abaldezjr/tcc/figuras/p20x40p2.jpg

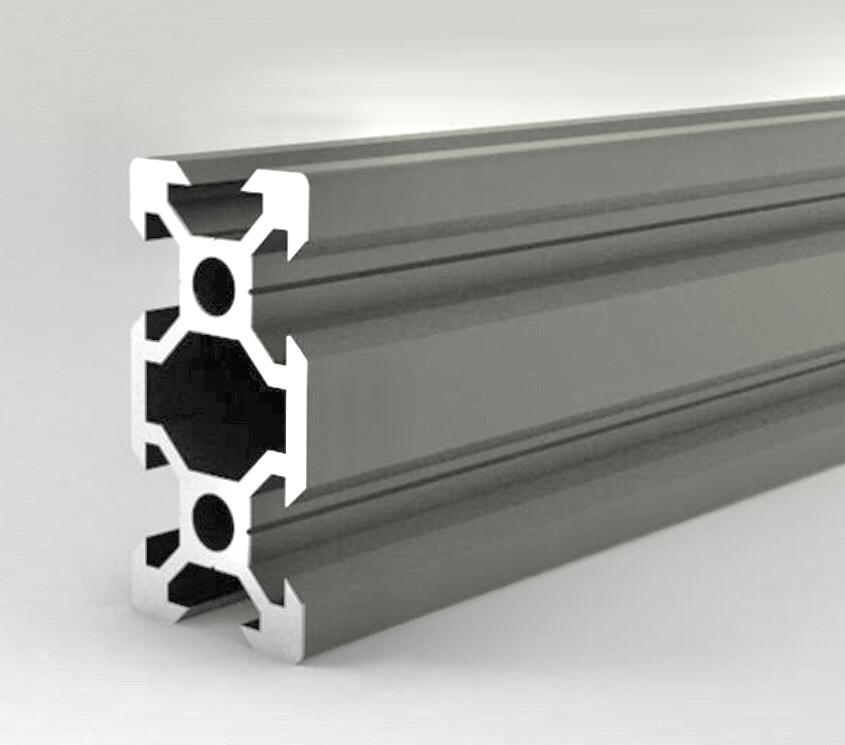
figuras/p20x40p2.jpg
