abaldezjr/tcc/figuras/driver.jpg

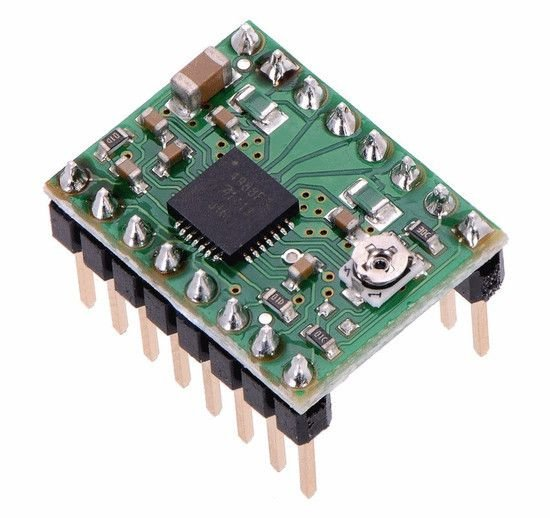
figuras/driver.jpg
