abaldezjr/tcc/README.md

# tcc-alex
 Esse repositório serve para disponibilizar uma versão em tex do meu trabalho de conclusão de curso.
