abaldezjr/tcc/elementos-pre-textuais/lista-de-simbolos.tex

\begin{simbolos} \itemsep -1pt
	\item[$d$] diâmetro da seção
	\item[$d_{arduino}$] Demanda do arduino
	\item[$d_{c}$] Diâmetro do colar
	\item[$d_{driver}$] Demanda do driver de potência
	\item[$d_{haste}$] Diâmetro da haste 
	\item[$d_{m}$] Diâmetro médio
	\item[$d_{motor}$] Demanda do motor de passo
	\item[$d_{opto}$] Demanda do optoacoplador
	\item[$d_{r}$] Diâmetro menor
	\item[$d_{total}$] Demanda total
	\item[$E$] Módulo de elasticidade
	\item[$f$] Coeficiente de fricção
	\item[$f_{c}$] Coeficiente de fricção no colar
	\item[$F$] Força
	\item[$g$] Aceleração gravitacional
	\item[$I$] Momento de inércia 
	\item[$L$] Comprimento da haste 
	\item[$L_{a}$] Avanço 
	\item[$n_{d}$] Número de dentes
	\item[$n_{e}$] Número de entradas
	\item[$n_{f}$] Número de fases
	\item[$n_{p}$] Número de passos
	\item[$P$] Passo
	\item[$P_{atm}$] Pressão atmosferica
	\item[$p_{d}$] Pressão dinâmica
	\item[$p_{e}$] Pressão estática
	\item[$p_{t}$] Pressão total
	\item[$\rho$] Massa específica
	\item[$R_{ar}$] Constante do ar
	\item[$\sigma$] Tensão normal axial
	\item[$T$] Torque
	\item[$\tau$] Tensão de cisalhamento
	\item[$T_{ar}$] Temperatura absoluta do ar
	\item[$V$] Velocidade do fluído
	\item[$Y_{max}$] Deflexão máxima 
	\item[$z$] Cota da altura
\end{simbolos}
