abaldezjr/tcc/elementos-pre-textuais/lista-de-abreviaturas-e-siglas.tex

\begin{acronym}
\acro{CNC}{Controle Numérico Computadorizado}
\acro{EEPROM}{\textit{Electrically Erasable Programmable Read-Only Memory}}
\acro{ICSP}{\textit{In Circuit Serial Programming}}
\acro{IDE}{\textit{Integrated Development Environment}}
\acro{PLA}{Poliácido Láctico}
\acro{PWM}{\textit{Pulse Width Modulation}}
\acro{RAM}{\textit{Random Access Memory}}
\acro{RISC}{\textit{Reduced Instruction Set Computer}}
\acro{USB}{\textit{Universal Serial Bus}}
\end{acronym}
