abaldezjr/tcc/elementos-pos-textuais/apendices/codigos.tex

\apendice{CÓDIGO PRINCIPAL PARA O CONTROLE DA MESA CARTESIANA}
\label{ap:MesaCartesiana}

\lstinputlisting[
    caption         = {Código principal para o controle da mesa cartesiana.}, 
    label           = code:MesaCartesiana,
    style           = mystyle
]{elementos-pos-textuais/apendices/MesaCartesiana.txt}

\apendice{CÓDIGO DA CLASSE EIXO PARA O CONTROLE DO EIXO}
\label{ap:Eixo}

\lstinputlisting[
    caption         = {Código da classe eixo para o controle do eixo.},
    label           = code:Eixo,
    style           = mystyle
]{elementos-pos-textuais/apendices/Eixo.txt}

\apendice{CÓDIGO DA CLASSE DRIVER PARA O CONTROLE DO DRIVER DE POTÊNCIA.}
\label{ap:Driver}

\lstinputlisting[
    caption         = {Código da classe driver para o controle do driver de potência},
    label           = code:Driver,
    style           = mystyle
]{elementos-pos-textuais/apendices/Driver.txt}

\apendice{CÓDIGO DA CLASSE PINO PARA O CONTROLE DOS PINOS}
\label{ap:Pino}

\lstinputlisting[
    caption         = {Código da classe Pino para o controle dos pinos.},
    label           = code:Pino,
    style           = mystyle
]{elementos-pos-textuais/apendices/Pino.txt}

\apendice{CÓDIGO DA CLASSE SIGMOIDAL PARA O CONTROLE DA ACELERAÇÃO DOS MOTORES}
\label{ap:Sigmoidal}

\lstinputlisting[
    caption         = {Código da classe Sigmoidal para o controle da aceleração dos motores.},
    label           = code:Sigmoidal,
    style           = mystyle
]{elementos-pos-textuais/apendices/Sigmoidal.txt}

\apendice{CÓDIGO DO HEADER STDRIVER PARA O INCLUDE DE CLASSES}
\label{ap:StepperDriver}

\lstinputlisting[
    caption         = {Código principal da biblioteca StDriver para o include de classes.},
    label           = code:StDriver,
    style           = mystyle
]{elementos-pos-textuais/apendices/StDriver.txt}
