abaldezjr/tcc/main.pdf

UNIVERSIDADE FEDERAL DO RIO GRANDE

ALEXANDRE MARQUES BALDEZ JUNIOR,

RODRIGO DE SOUZA TORMA

SISTEMA DE COORDENADAS PARA POSICIONAMENTO DE INSTRUMENTOS DE

MEDIÇÃO EM UM TÚNEL DE VENTO

RIO GRANDE, RIO GRANDE DO SUL

2021

ALEXANDRE MARQUES BALDEZ JUNIOR,

RODRIGO DE SOUZA TORMA

SISTEMA DE COORDENADAS PARA POSICIONAMENTO DE INSTRUMENTOS DE

MEDIÇÃO EM UM TÚNEL DE VENTO

Monografia apresentada à Universidade Federal do Rio Grande como requisito parcial para obtenção de título de Engenheiro Mecânico.

Orientador: Prof. Dr. Gustavo da Cunha Dias

Co-Orientador: Prof. Me. Letieri Rodrigues de Ávila

RIO GRANDE, RIO GRANDE DO SUL

370
S2373d | Marques Baldez Junior, Alexandre
| Sistema de Coordenadas para Posicionamento de Instrumentos de
| Medição em um Túnel de Vento / Alexandre Marques Baldez Junior. –
| Rio Grande, 2021.
| 78f.: il.
| Trabalho de conclusão de curso (graduação) – Universidade Federal do
| Rio Grande. Escola de Engenharia. Rio grande, 2021.
| Orientador Gustavo Da Cunha Dias; Co-orientador: Letieri Rodrigues de Ávila
1. Mesa cartesiana 2. Túnel de vento 3. Tubo de Pitot
I. Da Cunha Dias, Gustavo II. Rodrigues de Ávila, Letieri III. Titulo

UNIVERSIDADE FEDERAL DO RIO GRANDE Reitor: Danilo Giroldo
Pró-Reitor de Graduação: Sibele da Rocha Martins Coordenador do Curso: Márcio Ulguim Oliveira

ALEXANDRE MARQUES BALDEZ JUNIOR, RODRIGO DE SOUZA TORMA

SISTEMA DE COORDENADAS PARA POSICIONAMENTO DE INSTRUMENTOS DE MEDIÇÃO EM UM TÚNEL DE VENTO

Monografia apresentada à Universidade Federal do Rio Grande como requisito parcial para obtenção de título de Engenheiro Mecânico.

Aprovada em: 20 de maio de 2021

BANCA EXAMINADORA

Prof. Dr. Gustavo da Cunha Dias (Orientador) Escola de Engenharia
Universidade Federal do Rio Grande

Prof. Me. Letieri Rodrigues de Ávila (Co-Orientador) Escola de Engenharia
Universidade Federal do Rio Grande - FURG

Prof. Me. Fernanda Mazuco Clain Escola de Engenharia
Universidade Federal do Rio Grande - FURG

AGRADECIMENTOS

Aos meus amados pais Alexandre Marques Baldez e Gladistani Malta Vaz Baldez por

compreenderem a minha ausência enquanto eu me dedicava a realização deste trabalho, por me

ensinarem o valor da educação e pelo apoio incondicional.

A Fernanda Chaves Lopes que também me ajudou, compreendeu e ensinou nessa cami-

nhada.

Alexandre

Parte do Rodrigo

Rodrigo

Em especial gostaríamos de agradecer aos nossos queridos e incansáveis orientadores

Gustavo da Cunha Dias e Letieri Rodrigues de Ávila por acreditarem em nossa capacidade, nos

dar o suporte, amizade e terem sido indispensáveis neste ciclo.

Agradecemos a professora Fernanda Mazuco Clain que aceitou ser banca deste trabalho

colaborando para sua melhoria e nossa formação.

À Universidade Federal do Rio Grande por todo crescimento pessoal e profissional que

vem nos proporcionando

Aos amigos e companheiros de profissão que convivemos ao longo desses anos de curso,

que nos incentivaram e tiveram impacto em nossas trajetórias.

RESUMO

O presente trabalho de graduação apresenta o projeto de um sistema de coordenadas cartesianas para posicionamento de instrumentos de medição situado no túnel de vento do laboratório da Universidade Federal do Rio Grande. A concepção do projeto partiu da necessidade de precisão e repetibilidade no deslocamento e posicionamento de instrumentos de medição que caracterizam o campo de velocidade e ou pressão na seção de teste do canal aerodinâmico. Para o desenvolvimento deste sistema, foram utilizadas plataformas de hardware livre, tais como o arduino, visando o baixo custo e fácil reprodução. O sistema consiste em um aplicativo que receberá a coordenada para onde a mesa deve se movimentar. O projeto pode ser dividido em três partes: mecânica, na qual envolve a disposição dos componentes mecânicos; elétrica, na qual se projetou os circuitos elétricos; e a programação, na qual foi desenvolvido o sistema de comando do aplicativo e a mesa. Logo, para a montagem do sistema eletrônico foram utilizados uma placa controladora Arduino Uno, drivers de potência, motores de passo, optoacopladores, encoders. Já para o sistema mecânico foram utilizados eixos, mancais, rolamentos, fusos e estrutura base/pórtico em alumínio.

Palavras-chave: Túnel de vento. Tubo de Pitot. Arduino. Mesa cartesiana

ABSTRACT

The present graduation work presents the project of a system of Cartesian coordinates for positioning measuring instruments located in the wind tunnel of the laboratory of the Federal University of Rio Grande. The design of the project started from the need for precision and repeatability in displacement and positioning of measuring instruments that characterize the speed and / or pressure field in the test section of the streamline. For the development of this system, free hardware platforms were used, such as arduino, aiming at low cost and easy reproduction. The system consists of an application that will receive the coordinate to where the table should move. The project can be divided into three parts: mechanical, in which it involves the disposition of mechanical components; electrical, on which the electrical circuits were designed; and the programming, in which the application’s command system was developed and the cartesian table. Therefore, for the composition of the electronic system an Arduino Uno controller board, power drivers, stepper motors, optocouplers and encoders were used. For the mechanical system, axes, shafts, bearings, spindles and aluminum structure (base, tower) were used.

Keywords: Wind tunnel. Pitot tube. Arduino. Cartesian table.

LISTA DE ILUSTRAÇÕES

LISTA DE TABELAS

Tabela 2 – Sequência de passos com uma fase (wavestep) para movimentação no sentido

Tabela 3 – Sequência de passos com duas fases (fullstep) para movimentação no sentido

Tabela 4 – Sequência de passos com meio passo (halfstep) para movimentação no sen-

Tabela 5 – Sequência de passos com uma fase (wavestep) para movimentação no sentido

Tabela 6 – Sequência de passos com duas fases (fullstep) para movimentação no sentido

Tabela 7 – Sequência de passos com meio passo (halfstep) para movimentação no sen-

Tabela 10 – Declaração e funcionalidade dos atributos e métodos da classe Sigmoidal. . | 42
Tabela 12 – Declaração e funcionalidade dos atributos e métodos da classe Driver. . . . | 44

LISTA DE ABREVIATURAS E SIGLAS

CNC Controle Numérico Computadorizado

EEPROM Electrically Erasable Programmable Read-Only Memory

ICSP In Circuir Serial Programming

IDE Integrated Development Environment

PWM Pulse Width Modulation

RAM Random Access Memory

RISC Reduced Instruction Set Computer

USB Universal Serial Bus

LISTA DE SÍMBOLOS

g | Força gravitacional
ρar | Massa específica do ar
ρ | Massa específica do fluido
Patm | Pressão atmosferica
p1 | Pressão estática no ponto 1
pd | Pressão dinâmica
pe | Pressão estática
pt | Pressão total
p2 | Pressão total
V1 | Velocidade do fluído no ponto 1

SUMÁRIO

APÊNDICE A – CÓDIGO PRINCIPAL PARA O CONTROLE DA MESA

APÊNDICE B – CÓDIGO DA CLASSE EIXO PARA O CONTROLE DO

APÊNDICE C – CÓDIGO DA CLASSE DRIVER PARA O CONTROLE

APÊNDICE D – CÓDIGO DA CLASSE PINO PARA O CONTROLE DOS

APÊNDICE E – CÓDIGO DA CLASSE SIGMOIDAL PARA O CON-

APÊNDICE F – CÓDIGO DO HEADER STDRIVER PARA O INCLUDE

### 1 INTRODUÇÃO

A mecânica dos fluidos é uma área muito complexa da engenharia, mesmo com todo o

avanço tecnológico e computacional nem sempre é possível projetar com precisão sem se valer

de uma análise prévia da ação de esforços sobre algum material. O estudo da ação do ar sobre

estruturas pode ser um fator determinante entre o sucesso e o fracasso de um projeto.

A análise aerodinâmica, se bem conduzida, pode apresentar dados confiáveis ao projetista

para o apoio na tomada de decisão. Uma das maneiras de realizar estes estudos é através das

leis de similaridade que aplicam os adimensionais de fatores de escala para replicar resultados

em escalas reais. Assim, de uma forma menos onerosa é possível se fazer esse estudo em escala

reduzida e com condições controladas em laboratório. Os túneis de vento são as bancadas de

testes para estudos de escoamento de ar, onde é possível simular cenários e avaliar a interação do

fluido e estrutura.

Complementar a um controle de escoamento no túnel de vento estão os instrumentos para

as grandezas físicas (i. e. pressão e velocidade). O tubo de Pitot e a Sonda de anemômetro de fio

quente são exemplos de instrumentos de medição, usados dentro desses canais aerodinâmicos.

A operação desses equipamentos dentro do túnel de vento pode ser de forma manual

ou automatizada. A primeira tende a gerar imprecisões, como o posicionamento incorreto do

sensor em relação ao seus eixos vertical e horizontal, além de um gasto considerável de tempo e

energia, pois o operador, para fazer o reposicionamento do equipamento, deve desligar o túnel,

abri-lo e posicionar o equipamento para fazer a próxima medição, gerando assim incertezas de

operação. Já a atuação automatizada resolve todos os problemas acima citados, porém o processo

de implantação é mais dispendioso.

A realização desse trabalho justifica-se por desenvolver um equipamento que agregue

um sistema de coordenadas bidimensional para posicionamento de instrumentos de medição no

túnel de vento do Laboratório de Sistemas Térmicos da Universidade Federal do Rio Grande.

1.1 OBJETIVO GERAL

Desenvolver um dispositivo para o posicionamento de equipamentos de medições dentro

de um túnel de vento para facilitar o processo de avaliação de velocidades e pressões de forma

automatizada.

1.2 OBJETIVOS ESPECÍFICOS

- Projetar a mesa cartesiana.
- Criar o sistema de comunicação entre a mesa e o software.
- Desenvolver o software que comandará a mesa cartesiana.

1.3 ESTRUTURA DO TRABALHO

Na primeira seção são apresentados: o tema do projeto, os objetivos, a justificativa e a

estrutura do trabalho.

A segunda seção apresenta a revisão bibliográfica a fim de ser referência neste estudo e

para fundamentar a base teórica utilizada no trabalho.

A terceira seção apresenta a metodologia e detalhamento dos componentes do projeto em

si, que envolve o projeto do sistema mecânico, sistema elétrico, desenvolvimento do software e a

integração dos sistemas.

A quarta seção apresenta os resultados referentes a cada sistema.

A quinta seção apresenta as considerações finais, críticas e sugestões para trabalhos

futuros.

Por último são dispostas as referências bibliográficas e apêndices.

### 2 REFERENCIAL TEÓRICO

Esta seção dispõe de uma breve revisão bibliográfica de assuntos referentes ao tema do

projeto, que são os seguintes: túneis de vento, tubos de Pitot e mesas de posicionamento. Por

fim, apresenta trabalhos relacionados que envolvem estes assuntos.

2.1 TÚNEL DE VENTO

Os túneis de vento são estruturas que propiciam a simulação para o desenvolvimento de

estudos que relacionam o efeito do movimento de ar em torno de objetos, como turbinas, aviões,

carros e edificações. Sua estrutura é composta por um duto de diâmetro adequado onde o ar é

empurrado ou succionado por um ventilador. No interior do duto, o ar é analisado através de

instrumentos de medição.

O primeiro túnel de vento foi construído na Inglaterra em 1871 por Frank H. Wenham

(1824-1908), engenheiro naval britânico e membro da Sociedade Aeronáutica da Grã-Bretanha,

esse túnel era de circuito fechado e acionado por uma máquina a vapor. Os estudos de Wenham

permitiram um aperfeiçoamento no alongamento de uma asa relacionado à força de sustentação

(CARMINATTI; KONRATH, 2019).

Em 1897 foi construído por Konstantin Tsiolkovsky o primeiro túnel de vento Russo que

era de circuito aberto com um ventilador centrífugo e determinou os coeficientes de arrasto de

placas planas, cilindros e esferas (JOGLEKAR; MOURYA, 2014).

Devido às guerras, a produção de túneis de vento teve uma demanda aumentada, pois era

necessário a execução de ensaios em aeronaves militares. Já após o período de guerras, os túneis

de vento ganharam relevância quando o objetivo foi aumentar a eficiência na aerodinâmica dos

carros (SANTOS et al., 2014).

Os túneis de vento podem ser classificados quanto ao circuito que pode ser aberto ou

fechado, quanto a velocidade de escoamento em relação à velocidade do som que é chamada

de número de Mach (Ma) definindo os escoamentos como sônico, subsônico, supersônico e

hipersônico e quanto ao sentido do escoamento que nos túneis de vento de circuito aberto podem

ser soprador e sugador, sendo definido pela condição de trabalho do ventilador (PRITCHARD;

MITCHELL, 2005).

O túnel de vento tratado neste trabalho está situado junto ao Laboratório de Sistemas

Térmicos da Universidade Federal do Rio Grande e é de característica subsônica, circuito aberto

e do tipo soprador.

2.2 TUBO DE PITOT

O tubo de Pitot foi um equipamento criado por Henri Pitot em 1732 para medição da

vazão do rio Sena. Pitot de maneira intuitiva apresentou que a altura de uma coluna de líquido

conectada ao seu tubo era proporcional à raiz quadrada da velocidade. Ele desenvolveu a técnica

mais comum para determinação da velocidade de um fluido, pois a utilização desse tubo é

simplificada, além do baixo custo.

O tubo de Pitot apresenta vantagens como sua flexibilidade na utilização de diferentes

faixas de velocidade desde o regime subsônico ou supersônico, sendo possível a obtenção de

velocidades com alta precisão. No entanto apresenta desvantagens de falta de precisão em baixas

velocidade, impossibilidade de medição em escoamentos reversos e dificuldade de obtenção de

medições em alta frequência.

Com essa técnica, Pitot obteve a velocidade em um escoamento incompressível em uma

área pontual, sendo que é necessário o tubo ser posicionado de modo a ficar alinhado com

o escoamento. Com isso se mede a pressão estática e a pressão total ou de estagnação. A

subtração da pressão total da estática resulta na pressão dinâmica do escoamento (PRITCHARD;

MITCHELL, 2005).

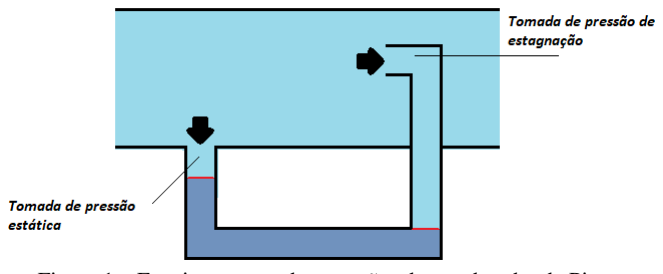
[picture p3: figure]

Figura 1 – Funcionamento das pressões dentro do tubo de Pitot. Fonte: Próprio autor.

Seu princípio de funcionamento está baseado na conhecida equação de Bernoulli onde a

pressão dinâmica (pd) é igual a pressão total (pt) menos a pressão estática (pe) (PRITCHARD;

MITCHELL, 2005).

pd = pt − pe | (2.1)

p1

ρ

+

1
2

·(V1)

2 +g ·z1 =

p2

ρ

+

1
2

·(V2)

2 +g ·z2 = cte | (2.2)

pe +

1
2
- ρ ·(V)

2 +ρ · g ·ze = pt +

1
2
- ρ ·(0)
2 +ρ · g ·zt = cte | (2.3)

V =

s
2 ·(pt − pe)

ρ

(2.4)

ρar =

Patm

Rar ·Tar

(2.5)

Sendo que p1 é a pressão estática no ponto 1, V1 é a velocidade do fluído no ponto 1, ρ é

a massa específica do fluido, g é a força gravitacional e p2 é a pressão total.

A equação 2.4 serve para obter a velocidade a partir da pressão e é obtida através da

equação de Bernoulli para regime permanente, incompressível e sem atrito conforme a equação

2.2. Percebe-se que a massa específica é função da condição de estado do ar durante os testes

sendo determinada a partir da Equação 2.5. Onde Rar é e Tar é...

2.3 MESA DE POSICIONAMENTO

Utilizada para várias finalidades como, posicionamento de peças que serão usinadas

em máquinas de Controle Numérico Computadorizado (CNC), automação de laboratórios,

armazenamento de cargas, impressões 3D entre outros tantos propósitos, as mesas cartesianas

tem como função principal o posicionamento de alguma ferramenta, para executar algum tipo de

serviço.

Também conhecidas como mesa de posicionamento XY, pois como o nome sugere, é uma

estrutura com dois eixos de liberdade que permite o posicionamento da peça ou da ferramenta

em algum lugar de um plano pré-definido. Podem ser classificadas em dois tipos com relação a sua transmissão: as mesas acionadas por fusos conforme apresenta a Figura 2 e as acionadas por

correias sincronizadas demonstradas na Figura 3.

As mesas de posicionamentos de fuso possuem um alto rendimento, próximo de 95%,

um baixo desgaste e uma velocidade máxima de 3 m/s, já as mesas acionadas por correias

sincronizadas podem desenvolver velocidades de até 5 m/s, conseguindo altas acelerações devido

a sua inércia (ROCHA et al., 2015).

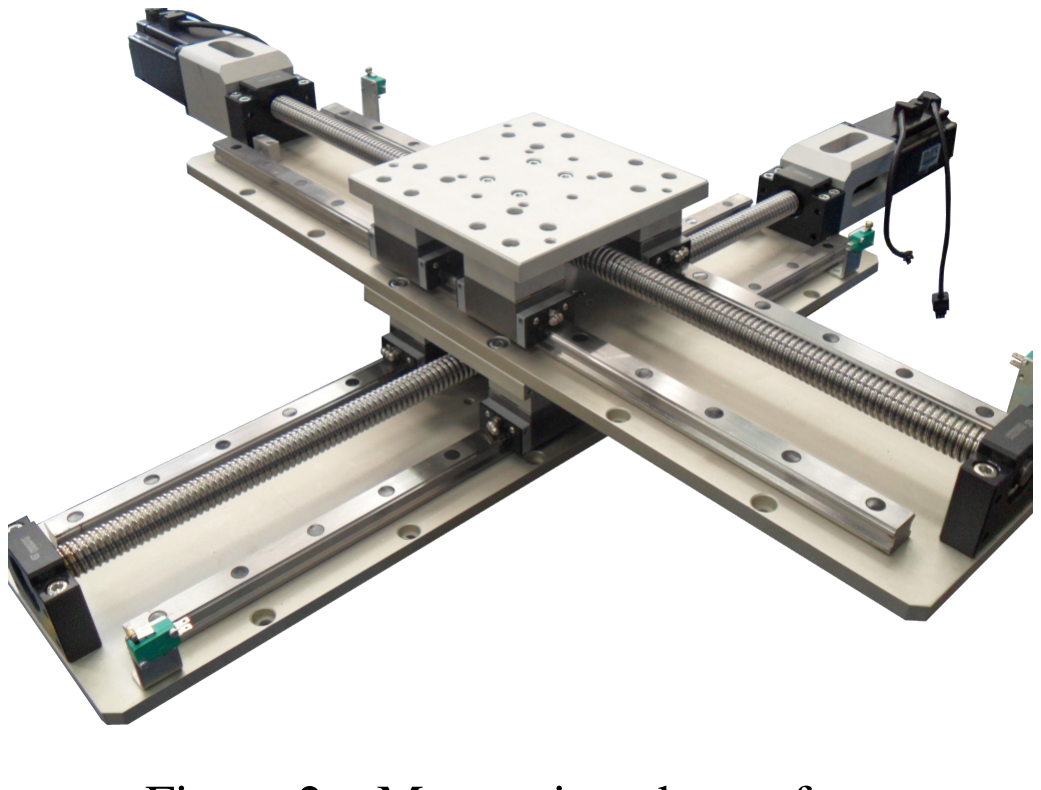
[picture p4: figure]

Figura 2 – Mesa acionada por fuso. Fonte: https://www.kalatec.com.br/mesa-de-coordenada-xy/

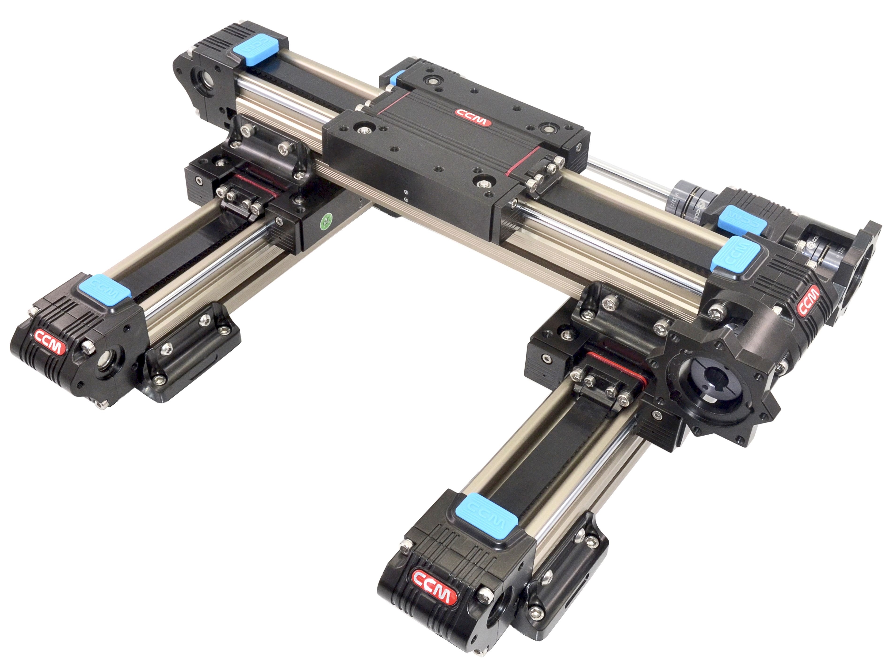
[picture p5: figure]

Figura 3 – Mesa acionada por correias. Fonte: https://www.ccmrails.com/2019/01/26/packing-automation/

Outro componente importante nesse mecanismo é o acionador, que pode ser um motor

de passo ou um servomotor. Os motores de passo são máquinas que exercem um papel muito

importante atualmente, são utilizados em aplicações onde é requerido um alto grau de precisão

no movimento e que este movimento seja feito em passos fixos, referentes a uma fração de ângulo. Empregados normalmente quando se deseja controlar uma combinação entre a posição

do rotor (ângulo), com a devida velocidade e o sincronismo (JÚNIOR; SILVA, 2018).

O funcionamento desse motor se dá através dos princípios do eletromagnetismo, com

estatores bobinados e um rotor formado por ímãs permanentes ligados ao eixo. Quando o estator

é energizado cria um campo magnético e o rotor move-se para alinhar os ímãs (pólos norte e sul)

com as linhas de fluxo magnético, formados pelo estator, movendo o eixo em um ângulo pequeno

chamado de passo e continua a girar conforme o incremento angular controlado por circuitos

eletrônicos. Esses circuitos digitais tem como função repassar a informação, um pulso, recebido

pelo sistema de controle para o motor, que gira com grande precisão conforme seu controle.

Como característica marcante, os motores com ímãs permanentes apresentam um torque estático

quando não submetidos à tensão devido a força magnética entre os ímãs e o estator, servindo

como freio para o sistema.

2.4 TRABALHOS RELACIONADOS

Nesta seção serão apresentados trabalhos relacionados ao tema deste projeto apresentando

os objetivos e resultados de cada um.

O trabalho realizado por BUTIGNOL (2017), tinha o objetivo de desenvolver uma ade-

quação de uma mesa XYZ didática acionada por motores de passo para o estudo de programação

em em microcontroladores e seu posicionamento em duas dimensões.

Como resultado do trabalho, BUTIGNOL (2017) desenvolveu um aparato eletromecânico

de posicionamento de dois eixos e um atuador no terceiro eixo capaz de auxiliar no ensino de mi-

crocontroladores. Por fim, o projeto está disponível em <https://mesaxydidatica.blogspot.com.br>

para sua montagem em outras instituições de ensino.

O trabalho realizado por CAMARGO et al. (1988), tinha o objetivo de desenvolver um

sistema posicionador de baixo custo com CNC, utilizando componentes nacionalizados e com

uma complexidade mínima no sistema de comando.

Como resultado do trabalho, CAMARGO et al. (1988) fez uma análise comparando

diversos parâmetros como: massa, frequência natural amortecida, amplitude média da curva de

resposta, perdas de passo, erros de posicionamento, vibração entre outros a fim de demonstrar

que a concepção projetada e executada para a mesa de coordenadas XY presente em seu estudo,

se justifica com os resultados obtidos.

O trabalho realizado por RAMOS (2018), tinha o objetivo de projetar e construir uma mesa cartesiana para ser colocada nos túneis aerodinâmicos existentes no Departamento de

Engenharia Mecânica e Industrial da Faculdade de Ciências e Tecnologia Universidade Nova

de Lisboa, para assim, dar a capacidade de deslocamento de sensores como: tubo de Pitot,

anemômetro de fio quente, anemômetro laser-Doppler para qualquer ponto na seção escolhida.

Como resultado do trabalho, RAMOS (2018) construiu uma mesa cartesiana funcional

com capacidade de efetuar medições de velocidade em uma malha de cem posições, podendo

inserir coordenadas através da porta serial do Arduino. Ainda comprovou por testes experimentais

a precisão dos motores de passo ao comprovar que não existe diferença mensurável entre o

valores medidos com os ideais.

O trabalho realizado por HOSS (2018), tinha o objetivo a instrumentação e desenvolvi-

mento do sistema de controle de velocidade do vento de um túnel de vento com propulsão por

motor a combustão interna, existente no laboratório de Conformação do IFSC Campus Chapecó.

Como resultado do trabalho, HOSS (2018) alcançou o objetivo permitindo medir variáveis

de forma confiável com incertezas pequenas dentro dos requisitos estabelecidos, mesmo com

emprego de sensores de baixo custo e média precisão.

### 3 METODOLOGIA

A metodologia desse projeto será dividida em quatro fases: sistema mecânico, sistema

eletrônico, desenvolvimento do sistema de software e integração dos sistemas.

3.1 SISTEMA MECÂNICO

Nessa sessão será desenvolvido o projeto de sistema mecânico que se divide em estrutura

e componentes. Para compreensão facilitada do projeto, os cálculos de resistência e equilíbrio

foram desconsiderados, já que o equipamento é de pequena escala.

### 3.1.1 Estrutura

A estrutura ou mesa cartesiana, como é chamada neste trabalho, compõem o sistema

mecânico junto com seus componentes, é a parte responsável por manter a união das peças que

ela a compõem e também servir de base para o posicionamento dentro da área de testes do túnel

de vento. Como o túnel de vento do Laboratório de Sistemas Térmicos da Universidade Federal

do Rio Grande é utilizado para atividades de pesquisa em energia renovável e fenômenos de

transporte, optou-se por projetar uma estrutura móvel, que pode ser colocada e retirada de dentro

do túnel, quando há a necessidade da caracterização do canal aberto. Para que essa operação se

torne prática a mesa deve ser leve e resistente.

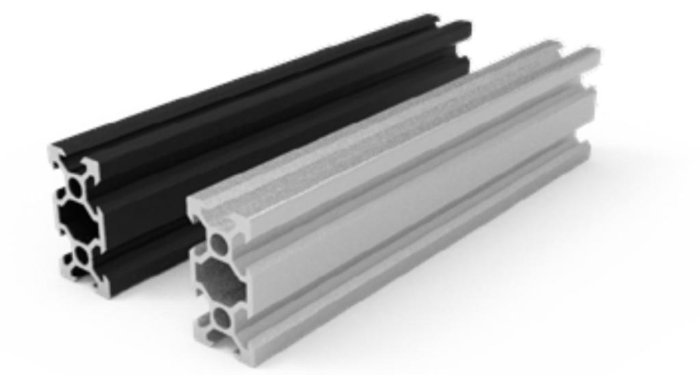
[picture p6: figure]

Figura 4 – Perfil v_slot 20x40 mm em alumínio. Fonte: www.forsetisolucoes.com.br

Por ser um metal leve, durável e resistente, o alumínio se torna uma boa opção para

a confecção desta estrutura. Com uma alta relação resistência/peso, confere um excepcional

desempenho, além de dar um ótimo acabamento à peça. A estrutura de metal será dividida em

duas partes, a base e o pórtico. A base será o componente que terá a função de dar estabilidade a

mesa e evitar que esta venha a tombar, terá um formato retangular de 500x400 mm e será feito

com um perfil v_slot de 20x40 mm em alumínio, conforme apresentado na Figura 4. Para fazer a

união dos perfis, que serão cortados em tamanho adequado com cantos esquadrejados em ângulo

de 45 graus, para dar um melhor acabamento à peça, será utilizada uma placa de conexão interna

de 90 graus, conforme Figura 6, que unirá os cantos dos perfis por meio de parafusos Allen sem

cabeça M5.

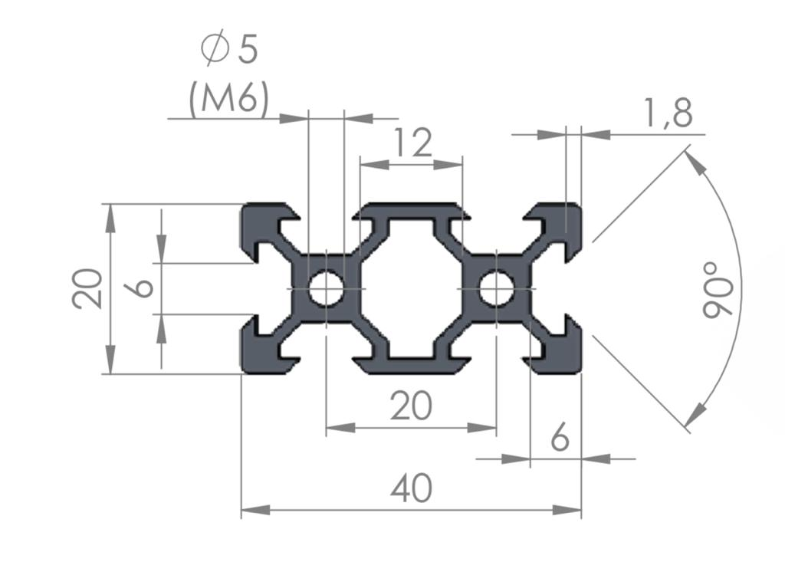
[picture p7: figure]

Figura 5 – Dimensões do perfil 20x40 mm. Fonte: www.forsetisolucoes.com.br

O pórtico será feito com o perfil v_slot de 20x20 mm em alumínio conforme apresenta a

Figura 10, e terá as dimensões de 500x480 mm. Sua função é sustentar e estabilizar o sistema

de transmissão. Para fixação do pórtico à base será utilizada uma placa T simples de aço. Na

montagem da parte superior do pórtico a união se dará por meio de parafusos M6 diretamente

nos perfis.

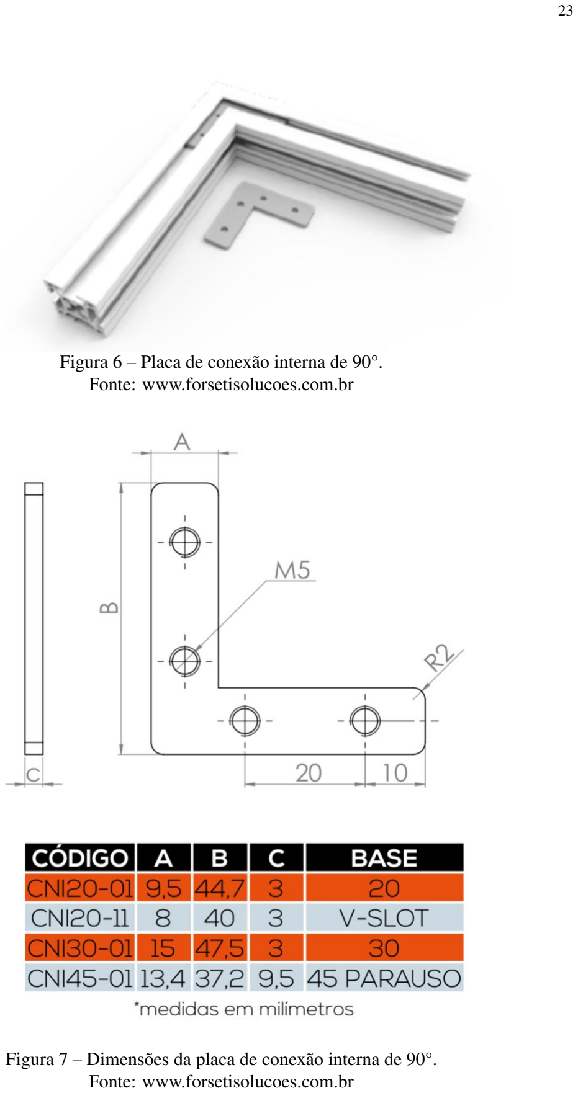
[picture p8: page 24]

Figura 6 – Placa de conexão interna de 90°. Fonte: www.forsetisolucoes.com.br

Figura 7 – Dimensões da placa de conexão interna de 90°. Fonte: www.forsetisolucoes.com.br

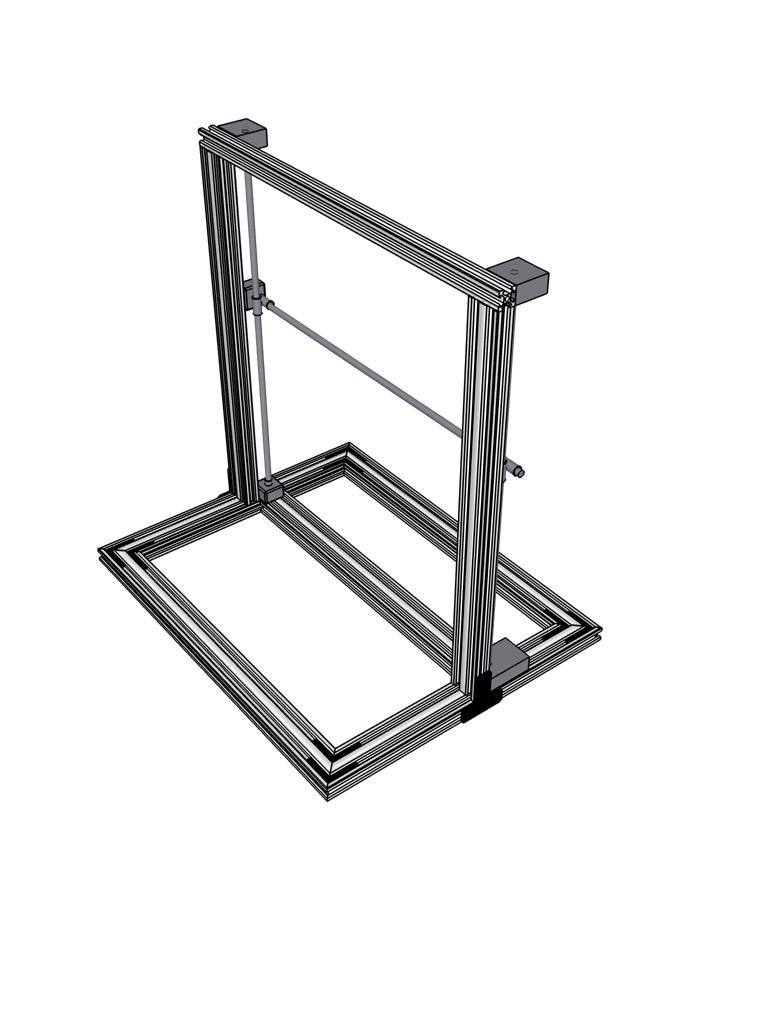
[picture p9: figure]

Figura 8 – Estrutura da mesa cartesiana. Fonte: Próprio autor

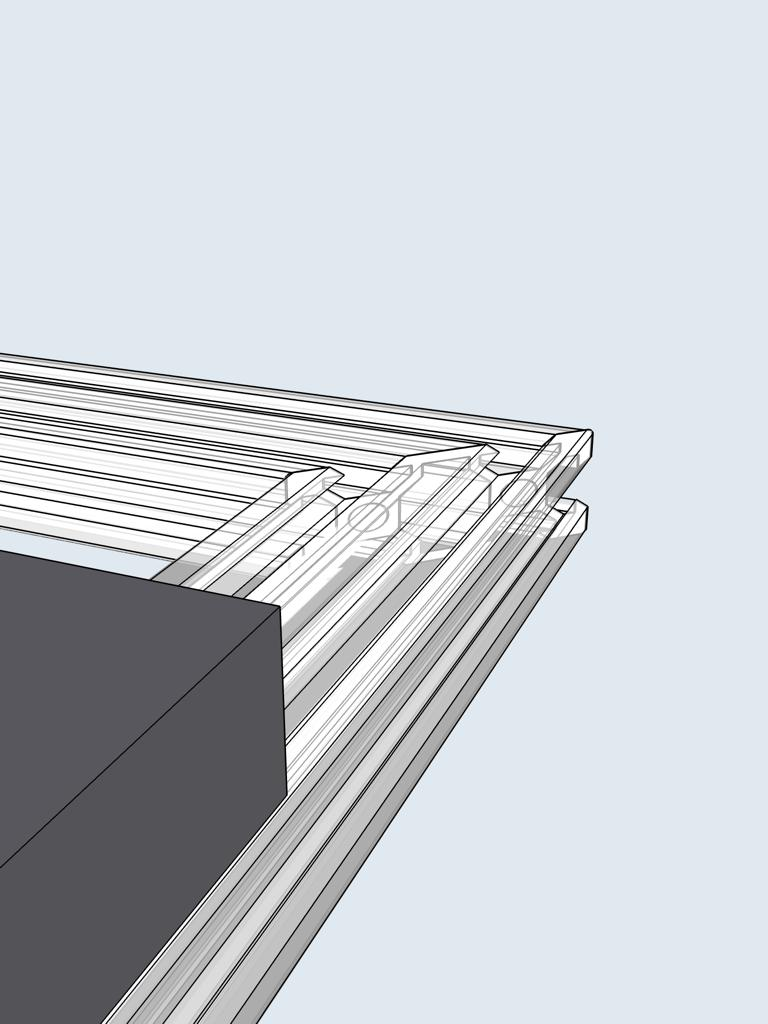
[picture p10: figure]

Figura 9 – Detalhe do encaixe a 45° da base da estrutura. Fonte: Próprio autor

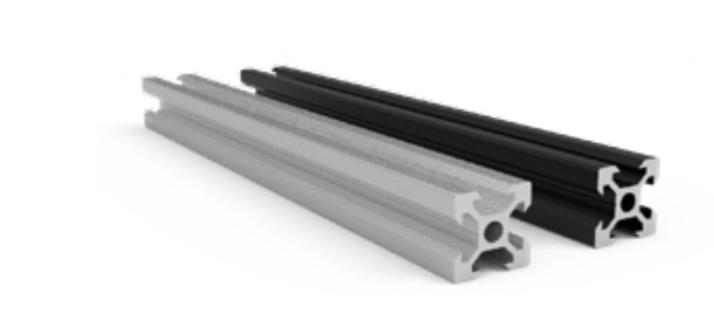
[picture p11: figure]

Figura 10 – Perfil v_slot 20x20 mm em alumínio. Fonte: www.forsetisolucoes.com.br

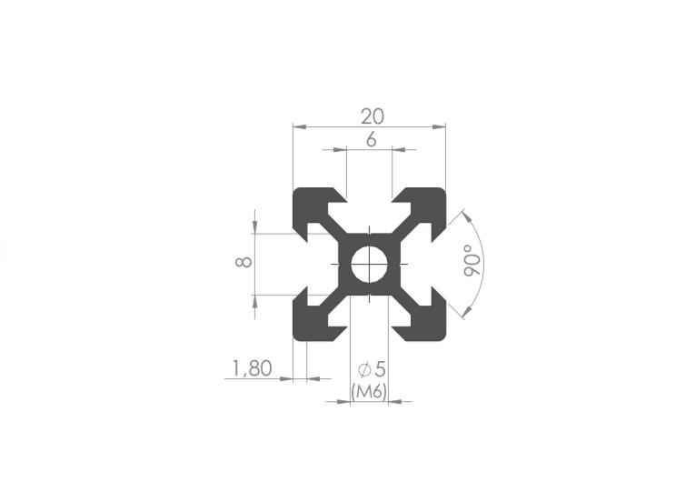
[picture p12: figure]

Figura 11 – Dimensões do perfil 20x20 mm. Fonte: www.forsetisolucoes.com.br

### 3.1.2 Sistema de transmissão

Segundo BUDYNAS; NISBETH (2016), o parafuso de potência é um dispositivo usado

para transformar o movimento angular em movimento linear e, usualmente, para transmitir

potência. Para fazer o movimento dos carros do eixo X e do eixo Y, componentes que farão o

efetivo deslocamento do equipamento de medição dentro da área de teste do túnel de vento, o

fuso foi escolhido como elemento de transmissão, que vai transformar o movimento giratório do

motor de passo em deslocamento linear na estrutura da mesa cartesiana. Acoplados aos motores

de passo, por meio de acopladores de eixo e na outra extremidade por mancal para fuso de 8 mm,

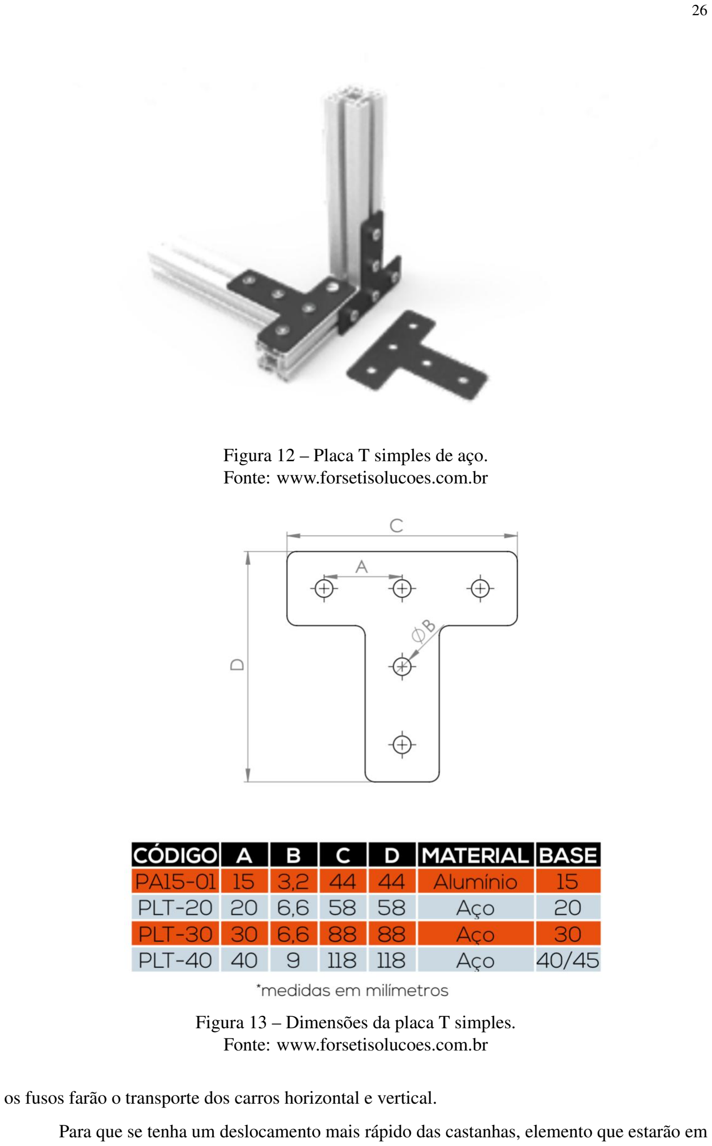
[picture p13: page 27]

Figura 12 – Placa T simples de aço. Fonte: www.forsetisolucoes.com.br

Figura 13 – Dimensões da placa T simples. Fonte: www.forsetisolucoes.com.br

os fusos farão o transporte dos carros horizontal e vertical.

Para que se tenha um deslocamento mais rápido das castanhas, elemento que estarão em contato direto com o fuso e o carro, foi selecionado o fuso trapezoidal de 8 mm de diâmetro e

8 mm de passo. Será utilizado uma guia para o deslocamento horizontal, para o deslocamento

vertical será utilizado um fuso acoplado ao motor é uma guia no lado oposto, apenas para dar

suporte ao elemento que fixará o fuso horizontal.

### 3.1.3 Acionador

Os motores elétricos são máquinas capazes de transformar energia elétrica em energia

mecânica, essa energia se dá em forma de movimento angular. São equipamentos versáteis,

muito eficientes e amplamente utilizados. Para fazer a movimentação dos carros, nos eixos X e

Y, optou-se por motores de passo, por que é um motor que possibilita o controle da velocidade e

o posicionamento preciso, pois rotaciona em ângulos bem definidos, chamados de passos. O

ponto negativo desses motores é que o controle é mais complexo, necessitando de um comando

eletrônico digital para fazê-lo funcionar, por outro lado apresenta uma grande precisão no

seu movimento. Os motores serão acoplados aos perfis da estrutura de modo a possibilitar o

movimento dos fusos e consequentemente o equipamento de medição, que estará preso a ele por

meio de uma guia com roldana.

3.2 SISTEMA ELETRÔNICO

O sistema eletrônico de uma mesa cartesiana foi dividido em módulos para um melhor

detalhamento: placa de prototipagem eletrônica Arduino, drivers de potência, atuadores elétricos,

fonte de alimentação, optoacopladores, encoders e um computador. É importante lembrar que

para menor custo do projeto optou-se pela criação de dispositivos.

### 3.2.1 Placa de prototipagem eletrônica Arduino

A placa de prototipagem eletrônica Arduino é responsável pela recepção e tratamento

dos dados provenientes da interface computacional. O controle dos motores está fundamentado

na programação do microcontrolador de acordo com as necessidades definidas inicialmente para

operação da mesa cartesiana.

Com o objetivo de elaborar uma interface de prototipagem de baixo custo para uso em

projetos escolares, o arduino foi criado por um grupo de pesquisadores na Itália em 2005. Na

sua concepção, para ter maior flexibilidade a diversos tipos de projetos, isto é, para que qualquer

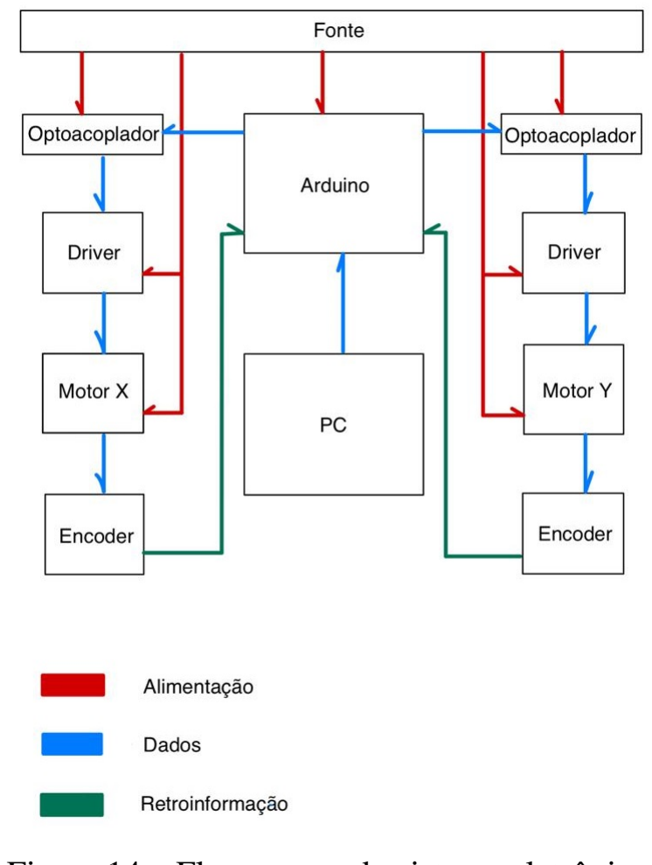
[picture p14: figure]

Figura 14 – Fluxograma do sistema eletrônico. Fonte: Próprio autor.

projetista pudesse personalizá-lo, foi adotado o conceito de hardware livre.

Em sua composição, a placa Arduino UNO contém um microcontrolador ATMEL AT-

MEGA328, que é um dispositivo de 8 bits da família AVR com arquitetura Reduced Instruction

Set Computer (RISC) avançada e com encapsulamento DIP28, além de quatorze portas digitais

de entrada e saída, sendo que seis delas com capacidade de Pulse Width Modulation (PWM),

seis entradas analógicas e 32 KB de memória flash, 2 KB de Random Access Memory (RAM) e

1 KB de Electrically Erasable Programmable Read-Only Memory (EEPROM).

A alimentação é via porta Universal Serial Bus (USB) ou por conector tipo Jack de

alimentação externa que trabalha entre os limites de 6 V e 20 V sendo recomendável o uso de

7 V a 12 V para não danificar. Para o fornecimento de tensão contínua para alimentação dos

circuitos e Shields, a placa Arduino UNO tem um regulador de tensão de 3,3 V.

Além de alimentar, a porta USB é a via de comunicação com o computador para o

envio do código de máquina gerado pelo compilador. O código compilado é enviado pelo

microcontrolador ATMEL ATMEGA16U2 que está conectado a dois LEDs chamados de TX e

RX cuja função é a indicação do envio e recepção dos dados da placa para o computador.

A placa Arduino é programada via Integrated Development Environment (IDE), utilizando uma linguagem baseada em C/C++.

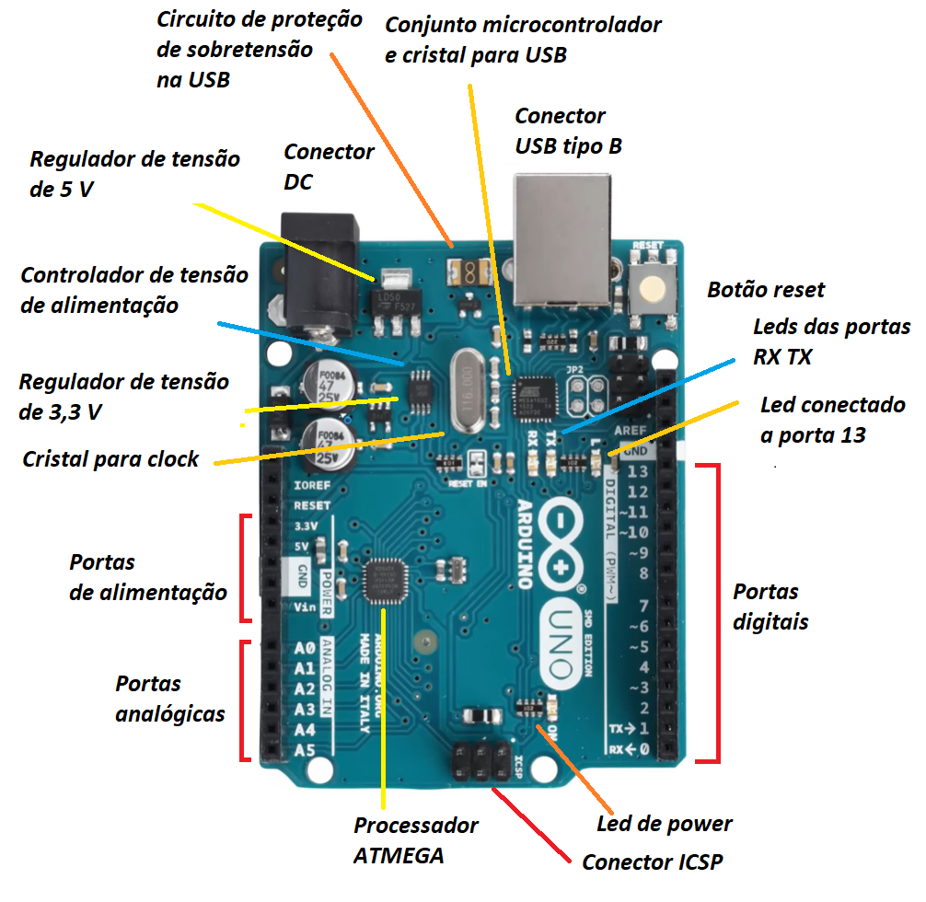
[picture p15: figure]

Figura 15 – Descrição dos componentes da placa Arduino. Fonte: Próprio autor.

- Botão reset: o botão reset serve para reiniciar a placa arduino.
- Conector USB tipo B: o conector USB tipo B serve para conectar a placa Arduino ao

computador.

- Conector DC: o conector DC serve para alimentação externa do Arduino.
- Portas digitais: são às portas que trabalham com os sinais digitais que são sinais com

valores discretos, no arduino temos às constantes LOW que significa 0 V e também HIGH

que significa 5 V, no código são 0 e 1 respectivamente. Dentro das portas digitais temos

às portas PWM que são portas que modulam o sinal pela largura do pulso, no arduino

podemos variar de 0 a 255. Resumidamente, a placa Arduino possui quatorze portas

digitais, sendo que seis delas são portas PWM como dito anteriormente, os pinos delas são

3, 5, 6, 9, 10 e 11.

- Portas analógicas: são às portas que trabalham com os sinais analógicos que são sinais

com valores contínuos, no arduino podemos variar de 0 a 1023.

- Portas de alimentação: são às portas de saída de tensão do arduino, temos três portas:

porta 3,3 V cuja saída trabalha em 3,3 V, porta 5 V cuja saída trabalha em 5 V e a porta

Vin cuja saída trabalha com a tensão de entrada do arduino.

- Led porta 13: led conectado a porta 13 do arduino.
- Leds das portas RX TX: leds conectados às portas RX TX, sendo que o led TX serve

para indicar a transmissão de dados e o RX para indicar a recepção de dados.

- Processador ATMEGA328: o processador é responsável pelo processamento da lógica

de programação.

- Led de power: led que acende quando o arduino está ligado.
- Conector In Circuir Serial Programming (ICSP): o conector ICSP, que se refere a

capacidade de programar Arduinos diretamente dos seus microcontroladores.

- Conjunto microcontrolador e cristal para USB: esse conjunto possui um microcontro-

lador ATMEGA16U2 e um cristal externo de 16 MHz, e é responsável pelo gerenciamento

da porta USB.

- Circuito de proteção de sobretensão na USB: responsável por proteger a entrada USB

de sobretensão.

- Controlador de tensão de alimentação: esse controlador é responsável por verificar se a

tensão DC está presente, se não estiver, deixa que a tensão da USB alimente o circuito.

- Regulador de tensão de 5 V: serve para regular a tensão em 5 V.
- Regulador de tensão de 3,3 V: serve para regular a tensão em 3,3 V.
- Cristal para clock: serve para gerar o clock.

### 3.2.2 Drivers de potência

Os drivers de potência são dispositivos que conservam sinais fundamentais de entrada

em suas saídas, potencializando e fornecendo maior corrente elétrica para equipamentos atu-

adores. Os drivers de potência podem ser formados por elementos eletromecânicos (relés) e

semicondutores (diodos, transistores, e circuitos integrados).

No presente projeto, os drivers têm a função de, a partir dos sinais originados pelo

Arduino, atender a demanda dos motores de passo utilizados.

A equipe do projeto optou por desenvolver para a mesa cartesiana que necessita de dois

Tabela 1 – Parâmetros do driver de potência.
Parâmetro | Magnitude
Tensão lógica mínima | 3 V
Tensão lógica máxima | 5,5 V
Corrente contínua por fase | 1 A
Corrente máxima por fase | 2 A
Tensão de operação mínima | 8 V
Tensão de operação máxima | 35 V
Fonte: Próprio Autor, 2021.

atuadores (motores de passo), drivers individuais para cada motor devido ao custo que seria

menor.

A construção dos drivers que controlam os motores de passo da mesa cartesiana foi

baseada em um circuito eletrônico para motores que trabalham com tensão de 12 V DC e até

10 A de corrente elétrica.

Figura 16 – Driver fabricado pela equipe do projeto. Fonte: Próprio autor.

O driver criado foi utilizado para controlar motores de passo e pode operar com tensões

entre 8 V e 35 V e entregar até 35 V por bobina. A Figura 17 mostra o driver com os respectivos

componentes.

Figura 17 – Portas do driver fabricado pela equipe do projeto. Fonte: Próprio autor.

AQUI EMBAIXO UMA EXPLICAÇÃO DA IMAGEM DAS PORTAS, EXPLICANDO

PARA QUE SERVE CADA PORTA COMO SE FOSSE UM DATASHEET DO DRIVER

CRIADO

### 3.2.3 Atuadores

Atuadores são equipamentos ou dispositivos elétricos que convertem energia hidráulica,

pneumática ou elétrica em energia mecânica. A energia gerada nos atuadores é transformada em

movimento em vários tipos de processos.

Os atuadores utilizados neste projeto foram os elétricos que se dividem em motores

elétricos de corrente alternada e contínua, servomotores e motores de passo. Esses atuadores

convertem pulsos elétricos recebidos em seus terminais em energia mecânica transformando-a

em movimento rotativo do motor, no caso do projeto os motores de passo que controlam o

movimento dos fusos da mesa cartesiana. Os atuadores elétricos atendem a comandos manuais

ou programáveis, localmente ou remotamente. Eles se destacam por uma transmissão de potência

simplificada e eficiente do ponto de vista de energia.

Os motores de passo são atuadores eletromagnéticos com capacidade de converter pulsos

elétricos digitais recebidos em movimento de rotação incremental do eixo do motor. Sua

aplicação é necessária em movimentos rotativos com alta precisão que necessitam de controle

de posição e velocidade. A sua escolha foi definida pela precisão, baixo custo de aquisição e

manutenção.

A composição de um motor de passo contém um rotor e um estator que é a parte fixa do

gerador elétrico, nessa está situado um conjunto de bobinas responsáveis pelo giro do rotor. Para

que haja o movimento, as bobinas estão ligadas aos terminais do motor, organizadas em pares,

interligadas entre si e posicionadas em sentidos opostos para que quando forem energizadas, der

o movimento de rotação do motor devido às interações magnéticas.

O atributo que distingue o motor de passo dos demais motores elétricos é a capacidade

de realizar passos, que são rotações discretas incrementais e precisas. Os passos são definidos

por um número fixo de pólos magnéticos de dente de engrenagens do motor determinando assim,

a precisão de ângulo de rotação do motor de passo. Para que haja um controle de quantos passos

serão dados, o motor necessita de largura de pulso a fim de enviar a corrente adequada para cada

passo. A Figura 18 é um exemplo para melhor entendimento do conceito de passo.

A Figura 18 mostra um motor de passo com 50 dentes de precisão, portanto combinando

o número de dentes com as 4 fases de um motor bipolar temos 200 passos.

A equação 3.1 calcula o número de passos de uma volta executada pelo motor onde, o

número de passos (np) é igual ao número de dentes (nd) mutiplicado pelo número de fases (nf)

np = nd · nf | (3.1)

A precisão do motor é definida por 360° divididos pelo número de passos. Portanto, 360

divididos por 200 é igual a 1,8° de precisão. Já o segundo motor de passo possui 100 dentes de

precisão, portanto a precisão é de 0,9°, o que indica que é um motor com maior precisão que o

de 50 dentes.

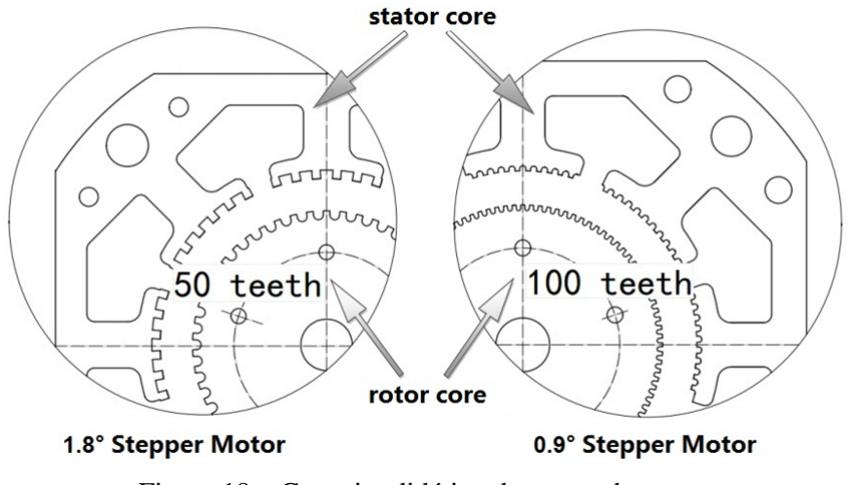
[picture p16: figure]

Figura 18 – Conceito didático do motor de passo. Fonte: https://www.fernandok.com.

Tabela 2 – Sequência de passos com uma fase (wavestep) para movimentação no sentido horário. Passo A+ B+ A- B- Decimal
1 | 0 | 0 | 0 | 1 | 1
2 | 0 | 0 | 1 | 0 | 2
3 | 0 | 1 | 0 | 0 | 4
4 | 1 | 0 | 0 | 0 | 8
Fonte: Próprio Autor, 2021.

Para aumentar a precisão dos motores é possível subdividir o passo de um motor em

menores passos fornecendo ao mesmo tempo corrente elétrica em duas fases. Essa forma de

trabalho é chamada de micropassos.

Logo, quando é fornecido a mesma magnitude de corrente a duas fases, um campo

magnético de mesma magnitude é gerado, resultando em um movimento angular com a metade

do passo original, essa configuração é chamada de meio passo. Assim, ao aplicar magnitudes de

corrente diferentes a duas fases, o rotor se desloca proporcionalmente ao campo eletromagnético

mais forte.

Os motores de passo utilizados no projeto da mesa cartesiana possuem 5 kgf.cm de

torque, passo de 1.8° e corrente máxima de 2 Ampères por fase. O incremento de rotação e

o torque são definidos conforme o modo de excitação que pode ser por passo completo, meio

passo e micropasso explicadas anteriormente. O passo é dividido em quatro, oito ou dezesseis na

maioria das vezes, mas também, atualmente se encontra sistemas capazes de dividir um passo

em milhares de vezes.

As Tabelas 2, 3 e 4 mostram a sequência de polaridades aplicadas no motor no movimento

de sentido horário.

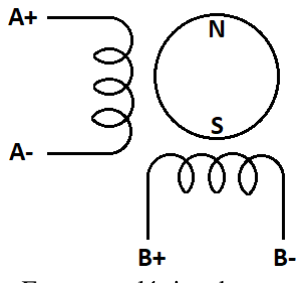
[picture p17: figure]

Figura 19 – Esquema elétrico do motor de passo. Fonte: Próprio autor.

Tabela 3 – Sequência de passos com duas fases (fullstep) para movimentação no sentido horário. Passo A+ B+ A- B- Decimal
1 | 1 | 0 | 0 | 1 | 9
2 | 0 | 0 | 1 | 1 | 3
3 | 0 | 1 | 1 | 0 | 6
4 | 1 | 1 | 0 | 0 | 12
Fonte: Próprio Autor, 2021.

Tabela 4 – Sequência de passos com meio passo (halfstep) para movimentação no sentido horário.
Passo A+ B+ A- B- Decimal
1 | 1 | 0 | 0 | 1 | 9
2 | 0 | 0 | 0 | 1 | 1
3 | 0 | 0 | 1 | 1 | 3
4 | 0 | 0 | 1 | 0 | 2
5 | 0 | 1 | 1 | 0 | 6
6 | 0 | 1 | 0 | 0 | 4
7 | 1 | 1 | 0 | 0 | 12
8 | 1 | 0 | 0 | 0 | 8
Fonte: Próprio Autor, 2021.

As Tabelas 5, 6 e 7 mostram a sequência de polaridades aplicadas no motor no movimento

de sentido anti-horário.

A Tabela 8 apresenta alguns parâmetros dos motores de passo.

Tabela 5 – Sequência de passos com uma fase (wavestep) para movimentação no sentido anti-horário.
Passo A+ B+ A- B- Decimal
1 | 1 | 0 | 0 | 0 | 8
2 | 0 | 1 | 0 | 0 | 4
3 | 0 | 0 | 1 | 0 | 2
4 | 0 | 0 | 0 | 1 | 1
Fonte: Próprio Autor, 2021.

Tabela 6 – Sequência de passos com duas fases (fullstep) para movimentação no sentido anti-horário.
Passo A+ B+ A- B- Decimal
1 | 1 | 1 | 0 | 0 | 12
2 | 0 | 1 | 1 | 0 | 6
3 | 0 | 0 | 1 | 1 | 3
4 | 1 | 0 | 0 | 1 | 9
Fonte: Próprio Autor, 2021.

Tabela 7 – Sequência de passos com meio passo (halfstep) para movimentação no sentido anti-horário.
Passo A+ B+ A- B- Decimal
1 | 1 | 0 | 0 | 0 | 8
2 | 1 | 1 | 0 | 0 | 12
3 | 0 | 1 | 0 | 0 | 4
4 | 0 | 1 | 1 | 0 | 6
5 | 0 | 0 | 1 | 0 | 2
6 | 0 | 0 | 1 | 1 | 3
7 | 0 | 0 | 0 | 1 | 1
8 | 1 | 0 | 0 | 1 | 9
Fonte: Próprio Autor, 2021.

Tabela 8 – Parâmetros dos motores de passo.
Parâmetros | Magnitude
Número de passos por revolução 200 (1,8 graus por passo)
Corrente de operação | 800 mA
Tensão de alimentação | 12 V
Configuração das bobinas | Bipolar (4 fios)
Fonte: Próprio Autor, 2021.

### 3.2.4 Fonte de alimentação

A fonte de alimentação projetada para transformar a tensão elétrica alternada em corrente

contínua.

Para a escolha correta da fonte de alimentação é necessário definir a demanda de energia

elétrica que os dispositivos que são alimentados pela fonte necessitam.

A Tabela 9 apresenta a demanda de energia elétrica de cada dispositivo.

A Tabela 9 indica que a placa controladora Arduino opera no intervalo de tensão de 7 V a

12 V, os drivers de potência no intervalo de 8 V a 35 V, os motores de passo no intervalo de 5 V

a 36 V e o optoacoplador no intervalo de 5 V a 35 V. A tensão de saída de 12 V foi determinada

como melhor opção para o projeto.

Outro parâmetro que a Tabela 9 apresenta é a corrente elétrica mínima para a operação

Tabela 9 – Demanda de energia elétrica de cada componente do sistema.
Componente | Quantidade | Tensão | Consumo Consumo Total
Arduino | 1 | 7 a 12 V | 800 mA | 800 mA
Driver | 2 | 8 a 35 V | 2 A | 4 A
Motor de passo | 2 | 5 a 36 V | 2 A | 4 A
Optoacoplador | 2 | 5 a 35 V | 5 mA | 10 mA
Resultado | - | 12 V | - | 8,18 A
Fonte: Próprio Autor, 2021.

do circuito. A placa controladora necessita de 800 mA, os drivers de potência necessitam de 2 A

cada, como são 2 drivers, 4 A são necessários, os motores de passo consomem 2 amperes cada,

como o projeto contém 2 motores, 4 Amperes são necessários e os optoacopladores necessitam

de 10 mA cada, como o projeto contém 2 optoacopladores, 20 mA são necessários. Decidiu-se

acrescentar uma margem de segurança adicional de 30% na corrente, então, considerou-se uma

corrente mínima necessária de 10,64 A.

A equação 3.2 calcula a demanda total de corrente elétrica mínima para a operação

do circuito onde: demanda total (dtotal), demanda do arduino (darduino), demanda do driver de

potência (ddriver), demanda do motor de passo (dmotor) e demanda do optoacoplador (dopto).

dtotal = 1,3 ·(darduino +2 · ddriver +2 · dmotor +2 · dopto) | (3.2)

Conforme a determinação da tensão de saída e o cálculo de corrente necessária, é possível

determinar que a fonte deve ter 12 V e 10,64 A.

Figura 20 – Fonte do sistema. Fonte: Próprio autor.

### 3.2.5 Acopladores ópticos

Os acopladores ópticos ou optoacopladores são dispositivos que realizam a transferência

de sinais de um circuito para outro por meio de um feixe de luz sem a ligação elétrica.

A aplicação dentro do projeto é o isolamento elétrico que pode ser estabelecido entre os

circuitos de controle de potência, protegendo os circuitos sensíveis a uma alta tensão como a

placa controladora Arduino.

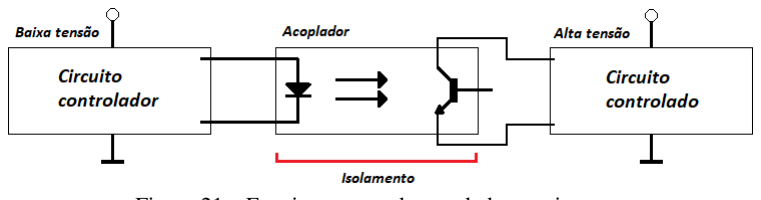
[picture p18: figure]

Figura 21 – Funcionamento do acoplador no sistema. Fonte: Próprio autor.

A sua composição contém uma fonte emissora de luz (LED) e um sensor fototransistor

sensível às variações espectrais da fonte emissora. Seu funcionamento é baseado no efeito

fotoelétrico, onde o diodo LED produz um feixe de luz infravermelha polarizando a base do

fototransistor impondo uma condução entre base e emissor.

O optoacoplador escolhido para o projeto foi o PC 817 por já estar disponível no Labora-

tório de Sistemas Térmicos.

### 3.2.6 Encoders

Geradores de pulsos ou encoders são sensores/transdutores eletromecânicos responsáveis

pelo sistema de controle de posição transformando a medida de posição de algum objeto, seja

linear ou angular, em sinal elétrico digital que é transmitida à placa controladora, também

conseguem converter movimentos circulares ou lineares em pulso elétricos.

Um encoder tem a capacidade de quantização de distâncias, controle de velocidades, me-

dição de ângulos, medição de posição, medição de deslocamento relativo e etc. Sua composição

contém um disco com marcações, um emissor e um receptor. Conforme o disco gira, vão sendo

contadas às marcações e o emissor envia um sinal à placa controladora que por sua vez executa

cálculos de distâncias, velocidades, ângulos, número de rotações e etc.

O princípio de funcionamento é dividido em três tipos, sendo eles: tacômetro, incremental

e absoluto.

O encoder do tipo tacômetro possui um sinal de saída digital responsável em emitir um

pulso para cada incremento captado no deslocamento. Este é utilizado na medição de velocidade

e também no deslocamento angular unidirecional. O encoder incremental conta com sistema

eletrônico externo responsável pela interpretação de posição, este dispositivo utiliza dois ou mais

elementos geradores de sinal possuindo a capacidade de rotacionar por quantas revoluções forem

necessárias.

E o encoder absoluto utiliza várias faixas de saídas com leitura em paralelo e são limitados

a uma revolução. Os dados podem ser recuperados, se uma falha no sistema ocorrer, devido a

representação binária da posição angular do eixo.

### 3.2.7 Chaves fim de curso

As chaves fim de curso são dispositivos eletromecânicos usados para limitação de campo

de movimento de eixos, como os presentes na mesa cartesiana. Esses componentes têm a

capacidade de mudança de estado de conexão em circuitos, alternando o estado de aberto para

fechado e vice-versa (ALCIATORE; HISTAND, 2014). Seu estado inicialmente pode ser tanto

normalmente aberto como normalmente fechado alterando seu estado por pino, gatilho, roldana,

haste alavanca, etc.

Uma chave fim de curso é composta basicamente por três elementos, sendo eles:

a) Caixa: Pode ser metálica ou plástica, dependendo do tipo e abriga os contatos e o

atuador.

b) Contato: É usado dentro do circuito a fim de fazer com que a atuação da chave fim

de curso interrompa ou acione algum outro dispositivo.

c) Atuador: Recebe a força externa exercida para o acionamento da troca de estado.

3.3 SISTEMA DE SOFTWARE

A seguir será descrito o desenvolvimento do sistema de software.

### 3.3.1 Plataforma de prototipação Arduino IDE

A plataforma de prototipação Arduino IDE é um software que permite o desenvolvimento

e envio de códigos compilados direto para o microcontrolador. Essa plataforma tem a flexibilidade

de ser utilizada em vários sistemas operacionais e foi desenvolvida na linguagem Java oferecendo

suporte de desenvolvimento na linguagem C e C++. O download da plataforma foi realizado

através do link: https://www.arduino.cc/en/software

### 3.3.2 Logica de programação

O desenvolvimento da lógica de programação da placa controladora foi organizado de

maneira modular usando orientação a objetos para uma manutenção facilitada e um entendimento

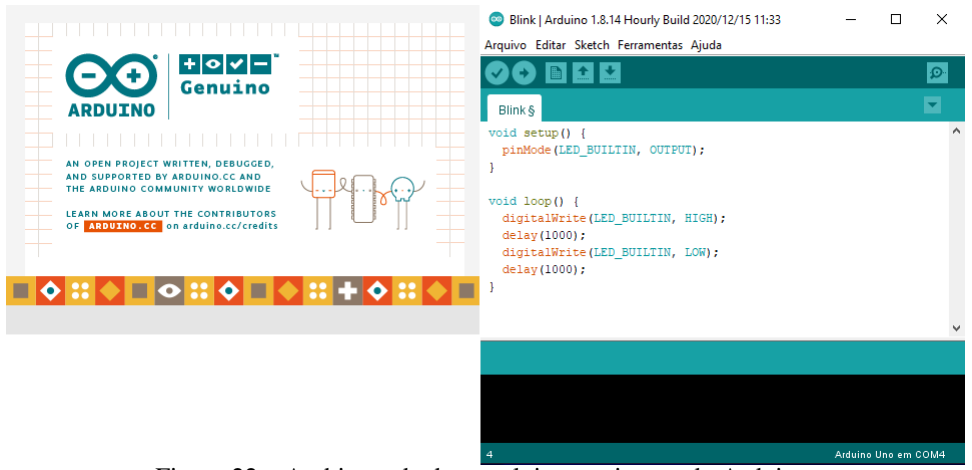
[picture p19: figure]

Figura 22 – Ambiente de desenvolvimento integrado Arduino. Fonte: Próprio autor.

mais claro do código.

As operações que o software deve executar foram apresentadas no fluxograma abaixo.

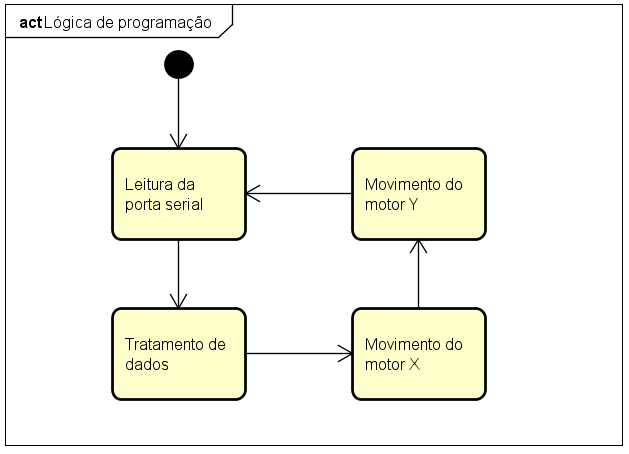
[picture p20: figure]

Figura 23 – Fluxo de execução do software. Fonte: Próprio autor.

A Figura 23 apresenta um fluxograma simplificado da lógica de programação presente

na placa controladora Arduino que inicialmente tem como primeiro comando ficar esperando o

envio de dados pela porta Serial, se caso há esse envio, então o programa faz a leitura da porta

serial, armazenando os dados em variáveis para em seguida realizar o tratamento de dados. Após

o tratamento de dados o software dará o comando de movimentação do motor que controla o fuso do eixo horizontal (eixo X), em seguida, assim que o motor do eixo X parar sua rotação, o

comando de movimentação do motor do eixo vertical (eixo Y) será acionado. Finalmente, após

o fim da execução do motor que controla o eixo Y, o software volta a analisar se é enviado dados

pela porta serial.

### 3.3.3 Diagrama de classes

Diagrama de classe é uma representação da estrutura e relações entre classes que um

software possui facilitando e servindo de modelo para criação de objetos. Esse diagrama permite

modelar classes com seus atributos e métodos além da relação entre objetos.

Para o desenvolvimento do software da placa controladora cuja linguagem é C++ que

é fundamentada em orientação a objetos, foi definido que seria a melhor opção realizar um

diagrama de classes antes do desenvolvimento do código. Sendo assim a Figura 24 apresentada

abaixo é o resultado do que foi modelado.

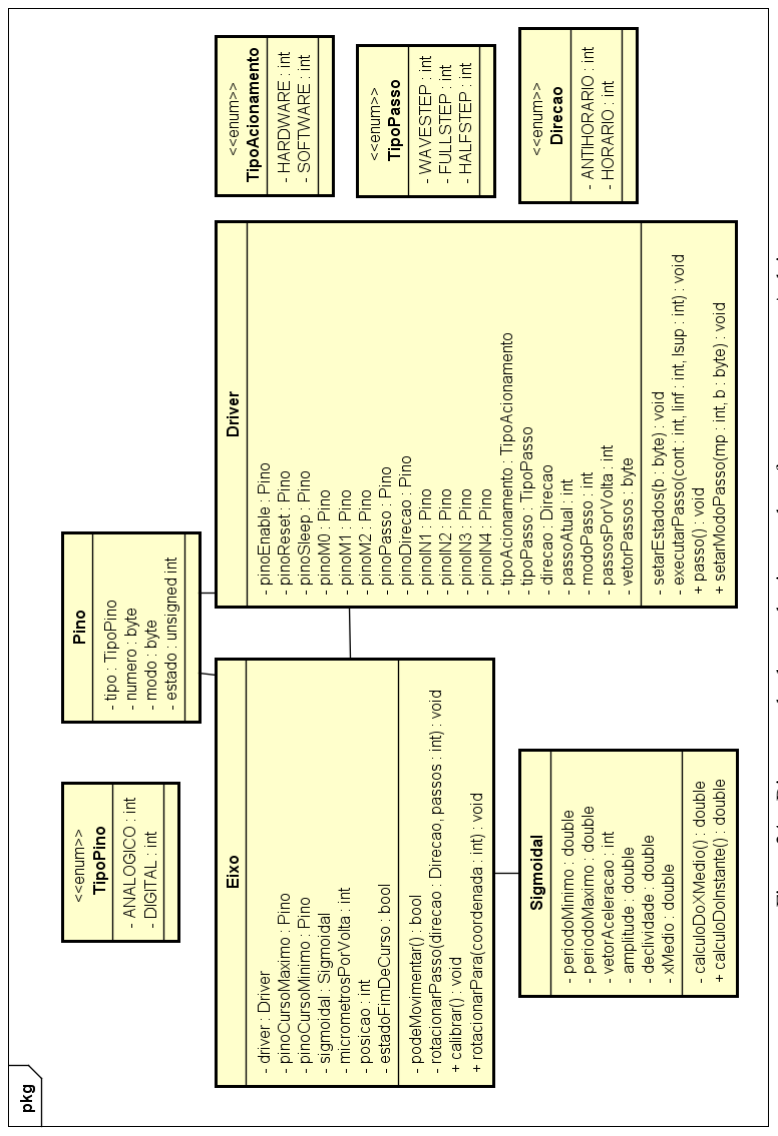
[picture p21: figure]

Figura 24 – Diagrama de classes do sistema de software presente no Arduino.

Fonte: Próprio autor.

A seguir será explicado este diagrama classe a classe.

“Sigmoidal” é a classe responsável pela aceleração sigmóide nos motores de passo, essa

classe utiliza a função sigmóide que é uma função matemática com o gráfico parecido com a letra

S. Para o desenvolvimento da mesa cartesiana houve a preocupação dos projetistas em configurar

os motores de passo com uma aceleração variável para maior vida útil dos equipamentos, já que

com aceleração constante pode causar forças desnecessárias durante o processo de rotação.

A Tabela 10 apresenta a declaração e funcionalidade dos atributos e métodos da classe

“Sigmoidal”.

Tabela 10 – Declaração e funcionalidade dos atributos e métodos da classe Sigmoidal.
Declaração | Funcionalidade
- periodoMinimo: double | Período máximo do passo do motor.
- periodoMaximo: double | Período mínimo do passo do motor.
- vetorAceleracao: int | Determina se a curva será de aceleração (1) ou desace-
| leração (-1)
- amplitude: double | Amplitude da aceleração, diferença do período má-
| ximo menos o período mínimo
- declividade: double | Inclinação da curva de aceleração, o quão rápido o
| motor irá acelerar
- xMedio: double | É a metade do número de iterações necessários para
| percorrer a curva sigmoidal
- calculoDoXMedio(): double Calcula o número de Iterações necessários para percor-
| rer metade da curva sigmoidal.
+ calculoDoInstante(): double Calcula um instante na curva tendo como entrada uma
| iteração
| Fonte: Próprio Autor, 2021.

A classe “Sigmoidal” tem como atributos privados: “periodoMaximo” e o “periodo-

Minimo” que são os períodos que o motor sofrerá os pulsos nas bobinas, “vetorAceleracao”

que determina se a curva sigmoidal terá um comportamento de aceleração ou desaceleração,

“amplitude” que é a diferença entre o “periodoMaximo” e o “periodoMinimo” e é utilizada

na equação do cálculo do X médio e do cálculo do instante, “declividade” que determina a

inclinação da curva de aceleração (o quão rápido o motor irá acelerar), “xMedio” que é a metade

do número de passos (iterações) que o motor precisará para acelerar e é utilizado no cálculo do

instante.

Como operações, a classe “Sigmoidal” tem os métodos de acesso getters e setters que

acessam os atributos privados citados acima, esses métodos são necessários para cumprir o

princípio de encapsulamento da orientação a objetos protegendo a lógica da classe. A classe

“Sigmoidal” dispõe de duas operações, as quais são definidas por: “calculoDoXMedio”, que

calcula o valor do atributo xMedio, “calculoDoInstante”, que calcula o período a ser aplicado

em um determinado instante, esse cálculo é utilizado na lógica do método “rotacionarPasso” da

classe “Eixo”.

“Pino” é a classe que representa os pinos da placa Arduino, pois devido ao número alto

de vezes que foi necessário a utilização dos pinos, foi definido que seria melhor a criação de uma

classe para facilitar as operações com pinos.

A Tabela 11 apresenta a declaração e funcionalidade dos atributos e métodos da classe

“Pino”.

Tabela 11 – Declaração e funcionalidade dos atributos e métodos da classe Pino.
Declaração | Funcionalidade
- tipo: TipoPino | Tipo do pino (ANALOGICO, DIGITAL).
- numero: byte | Número do pino.
- modo: byte | Modo do pino (OUTPUT, INPUT).
- estado: unsigned int Estado do pino (LOW, HIGH) | (0, 255) | (0, 1023).
| Fonte: Próprio Autor, 2021.

A classe “Pino” possui como atributos privados: “tipo”, que é o tipo de entrada do pino

que pode ser analogico ou digital, “numero”, que é o número de uma determinada porta na placa,

“modo” que define se a porta é de entrada ou saída de dados, e “estado”, que pode estar ligado

ou desligado nas portas digitais, ter valores de 0 a 255 nas portas PWM e de 0 a 1023 nas portas

analogicas. Como operações, a classe “Pino” tem os métodos de acesso getters e setters que

acessam os atributos privados citados acima.

“Driver” é a classe responsável pelo controle digital do driver de potência, com ela é

possível definir o modo do passo dos motores, executar o pulso que dará movimento ao motor de

passo, ligar e desligar o driver, deixá-lo no modo “sleep” e também “reseta-lo”.

A Tabela 12 apresenta a declaração e funcionalidade dos atributos e métodos da classe

“Driver”

A classe “Driver” possui os atributos privados: “pinoEnable”, que permite ligar ou

desligar o driver, “pinoReset”, que reinicia o driver, “pinoSleep”, que ativa o modo sleep do driver,

“pinoM0”, “pinoM1” e “pinoM2”, que definem o modo do Passo, “pinoPasso” e “pinoDirecao”

que são os pinos de execução de passo e configuração de direção para tipo de acionamento via

hardware, “pinoIN1”, “pinoIN2”, “pinoIN3” e “pinoIN4” que são os pinos referentes ao controle

das bobinas do motor de passo para tipo de acionamento via software, “tipoAcionamento” para

Tabela 12 – Declaração e funcionalidade dos atributos e métodos da classe Driver.
Declaração | Funcionalidade
- pinoEnable: Pino | Ativar e desativar o driver.
- pinoReset: Pino | Resetar o driver.
- pinoSleep: Pino | Ativar e desativar o modo sleep do
| driver.
- pinoM0: Pino | Pino M0 do modo de passo do dri-
| ver.
- pinoM1: Pino | Pino M1 do modo de passo do dri-
| ver.
- pinoM2: Pino | Pino M2 do modo de passo do dri-
| ver.
- pinoPasso: Pino | Pino de execução do passo do driver.
- pinoDirecao: Pino | Pino de configuração da direção do
| driver.
- pinoIN1: Pino | Pino IN1 do motor de passo.
- pinoIN2: Pino | Pino IN2 do motor de passo.
- pinoIN3: Pino | Pino IN3 do motor de passo.
- pinoIN4: Pino | Pino IN4 do motor de passo.
- tipoAcionamento: TipoAcionamento | Tipo de acionamento do dri-
| ver: (SOFTWARE, HARDWARE).
- tipoPasso: TipoPasso | Tipo do passo do driver: (WAVES-
| TEP, FULLSTEP, HALFSTEP).
- direcao: Direcao | Configuração da direção do driver:
| (ANTIHORARIO, HORARIO).
- passoAtual: int | PassoAtual é o indice de acesso as
| informações do vetor de passos.
- modoPasso: int | Pino do modo de passo do driver.
- passosPorVolta: int | Quantidade de passos a cada volta
| do motor de passo.
- vetorPasso: byte | Vetor de bytes de sequência dos pas-
| sos.
- setarEstadoModo (pM0:bool, pM1:bool,
pM2:bool): void | Definir o modo de passo do driver
| passando como parâmetro os esta-
| dos dos pinos M0, M1, M2.
- setarEstados(b: byte):void | Definir estados dos pinos IN1, IN2,
| IN3, IN4 do motor de passo.
- passo():void | Executar um passo do motor.
+ executarPasso(cont:int, linf:int, lsup:int):void Executar um passo do motor com a
| lógica de sequência dos passos.
+ setarModoPasso(mp:int, b:byte):void | Definir o modo de passo do driver.
Fonte: Próprio Autor, 2021.

configuração do tipo de acionamento do driver que pode ser via software ou hardware conforme

a necessidade de cada tipo de driver utilizado, “tipoPasso” para configuração do tipo de passo do

driver que pode ser (wavestep, fullstep, halfstep), “direcao”, que define o sentido do movimento,

“passoAtual” que é o índice de acesso às informações do vetor de passos, “modoPasso”, que

define o modo do passo do driver, “passosPorVolta”, que define a quantidade de passos a cada

volta do motor como por exemplo, 200 passos de 1,8° resultando em 360°.

Como operações, a classe “Driver” tem os métodos: métodos de acesso getters e setters

que acessam os atributos privados da classe, os métodos: “setarEstados”, que define os estados

dos pinos IN1, IN2, IN3, IN4 do motor de passo, “passo” que executa um passo do motor,

“setarModoPasso”, que define o modo de passo do driver e “executarPasso”, executa um passo

do motor com a lógica de configurações de passos.

“Eixo” é a classe que foi desenvolvida a lógica de movimentação dos eixos da mesa

cartesiana. Com ela é possível rotacionar definindo a coordenada cartesiana de preferência,

verificar se a posição do eixo está ativando a chave de fim de curso.

A Tabela 13 apresenta a declaração e funcionalidade dos atributos e métodos da classe

“Eixo”.

Tabela 13 – Declaração e funcionalidade dos atributos e métodos da classe Eixo.
Declaração | Funcionalidade
- driver: Driver | Define as configurações do driver
| que controla os motores de passo.
- sigmoidal: Sigmoidal | Define a aceleração sigmoidal dos
| motores de passo.
- pinoCursoMinimo: Pino | Pino do curso mínimo da chave fim
| de curso.
- pinoCursoMaximo: Pino | Pino do curso máximo da chave fim
| de curso.
- posicao: int | Pino da posição atual do eixo.
- estadoFimDeCurso: bool | Pino do estado de fim de curso que
| pode inicializar LOW ou HIGH.
- podeMovimentar(direcao:bool):bool | Verificar se o motor está no fim de
| curso.
- rotacionarPassos(direcao:bool,passos:int):void Rotacionar o motor, tendo como pa-
| râmetros de entrada a direção e a
| quantidade de passos.
+ rotacionarPara(coordenada:double):void | Rotacionar o motor tendo como pa-
| râmetro a coordenada cartesiana do
| eixo.
Fonte: Próprio Autor, 2021.

A classe “Eixo” possui os atributos privados: “driver”, que é responsável pelas confi-

gurações e operações do driver de potência que controla o motor de passo acoplado ao eixo,

“sigmoidal” que define a aceleração variável do motor, “pinoCursoMinimo” e “pinoCursoMaximo”, que são os pinos referentes às chaves fim de curso de cada eixo, “estadoFimDeCurso”,

que indica o estado que a chave fim de curso inicializará estando desativada.

Como operações, a classe tem os métodos: métodos de acesso getters e setters que

acessam os atributos privados da classe, os métodos: “podeMovimentar”, que indica se o motor

de passo pode executar o próximo passo ou se já chegou ao fim do curso, “rotacionarPassos”,

que rotaciona o eixo tendo como parâmetros de entrada uma direção e uma quantidade de passos

a serem executadas e “rotacionarPara”, que rotaciona o eixo tendo como parâmetros de entrada

uma coordenada cartesiana.

Além das classes utilizadas, o software possui a sketch principal que é responsável

pela configuração das informações iniciais, criação dos objetos na memória, configuração dos

atributos de cada objeto, execução da leitura pela porta serial, tratamento de dados recebidos

e a movimentação dos motores. A Figura 25 apresenta um diagrama geral da organização do

software.

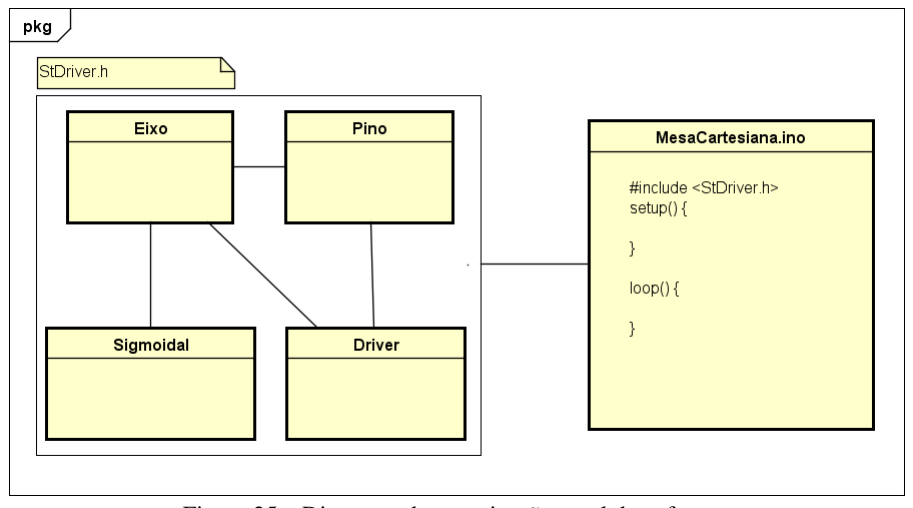
[picture p22: figure]

Figura 25 – Diagrama da organização geral do software. Fonte: Próprio autor.

O arquivo “MesaCartesiana.ino” é o principal, ele instancia os objetos das classes: “Pino”,

“Sigmoidal”, “Driver” e “Eixo” e também tem a responsabilidade de receber às coordenadas

através da comunicação serial e às enviar para o objeto da classe “Eixo” que fará a rotação dos

motores.

3.4 INTEGRAÇÃO DOS SISTEMAS

Nesta seção será descrito como os sistemas são integrados mostrando como os três

sistemas se comunicam. A Figura 26 é um fluxograma que descreve de maneira gráfica a

integração dos sistemas.

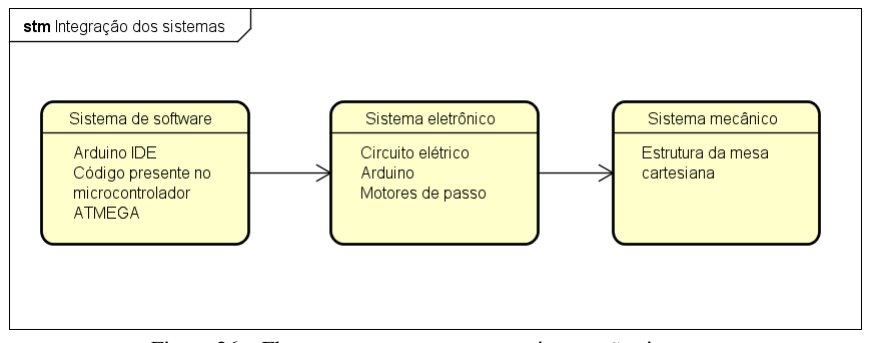
[picture p23: figure]

Figura 26 – Fluxograma para apresentar a integração sistemas. Fonte: Próprio autor.

O sistema de software se comunica com o sistema eletrônico através do envio de dados

pela comunicação Serial presente no Arduino IDE para o software presente no microcontrolador

ATMEGA da placa Arduino. Por sua vez, o microcontrolador envia um comando elétrico

ao sistema eletrônico que acionará os motores de passo que convertem a energia elétrica em

mecânica transmitindo o movimento dos fusos da estrutura do sistema mecânico.

### 4 RESULTADOS E DISCUSSÃO

Para apresentação dos resultados encontrados ao longo da implantação da mesa cartesiana

no laboratório de sistemas térmicos e uma posterior discussão, os temas foram divididos de

acordo com a metodologia (seção 3). Ou seja, primeiramente é apresentado os resultados do

sistema mecânico, posteriormente os resultados do sistema eletrônico, em seguida é mostrado os

resultados da programação do sistema de software. Por fim, é realizada uma análise dos testes

experimentais.

4.1 SISTEMA MECÂNICO

A Figura X mostra uma fotografia da mesa cartesiana possibilitando uma melhor compre-

ensão do funcionamento dos seus componentes.

4.2 SISTEMA ELETRÔNICO

A Figura X mostra um esquema elétrico que comanda os motores de passos presentes

na estrutura da mesa cartesiana possibilitando uma melhor compreensão do funcionamento dos

seus componentes.

4.3 SISTEMA DE SOFTWARE

O sistema de software do projeto foi fundamentado na metodologia, sendo assim para o

desenvolvimento do código foi utilizado a plataforma de prototipação Arduino IDE respeitando

o diagrama de classes mostrado na seção 3.3.3.

A seguir serão mostrados os arquivos header de cada classe presente no sistema a fim

de resumir o código fonte da sua versão completa. Esta versão se encontra nos apêndices do

trabalho.

### 4.3.1 Código header da classe Pino

Segue abaixo o arquivo header (Pino.h) da classe “Pino”.

1 | # i f n d e f PINO_H_INCLUDED
2 | # d e f i n e PINO_H_INCLUDED
3 | c l a s s Pi n o {

p u bli c :

enum Ti p o Pi n o {

ANALOGICO = 0 ,

DIGITAL = 1 ,

} ;

~ Pi n o ( v oi d ) {}

Pi n o ( Ti p o Pi n o t , b yt e n , b yt e m, un si gned i n t e ) ;

v oi d setModo ( b yt e m) ;

v oi d s e t E s t a d o ( un si gned i n t e ) ;

Ti p o Pi n o g et Ti p o ( ) ;

b yt e getNume ro ( ) ;

b yt e getModo ( ) ;

un si gned i n t g e t E s t a d o ( ) ;

p r i v a t e :

Ti p o Pi n o t i p o = Ti p o Pi n o : : DIGITAL ;

b yt e numero = 0 ;

b yt e modo = OUTPUT;

un si gned i n t e s t a d o = LOW;

v oi d s e t T i p o ( Ti p o Pi n o t ) ;

v oi d setN ume r o ( b yt e n ) ;

} ;

# e n d i f

Listing 4.1 – Pino.h

Assim para se utilizar as funções presentes na classe “Pino” é criado um objeto através

do comando abaixo com seus devidos parâmetros de entrada.

Pi n o * pi n oE n a bleX ;

2 | pi n oE n a bleX | = new Pi n o ( Pi n o : : DIGITAL , PINO_ENABLE_X , OUTPUT, LOW) ;

Listing 4.2 – Objeto da classe Pino.

### 4.3.2 Código header da classe Sigmoidal

Segue abaixo o arquivo header (Sigmoidal.h) da classe “Sigmoidal”.

# i f n d e f SIGMOIDAL_H_INCLUDED

# d e f i n e SIGMOIDAL_H_INCLUDED

# d e f i n e E 2. 7 1 8 2 8 1 8 2 8 4 5 9 0 4 5 2 3 5 3 6

c l a s s Si gm oi d al {

p u bli c :

~ Si gm oi d al ( v oi d ) {}

Si gm oi d al ( d ouble pmax , d ouble pmin , d ouble de ) ;

d ouble calculoDoXMedio ( ) ;

v oi d s e t V e t o r A c e l e r a c a o ( ) ;

v oi d s et P e ri o d oM a xim o ( d ouble pmax ) ;

v oi d s et P e ri o d oMi nim o ( d ouble pmin ) ;

v oi d s e t D e c l i v i d a d e ( d ouble de ) ;

d ouble getP e ri o d oMa xim o ( ) ;

d ouble g et P e ri o d oMi nim o ( ) ;

i n t g e t V e t o r A c e l e r a c a o ( ) ;

d ouble g et A m plit u d e ( ) ;

d ouble g e t D e c l i v i d a d e ( ) ;

d ouble getXMedio ( ) ;

d ouble c a l c u l o D o I n s t a n t e ( ) ;

p r i v a t e :

d ouble pe riodoMaximo = 6 0 0 , pe ri o d oMi nim o = 1 0 0 ,

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

d e c l i v i d a d e = 0 , xMedio = 0 ;

i n t v e t o r A c e l e r a c a o = 1 ;

} ;

# e n d i f

Listing 4.3 – Sigmoidal.h

Assim para se utilizar as funções presentes na classe “Sigmoidal” é criado um objeto

através do comando abaixo com seus devidos parâmetros de entrada.

Si gm oi d al si gm oi d al X ;

si gm oi d al X = new Si gm oi d al ( SIG_PERIODO_MAXIMO_X , SIG_PERIODO_MINIMO_X ,

SIG_DECLIVIDADE_X ) ;

Listing 4.4 – Objeto da classe Sigmoidal.

### 4.3.3 Código header da classe Driver

Segue abaixo o arquivo header (Driver.h) da classe “Driver”.

# i f n d e f DRIVER_H_INCLUDED

# d e f i n e DRIVER_H_INCLUDED

c l a s s D r i v e r {

4 | p u bli c :
5 | enum Ti p oAci o name nt o {
6 | SOFTWARE = 0 ,
7 | HARDWARE = 1
8 | } ;
9 | enum Ti p o P a s s o {
10 | WAVESTEP = 0 ,
11 | FULLSTEP = 1 ,
12 | HALFSTEP = 2
13 | } ;
14 | enum Di r e c a o {
15 | ANTIHORARIO = −1 ,
16 | HORARIO | = | 1
17 | } ;
18 | ~ D r i v e r ( v oi d ) {}
19 | D r i v e r ( Pi n o * pino IN1 , Pi n o * pino IN2 , Pi n o * pino IN3 , Pi n o * pino IN4 , b yt e *

v e t o r P a s s o s ) ;

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

pi n o Sl e e p , Pi n o * pinoM0 , Pi n o * pinoM1 , Pi n o * pinoM2 , Pi n o * pino IN1 , Pi n o

* pino IN2 , Pi n o * pino IN3 , Pi n o * pino IN4 , b yt e * v e t o r P a s s o s ) ;

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

pi n o P a s s o , * pi n o Di r e c a o , * pino IN1 , * pino IN2 , * pino IN3 , * pi n o IN 4 ;

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

Listing 4.5 – Driver.h

Para flexibilização na utilização de diferentes tipos de drivers, foi desenvolvido duas

construções diferentes para utilizar as funções da classe “Driver”.

A primeira é passando como parâmetros o pino do passo e da direção como no código

abaixo. Essa construção é para drivers que se responsabilizam pelo controle do estado das

bobinas através do seu hardware.

1 Pi n o * pi n oE na bleX , * pi n oRe setX , * pi n oSlee pX , *pinoM0X , *pinoM1X , *pinoM2X ,

* pi n oPa s s oX , * pi n o Di r e c a o ;

2 | pi n oE n a bleX | = new Pi n o ( Pi n o : : DIGITAL , PINO_ENABLE_X , OUTPUT, LOW) ;
3 | pi n oR e s etX | = new Pi n o ( Pi n o : : DIGITAL , PINO_RESET_X , OUTPUT, LOW) ;
4 | pi n o Sl e e pX | = new Pi n o ( Pi n o : : DIGITAL , PINO_SLEEP_X , OUTPUT, LOW) ;
5 | pinoM0X | = new Pi n o ( Pi n o : : DIGITAL , PINO_M0_X , OUTPUT, LOW) ;
6 | pinoM1X | = new Pi n o ( Pi n o : : DIGITAL , PINO_M1_X , OUTPUT, LOW) ;
7 | pinoM2X | = new Pi n o ( Pi n o : : DIGITAL , PINO_M2_X , OUTPUT, LOW) ;
8 | pi n oP a s s oX | = new Pi n o ( Pi n o : : DIGITAL , PINO_PASSO_X , OUTPUT, LOW) ;
9 | pi n oDi r e c a oX = new Pi n o ( Pi n o : : DIGITAL , PINO_DIRECAO_X , OUTPUT, LOW) ;
10 | D r i v e r * d ri v e r X ;
11 | d ri v e r X = new D r i v e r ( pi n oE na bleX , pi n oRe setX , pi n oSlee pX , pinoM0X , pinoM1X ,

pinoM2X , pi n oPa s s oX , pi n oDi r e c a oX ) ;

Listing 4.6 – Objeto da classe Driver.

Já a segunda é passando como parâmetros os pinos das bobinas como no código abaixo.

Essa construção é para drivers que terceirizam para o software o controle do estado das bobinas.

1 | b yt e v e t o r P a s s o s [ 8 ] = { 9 , 1 , 3 , 2 , 6 , 4 , 1 2 , 8 };
2 | Pi n o * pi n oE na bleX , * pi n oRe setX , * pi n oSlee pX , *pinoM0X , *pinoM1X , *pinoM2X ,

pinoIN1X , pinoIN2X , pinoIN3X , pinoIN4X ;

3 | D r i v e r * d ri v e r X ;
4 | pi n oE n a bleX = new Pi n o ( Pi n o : : DIGITAL , PINO_ENABLE_X , OUTPUT, LOW) ;
5 | pi n oR e s etX | = new Pi n o ( Pi n o : : DIGITAL , PINO_RESET_X , OUTPUT, LOW) ;
6 | pi n o Sl e e pX | = new Pi n o ( Pi n o : : DIGITAL , PINO_SLEEP_X , OUTPUT, LOW) ;

7 | pinoM0X | = new Pi n o ( Pi n o : : DIGITAL , PINO_M0_X , OUTPUT, LOW) ;
8 | pinoM1X | = new Pi n o ( Pi n o : : DIGITAL , PINO_M1_X , OUTPUT, LOW) ;
9 | pinoM2X | = new Pi n o ( Pi n o : : DIGITAL , PINO_M2_X , OUTPUT, LOW) ;
10 | pinoIN1X | = new Pi n o ( Pi n o : : DIGITAL , PINO_IN1_X , OUTPUT, LOW) ;
11 | pinoIN2X | = new Pi n o ( Pi n o : : DIGITAL , PINO_IN2_X , OUTPUT, LOW) ;
12 | pinoIN3X | = new Pi n o ( Pi n o : : DIGITAL , PINO_IN3_X , OUTPUT, LOW) ;
13 | pinoIN4X | = new Pi n o ( Pi n o : : DIGITAL , PINO_IN4_X , OUTPUT, LOW) ;
14 | D r i v e r * d ri v e r X ;
15 | d ri v e r X | = new D r i v e r ( D r i v e r : : WAVESTEP, pi n oE na bleX , pi n oRe setX ,

pi n oSlee pX , pinoM0X , pinoM1X , pinoM2X , pinoIN1X , pinoIN2X , pinoIN3X ,

pinoIN4X , v e t o r P a s s o s ) ;

Listing 4.7 – Objeto da classe Driver.

### 4.3.4 Código header da classe Eixo

Segue abaixo o arquivo header (Eixo.h) da classe “Eixo”.

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

Listing 4.8 – Eixo.h

Assim para se utilizar as funções presentes na classe “Eixo” é criado um objeto através

do comando abaixo com seus devidos parâmetros de entrada.

1 Pi n o * pi n oE na bleX , * pi n oRe setX , * pi n oSlee pX , *pinoM0X , *pinoM1X , *pinoM2X ,

* pi n oPa s s oX , * pi n o Di r e c a o ;

2 | pi n oE n a bleX | = new Pi n o ( Pi n o : : DIGITAL , PINO_ENABLE_X , OUTPUT, LOW) ;
3 | pi n oR e s etX | = new Pi n o ( Pi n o : : DIGITAL , PINO_RESET_X , OUTPUT, LOW) ;
4 | pi n o Sl e e pX | = new Pi n o ( Pi n o : : DIGITAL , PINO_SLEEP_X , OUTPUT, LOW) ;
5 | pinoM0X | = new Pi n o ( Pi n o : : DIGITAL , PINO_M0_X , OUTPUT, LOW) ;
6 | pinoM1X | = new Pi n o ( Pi n o : : DIGITAL , PINO_M1_X , OUTPUT, LOW) ;
7 | pinoM2X | = new Pi n o ( Pi n o : : DIGITAL , PINO_M2_X , OUTPUT, LOW) ;
8 | pi n oP a s s oX | = new Pi n o ( Pi n o : : DIGITAL , PINO_PASSO_X , OUTPUT, LOW) ;
9 | pi n oDi r e c a oX = new Pi n o ( Pi n o : : DIGITAL , PINO_DIRECAO_X , OUTPUT, LOW) ;
10 | D r i v e r * d ri v e r X ;
11 | d ri v e r X = new D r i v e r ( pi n oE na bleX , pi n oRe setX , pi n oSlee pX , pinoM0X , pinoM1X ,

pinoM2X , pi n oPa s s oX , pi n oDi r e c a oX ) ;

12 | Pi n o *cursoMaximoX , * cu rsoMinimoX ;
13 | Si gm oi d al * si gm oi d al X ;
14 | cursoMaximoX = new Pi n o ( Pi n o : : DIGITAL , PINO_CURSOMAXIMO_X, INPUT , HIGH ) ;
15 | cu rsoMinimoX = new Pi n o ( Pi n o : : DIGITAL , PINO_CURSOMINIMO_X , INPUT , HIGH ) ;
16 | si gm oi d al X | = new Si gm oi d al ( SIG_PERIODO_MAXIMO_X , SIG_PERIODO_MINIMO_X ,

SIG_DECLIVIDADE_X ) ;

17 | Ei x o * eixoX ;
18 | eixoX = new Ei x o ( d ri v e r X , MILIMETROS_POR_VOLTA_X , ESTADO_FIM_DE_CURSO_X ,

cursoMaximoX , cursoMinimoX , si gm oi d al X ) ;

Listing 4.9 – Objeto da classe Eixo.

### 4.3.5 Detalhamento do arquivo principal (MesaCartesiana.ino)

O arquivo principal tem a responsabilidade de gerenciar toda aplicação, neste arquivo

serão construídos todos objetos necessários. Segue abaixo um resumo com todas funcionalidades

que este possui.

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

Listing 4.10 – MesaCartesiana.ino

O método “incializarEixos” é responsável por construir os objetos necessários para

controle dos eixos da aplicação, neste é possível escolher se o tipo de acionamento do driver é

via software ou hardware.

O método “interpretarComandos” é responsável pela interpretação de qual comando foi

enviado pelo usuário, como por exemplo o comando “MOVER 2,4” que movimenta o eixo X

para a ordenada 2 e o eixo Y para a ordenada 4. Outros comandos necessários para uma aplicação

como a mudança de estados de algumas configurações devem ser interpretadas por este método.

O método “movimentarMesa” é responsável pela chamada da funcionalidade de rotação

presente na classe “Eixo” para isso recebe como parâmetro a coordenada enviada pelo usuário.

O método “escolherModoPasso” é responsável por setar qual o modo do passo que o

eixo irá operar.

O método “setup” é responsável pela inicialização de toda aplicação estando nele uma

chamada para o método de inicialização dos eixos.

O método “serialEvent” é responsável pela recepção dos dados enviados pelo usuário

estando nele uma chamada para o método de interpretação de comandos.

O método “loop” é responsável pela execução da aplicação de forma que ela nunca acabe,

já que é necessário que o método “serialEvent” esteja sempre em operação para quando o usuário

solicitar alguma ação no sistema esta seja executada.

### 5 CONSIDERAÇÕES FINAIS

O objetivo geral do projeto que consiste na movimentação de instrumentos de medição

em um sistema de coordenadas cartesianas foi atendido. Nesse sentido, os objetivos específicos

de projetar a mesa cartesiana, criar o sistema de comunicação “mesa-software” e desenvolver o

software de comando foram contemplados.

A mesa cartesiana foi projetada com recursos disponíveis do mercado indicando que é

possível construir sistemas com propósitos parecidos que atendem solicitações de laboratórios.

A documentação deste trabalho foi realizada a fim de facilitar o entendimento para o

desenvolvimento de outros projetos parecidos e assim estender o impacto deste trabalho em

outras instituições de ensino. Isso permitirá que um maior número de pesquisadores possam

realizar a captura de dados para experimentos de forma automatizada em túneis de vento.

Assim, o código fonte presente na placa de prototipação Arduino está disponível em um

repositório online no endereço <https://github.com/abaldezjr/MesaCartesiana>. Também está

disponível no endereço <https://github.com/abaldezjr/tcc>, uma versão em Latex com todo o

material necessário para a montagem do trabalho, este tem o objetivo de auxiliar a montagem de

trabalhos de conclusão de curso futuros.

Com este trabalho, foi possível utilizar diversos dos conhecimentos adquiridos ao longo

do curso de Engenharia Mecânica utilizando-os de forma integrada, visto que envolveu a

concepção de um sistema mecânico movimentado por motores elétricos, além de aproveitar-se

do desenvolvimento de software na integração do projeto como um todo.

5.1 CRÍTICAS E SUGESTÕES DE TRABALHOS FUTUROS

Algumas críticas podem ser levantadas sobre o protótipo do projeto como:

- A versão do projeto ainda não possui um sistema completamente automatizado, sendo

possível realizar somente a captura dos dados de uma coordenada por vez.

- Os dados ainda não foram capturados através de algum sensor digital.
- Os dados não são apresentados de forma gráfica.
- O sistema eletrônico não tem um case para seu abrigo estando desprotegido, além de ter

sido desenvolvido em uma versão de protótipo com a placa Arduino.

Algumas melhorias podem ser sugeridas para uma próxima versão do projeto como:

- Capturar os dados de forma digital através de um sensor.

- Automatizar a captura de dados para que seja possível o usuário planejar uma rotina e

saber o seu tempo estimado.

- Integrar o sistema de software da mesa cartesiana a um aplicativo que faça geração de

relatórios, para uma visualização dos dados de forma gráfica.

- Desenvolver o circuito eletrônico em uma placa de circuito impresso com os devidos

componentes.

- Projetar um case (caixa) para abrigar os componentes do circuito eletrônico.

REFERÊNCIAS

ALCIATORE, D. G.; HISTAND, M. B. Introdução à Mecatrônica e aos Sistemas de Medições. [S.l.]: AMGH Editora, 2014.

BUDYNAS, R. G.; NISBETH, J. K. Elementos de Máquinas de Shigley-10ª Edição. [S.l.]: McGraw Hill Brasil, 2016.

BUTIGNOL, M. R. Adequação de uma mesa xyz para fins didáticos. 2017. Monografia (Bacharel em Engenharia Mecatrônica), IFSC (Instituto Federal de Educação, Ciência e Tecnologia de Santa Catarina), Florianópolis, Brazil. Disponível em: <https://repositorio.ifsc.edu.br/bitstream/handle/123456789/571/ADEQUACAO_DE_UMA_MESA_XYZ_PARA_FINS_DIDATICOS.pdf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>. (https://repositorio.ifsc.edu.br/bitstream/handle/123456789/571/ADEQUACAO_DE_UMA_MESA_XYZ_PARA_FINS_DIDATICOS.pdf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)

CAMARGO, L. F. S. et al. Mesa de coordenadas xy para aplicação em microengenharia com cnc: projeto e analise. 1988. Disponível em: <https://repositorio.ufsc.br/xmlui/bitstream/handle/123456789/75448/80422.pdf?sequence=1&isAllowed=y>. (https://repositorio.ufsc.br/xmlui/bitstream/handle/123456789/75448/80422.pdf?sequence=1&isAllowed=y)

CARMINATTI, L. J.; KONRATH, R. Desenvolvimento de um túnel de vento subsônico com foco no ensino didático. Anais da Engenharia Mecânica/ISSN 2594-4649, v. 4, n. 1, p. 17–33, 2019. Disponível em: <https://uceff.edu.br/anais/index.php/engmec/article/view/229/221>.

HOSS, D. L. Implantação de controle de velocidade em túnel de vento movido à motor de combustão para testes de turbinas eólicas. p. 121, 2018. Disponível em: <https://repositorio.ifsc.edu.br/bitstream/handle/123456789/532/Implementaç~ao%20de%20controle%20de%20velocidade%20em%20túnel%20de%20vento.pdf?sequence=1>. (https://repositorio.ifsc.edu.br/bitstream/handle/123456789/532/Implementa~ao%20de%20controle%20de%20velocidade%20em%20tnel%20de%20vento.pdf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)

JOGLEKAR, B.; MOURYA, R. M. Design, construction and testing open circuit low speed wind tunnel. International Journal of Engineering Research and Reviews, v. 2, n. 4, p. 1–9, 2014.

JÚNIOR, L. C. d. F.; SILVA, R. S. da. Máquinas Elétricas. [S.l.]: Editora e Distribuidora Educacional S.A., 2018.

PRITCHARD, P. J.; MITCHELL, J. W. Fox and McDonald’s introduction to fluid mechanics. John Wiley & Sons, 2005. Disponível em: <http://ftp.demec.ufpr.br/disciplinas/TM240/Marchi/Bibliografia/Pritchard-Fox-McDonalds_2011_8ed_Fluid-Mechanics.pdf>. (http://ftp.demec.ufpr.br/disciplinas/TM240/Marchi/Bibliografia/Pritchard-Fox-McDonalds_2011_8ed_Fluid-Mechanics.pdf)

RAMOS, L. G. d. R. Desenvolvimento de um sistema de deslocamento bi-axial para aplicação em túnel aerodinâmico. 2018.

ROCHA, F.; SERRANTOLA, W.; LOPEZ, G. N.; TORGA, D.; CARVALHO, M.; SOUZA, G. et al. Retrofitting de uma mesa xy. v. 501778, 2015. Disponível em: <http://swge.inf.br/SBAI2015/anais/554.pdf>. (http://swge.inf.br/SBAI2015/anais/554.pdf)

SANTOS, A. R. dos; SILVA, B. W. X. da; NETO, F. S.; LOPES, L. D.; DIONÍSIO,
T. H. Elaboração de túnel de vento para aplicações de ensaios aerodinâmicos. p. 39, 2014. Disponível em: <https://www.google.com/url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 AOvVaw2RnEW_mEs0Z9K7xVBjPVyZ>. (https://www.google.com/url?rct=j&q=&esrc=s&cd=)

APÊNDICES

APÊNDICE A – CÓDIGO PRINCIPAL PARA O CONTROLE DA MESA CARTESIANA

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

38 | # d e f i n e PINO_CURSOMINIMO_Y 9
39 | # d e f i n e ESTADO_FIM_DE_CURSO_Y LOW
40 | # d e f i n e MILIMETROS_POR_VOLTA_Y 8
41 | # d e f i n e LIMITE_MAXIMO_Y 10
42 | # d e f i n e SIG_PERIODO_MAXIMO_Y 600
43 | # d e f i n e SIG_PERIODO_MINIMO_Y 100
44 | # d e f i n e SIG_DECLIVIDADE_Y 0 . 1
45 | S t r i n g l e i t u r a ;
46 | i n t x = 0 , y = 0 ;
47 | b yt e v e t o r P a s s o s [ 8 ] = { 9 , 1 , 3 , 2 , 6 , 4 , 1 2 , 8 };
48 | Pi n o * pi n o 1 3 , * pi n oE na bleX , * pi n oRe setX , * pi n oSlee pX ,
49 | *pinoM0X , *pinoM1X , *pinoM2X , * pi n oPa s s oX , * pi n oDi reca oX ,
50 | *pinoIN1X , *pinoIN2X , *pinoIN3X , *pinoIN4X , * cursoMaximoX , * cu rsoMinimoX ;
51 | Si gm oi d al * si gm oi d al X ;
52 | D r i v e r * d ri v e r X ;
53 | Ei x o * eixoX ;
54 | Pi n o * pi n oE na bleY , * pi n oRe setY , * pi n oSlee pY ,
55 | *pinoM0Y , *pinoM1Y , *pinoM2Y , * pi n oPa s s oY , * pi n oDi reca oY ,
56 | *pinoIN1Y , *pinoIN2Y , *pinoIN3Y , *pinoIN4Y ,
57 | *cursoMaximoY , * cu rsoMinimoY ;
58 | Si gm oi d al * si gm oi d al Y ;
59 | D r i v e r * d ri v e r Y ;
60 | Ei x o * eixoY ;
61 | v oi d i n i c i a l i z a r E i x o s ( D r i v e r : : Ti p oAci o name nt o t p ) ;
62 | v oi d i n t e r p r e t a r C o m a n d o s ( S t r i n g comando ) ;
63 | v oi d movimenta rMesa ( S t r i n g c o o r d e n a d a ) ;
64 | v oi d e s c ol h e rM o d o P a s s o ( Ei x o *e , S t r i n g modoPasso ) ;
65 | v oi d s e t u p ( ) {
66 | S e r i a l . b e gi n ( 9 6 0 0 ) ;
67 | pi n o 1 3 = new Pi n o ( Pi n o : : DIGITAL , 1 3 , OUTPUT, LOW) ;
68 | i n i c i a l i z a r E i x o s ( D r i v e r : : SOFTWARE) ;
69 | d e l a y ( 3 0 0 0 ) ;
70 | }
71 | v oi d l o o p ( ) {

72

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

77 | i f ( ! l e i t u r a . e q u a l s ( " " ) ) {
78 | i n t e r p r e t a r C o m a n d o s ( l e i t u r a ) ;
79 | l e i t u r a = " " ;
80 | }
81 | }
82 | }
83 | v oi d i n i c i a l i z a r E i x o s ( D r i v e r : : Ti p oAci o name nt o t p ) {
84 | pi n oE n a bleX | = new Pi n o ( Pi n o : : DIGITAL , PINO_ENABLE_X , OUTPUT, LOW) ;
85 | pi n oR e s etX | = new Pi n o ( Pi n o : : DIGITAL , PINO_RESET_X , OUTPUT, LOW) ;
86 | pi n o Sl e e pX | = new Pi n o ( Pi n o : : DIGITAL , PINO_SLEEP_X , OUTPUT, LOW) ;
87 | pinoM0X | = new Pi n o ( Pi n o : : DIGITAL , PINO_M0_X , OUTPUT, LOW) ;
88 | pinoM1X | = new Pi n o ( Pi n o : : DIGITAL , PINO_M1_X , OUTPUT, LOW) ;
89 | pinoM2X | = new Pi n o ( Pi n o : : DIGITAL , PINO_M2_X , OUTPUT, LOW) ;
90 | cursoMaximoX = new Pi n o ( Pi n o : : DIGITAL , PINO_CURSOMAXIMO_X, INPUT , HIGH ) ;
91 | cu rsoMinimoX = new Pi n o ( Pi n o : : DIGITAL , PINO_CURSOMINIMO_X , INPUT , HIGH ) ;
92 | si gm oi d al X | = new Si gm oi d al ( SIG_PERIODO_MAXIMO_X , SIG_PERIODO_MINIMO_X ,

SIG_DECLIVIDADE_X ) ;

93 | pi n oE n a bleY | = new Pi n o ( Pi n o : : DIGITAL , PINO_ENABLE_Y , OUTPUT, LOW) ;
94 | pi n oR e s etY | = new Pi n o ( Pi n o : : DIGITAL , PINO_RESET_Y , OUTPUT, LOW) ;
95 | pi n o Sl e e pY | = new Pi n o ( Pi n o : : DIGITAL , PINO_SLEEP_Y , OUTPUT, LOW) ;
96 | pinoM0Y | = new Pi n o ( Pi n o : : DIGITAL , PINO_M0_Y , OUTPUT, LOW) ;
97 | pinoM1Y | = new Pi n o ( Pi n o : : DIGITAL , PINO_M1_Y , OUTPUT, LOW) ;
98 | pinoM2Y | = new Pi n o ( Pi n o : : DIGITAL , PINO_M2_Y , OUTPUT, LOW) ;
99 | cursoMaximoY = new Pi n o ( Pi n o : : DIGITAL , PINO_CURSOMAXIMO_Y, INPUT , HIGH ) ;
100 | cu rsoMinimoY = new Pi n o ( Pi n o : : DIGITAL , PINO_CURSOMINIMO_Y , INPUT , HIGH ) ;
101 | si gm oi d al Y | = new Si gm oi d al ( SIG_PERIODO_MAXIMO_Y , SIG_PERIODO_MINIMO_Y ,

SIG_DECLIVIDADE_Y ) ;

102 | i f ( t p == D r i v e r : :HARDWARE) {
103 | pi n oP a s s oX | = new Pi n o ( Pi n o : : DIGITAL , PINO_PASSO_X , OUTPUT, LOW) ;
104 | pi n oDi r e c a oX = new Pi n o ( Pi n o : : DIGITAL , PINO_DIRECAO_X , OUTPUT, LOW) ;
105 | pi n oP a s s oY | = new Pi n o ( Pi n o : : DIGITAL , PINO_PASSO_Y , OUTPUT, LOW) ;
106 | pi n oDi r e c a oY = new Pi n o ( Pi n o : : DIGITAL , PINO_DIRECAO_Y , OUTPUT, LOW) ;
107 | d ri v e r X = new D r i v e r ( pi n oE na bleX , pi n oRe setX , pi n oSlee pX , pinoM0X ,

pinoM1X , pinoM2X , pi n oPa s s oX , pi n oDi r e c a oX ) ;

108 | d ri v e r Y = new D r i v e r ( pi n oE na bleY , pi n oRe setY , pi n oSlee pY , pinoM0Y ,

pinoM1Y , pinoM2Y , pi n oPa s s oY , pi n oDi r e c a oY ) ;

109 | } e l s e {
110 | pinoIN1X = new Pi n o ( Pi n o : : DIGITAL , PINO_IN1_X , OUTPUT, LOW) ;
111 | pinoIN2X = new Pi n o ( Pi n o : : DIGITAL , PINO_IN2_X , OUTPUT, LOW) ;

112 | pinoIN3X = new Pi n o ( Pi n o : : DIGITAL , PINO_IN3_X , OUTPUT, LOW) ;
113 | pinoIN4X = new Pi n o ( Pi n o : : DIGITAL , PINO_IN4_X , OUTPUT, LOW) ;
114 | pinoIN1Y = new Pi n o ( Pi n o : : DIGITAL , PINO_IN1_Y , OUTPUT, LOW) ;
115 | pinoIN2Y = new Pi n o ( Pi n o : : DIGITAL , PINO_IN2_Y , OUTPUT, LOW) ;
116 | pinoIN3Y = new Pi n o ( Pi n o : : DIGITAL , PINO_IN3_Y , OUTPUT, LOW) ;
117 | pinoIN4Y = new Pi n o ( Pi n o : : DIGITAL , PINO_IN4_Y , OUTPUT, LOW) ;
118 | d ri v e r X = new D r i v e r ( D r i v e r : : WAVESTEP, pi n oE na bleX , pi n oRe setX ,
| pi n oSlee pX , pinoM0X , pinoM1X , pinoM2X , pinoIN1X , pinoIN2X , pinoIN3X ,
| pinoIN4X , v e t o r P a s s o s ) ;
119 | d ri v e r Y = new D r i v e r ( D r i v e r : : WAVESTEP, pi n oE na bleY , pi n oRe setY ,
| pi n oSlee pY , pinoM0Y , pinoM1Y , pinoM2Y , pinoIN1Y , pinoIN2Y , pinoIN3Y ,
| pinoIN4Y , v e t o r P a s s o s ) ;
120 | }
121 | eixoX = new Ei x o ( d ri v e r X , MILIMETROS_POR_VOLTA_X , ESTADO_FIM_DE_CURSO_X ,
| cursoMaximoX , cursoMinimoX , si gm oi d al X ) ;
122 | eixoY = new Ei x o ( d ri v e r Y , MILIMETROS_POR_VOLTA_Y , ESTADO_FIM_DE_CURSO_Y ,
| cursoMaximoY , cursoMinimoY , si gm oi d al Y ) ;
123 | }
124 | v oi d i n t e r p r e t a r C o m a n d o s ( S t r i n g comando ) {
125 | comando . t oU p p e rC a s e ( ) ;
126 | i f ( comando . i n d e xO f ( "MOVER" ) > −1) movimenta rMesa ( comando . s u b s t r i n g (
| comando . i n d e xO f ( " " ) + 1 ) ) ;
127 | i f ( comando . i n d e xO f ( "L" ) > −1) pi n o 1 3 −> s e t E s t a d o (HIGH ) ;
128 | i f ( comando . i n d e xO f ( "D" ) > −1) pi n o 1 3 −> s e t E s t a d o (LOW) ;
129 | i f ( comando . i n d e xO f ( "MODOPASSOX" ) > −1) e s c ol h e rM o d o P a s s o ( eixoX , comando .
| s u b s t r i n g ( comando . i n d e xO f ( " " ) + 1 ) ) ;
130 | i f ( comando . i n d e xO f ( "MODOPASSOY" ) > −1) e s c ol h e rM o d o P a s s o ( eixoY , comando .
| s u b s t r i n g ( comando . i n d e xO f ( " " ) + 1 ) ) ;
131 | }
132 | v oi d movimenta rMesa ( S t r i n g c o o r d e n a d a ) {
133 | i f ( ! ( c o o r d e n a d a . i n d e xO f ( " , " ) == −1) ) {
134 | x = c o o r d e n a d a . s u b s t r i n g ( 0 , c o o r d e n a d a . i n d e xO f ( " , " ) ) . t oD o u bl e ( ) ;
135 | y = c o o r d e n a d a . s u b s t r i n g ( c o o r d e n a d a . i n d e xO f ( " , " ) + 1 ) . t oD o u bl e ( ) ;
136 | i f ( x >= 0 && x <= 10 && y >= 0 && y <= 1 0 ) {
137 | i f ( x != eixoX −> g e t P o s i c a o ( ) ) {
138 | eixoX −> r o t a c i o n a r P a r a ( x ) ;
139 | S e r i a l . p r i n t l n ( eixoX −> g e t P o s i c a o ( ) ) ;
140 | }
141 | i f ( y != eixoY −> g e t P o s i c a o ( ) ) {

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

Listing A.1 – Código principal para o controle da mesa cartesiana.

APÊNDICE B – CÓDIGO DA CLASSE EIXO PARA O CONTROLE DO EIXO

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

ANTIHORARIO,

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

Listing B.1 – Código da classe eixo para o controle do eixo.

APÊNDICE C – CÓDIGO DA CLASSE DRIVER PARA O CONTROLE DO DRIVER DE

POTÊNCIA.

1 | # i f n d e f DRIVER_H_INCLUDED
2 | # d e f i n e DRIVER_H_INCLUDED
3 | c l a s s D r i v e r {
4 | p u bli c :
5 | enum Ti p oAci o name nt o {
6 | SOFTWARE | = 0 ,
7 | HARDWARE | = 1
8 | } ;
9 | enum Ti p o P a s s o {
10 | WAVESTEP | = 0 ,
11 | FULLSTEP | = 1 ,
12 | HALFSTEP | = 2
13 | } ;
14 | enum Di r e c a o {
15 | ANTIHORARIO = −1 ,
16 | HORARIO | = | 1
17 | } ;
18 | ~ D r i v e r ( v oi d ) {}
19 | D r i v e r ( Pi n o * pino IN1 , Pi n o * pino IN2 , Pi n o * pino IN3 , Pi n o * pino IN4 , b yt e

* v e t o r P a s s o s ) {

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

109 | p r i v a t e :
110 | Pi n o * pi n oE n a bl e , * pi n oR e s et , * pi n o Sl e e p , *pinoM0 , *pinoM1 , *pinoM2 , *

pi n o P a s s o , * pi n o Di r e c a o , * pino IN1 , * pino IN2 , * pino IN3 , * pi n o IN 4 ;

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

) {

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

Listing C.1 – Código da classe driver para o controle do driver de potência

APÊNDICE D – CÓDIGO DA CLASSE PINO PARA O CONTROLE DOS PINOS

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

numero ) : a n al o gR e a d ( t h i s −>numero ) ;

35 | r e t u r n t h i s −> e s t a d o ;

36 | }
37 | p r i v a t e :
38 | Ti p o Pi n o t i p o { Ti p o Pi n o : : DIGITAL } ;
39 | b yt e numero { 0 } ;
40 | b yt e modo { OUTPUT } ;
41 | un si gned i n t e s t a d o { LOW } ;
42 | v oi d s e t T i p o ( Ti p o Pi n o t ) {
43 | t h i s −> t i p o = t ;
44 | }
45 | v oi d setN ume r o ( b yt e n ) {
46 | t h i s −>numero = n ;
47 | }
48 | } ;
49 | # e n d i f

Listing D.1 – Código da classe Pino para o controle dos pinos.

APÊNDICE E – CÓDIGO DA CLASSE SIGMOIDAL PARA O CONTROLE DA

ACELERAÇÃO DOS MOTORES

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

Listing E.1 – Código da classe Sigmoidal para o controle da aceleração dos motores.

APÊNDICE F – CÓDIGO DO HEADER STDRIVER PARA O INCLUDE DE CLASSES

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

Listing F.1 – Código do header StDriver para o include de classes.

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

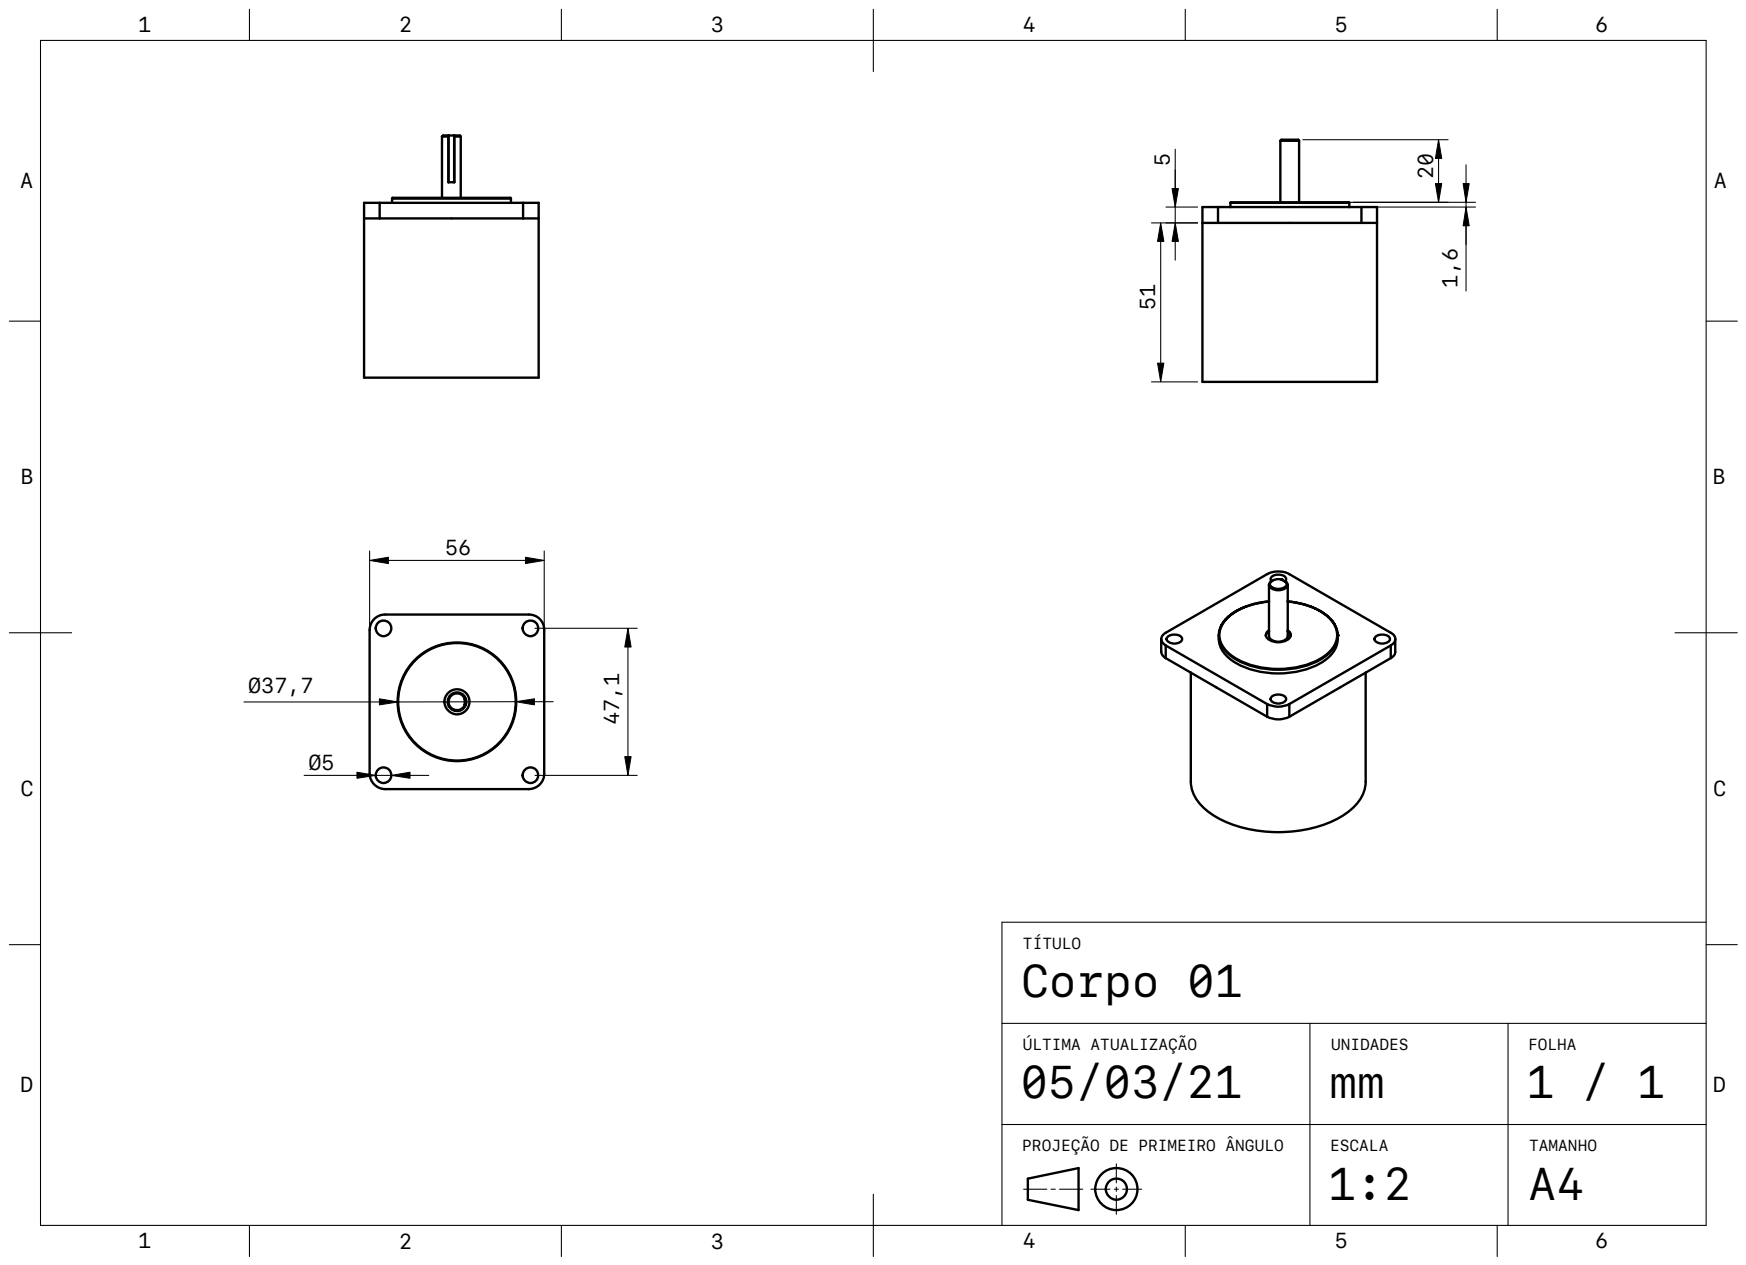
[picture p24: page 78]

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

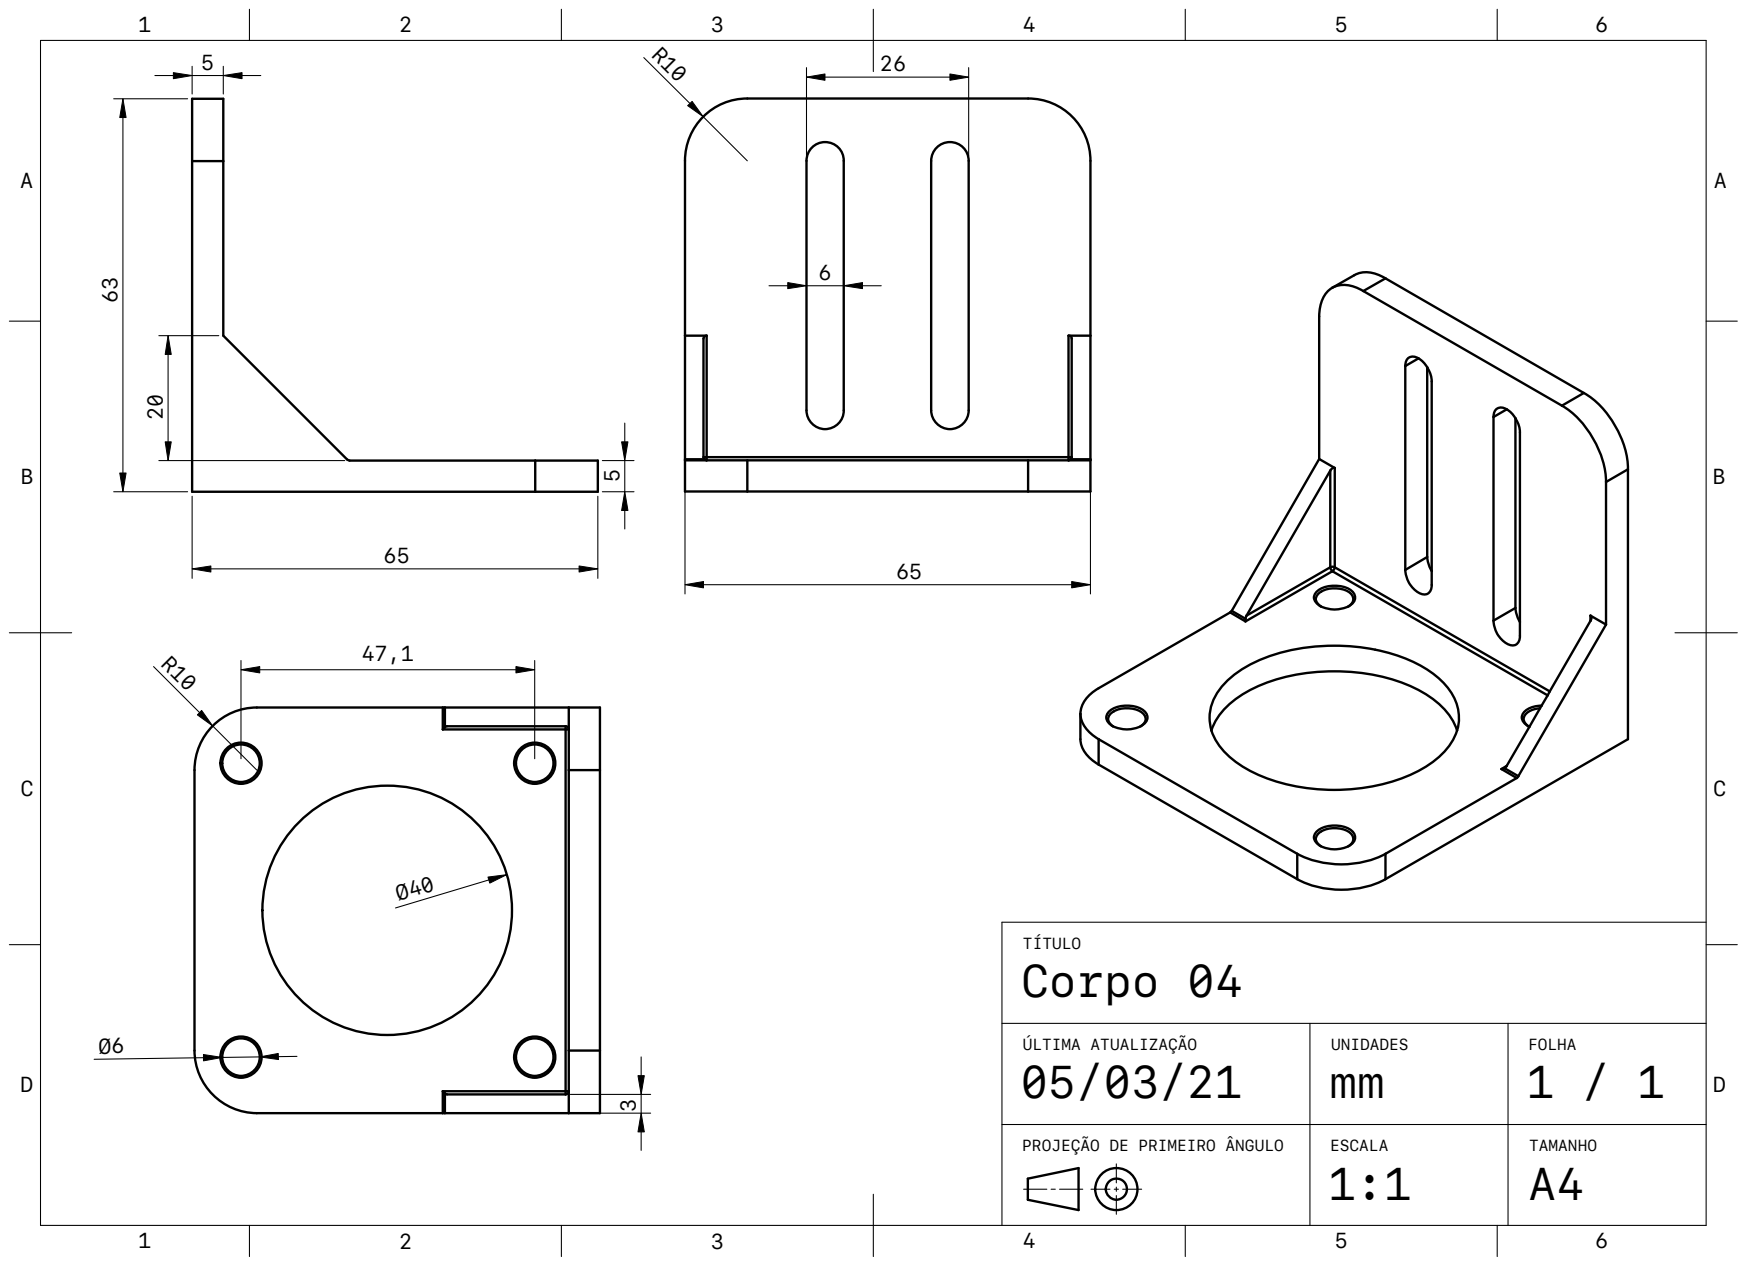
[picture p25: page 79]
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
