abaldezjr/tcc/info.tex

%\trabalhoacademico{tccgraduacao}
%\ehqualificacao{nao}
\removerbordasdohyperlink{sim} 

\ies{Universidade Federal do Rio Grande}
\iessigla{FURG}
\profissao{Engenheiro Mecânico}
\graduacaoem{Engenharia Mecânica Empresarial}
\habilitacao{bacharel}

\autor{Alexandre Marques Baldez Junior, \\ Rodrigo de Souza Torma\\}
\titulo{SISTEMA DE COORDENADAS PARA POSICIONAMENTO DE INSTRUMENTOS DE MEDIÇÃO EM UM TÚNEL DE VENTO}
\data{2021}
\local{Rio Grande, Rio Grande do Sul}
\dataaprovacao{27 de maio de 2021}

\orientador{Prof. Dr. Gustavo da Cunha Dias}
\orientadories{Universidade Federal do Rio Grande}
\orientadorcentro{Escola de Engenharia}
%\orientadorfeminino{nao}

\coorientador{Prof. Me. Letieri Rodrigues de Ávila}
\coorientadories{Universidade Federal do Rio Grande - FURG}
\coorientadorcentro{Escola de Engenharia}
%\coorientadorfeminino{nao}

\membrodabancadois{Profa.~Me.~Fernanda~Mazuco~Clain}
\membrodabancadoisies{Universidade Federal do Rio Grande - FURG}
\membrodabancadoiscentro{Escola de Engenharia}
