abaldezjr/tcc/elementos-pre-textuais/agradecimentos.tex

Aos meus amados pais Alexandre Marques Baldez e Gladistani Malta Vaz Baldez por compreenderem a minha ausência enquanto eu me dedicava a realização deste trabalho, por me ensinarem o valor da educação e pelo apoio incondicional.

A Fernanda Chaves Lopes que também me ajudou, compreendeu e ensinou nessa caminhada.

Agradeço também ao Rodrigo Torma pela amizade, determinação e foco no desenvolvimento deste Trabalho.

\begin{flushright}Alexandre\end{flushright}

Agradeço à minha família em especial a minha mãe Bernardina por ser um exemplo para minha vida e a minha esposa Jaqueline por não medir esforços para que eu chegasse até aqui. Agradeço também ao meu parceiro de projeto Alexandre, por ser incansável no desenvolvimento deste Trabalho.

\begin{flushright}Rodrigo\end{flushright}
    
Em especial gostaríamos de agradecer aos nossos queridos e incansáveis orientadores Gustavo da Cunha Dias e Letieri Rodrigues de Ávila por acreditarem em nossa capacidade, nos dar o suporte, amizade e terem sido indispensáveis neste ciclo.

Agradecemos a professora Fernanda Mazuco Clain que aceitou ser banca deste trabalho colaborando para sua melhoria e nossa formação.

À Universidade Federal do Rio Grande por todo crescimento pessoal e profissional que vem nos proporcionando.

Aos amigos e companheiros de profissão que convivemos ao longo desses anos de curso, que nos incentivaram e tiveram impacto em nossas trajetórias.
