abaldezjr/tcc/elementos-pre-textuais/epigrafe.tex

``Projetos conjuntos têm mais chance de sucesso quando se beneficiam de
ambos os lados.''

\autordaepigrafe{EURÍPEDES}
