abaldezjr/tcc/elementos-pre-textuais/dedicatoria.tex

À minha família, por sua capacidade de acreditar em mim e investir em mim. Mãe, seu cuidado e 
dedicação foi que deram, em alguns momentos, a esperança para seguir. Pai, sua presença significou 
segurança e certeza de que não estou sozinho nessa caminhada.
