abaldezjr/tcc/figuras/detalhe45.jpeg

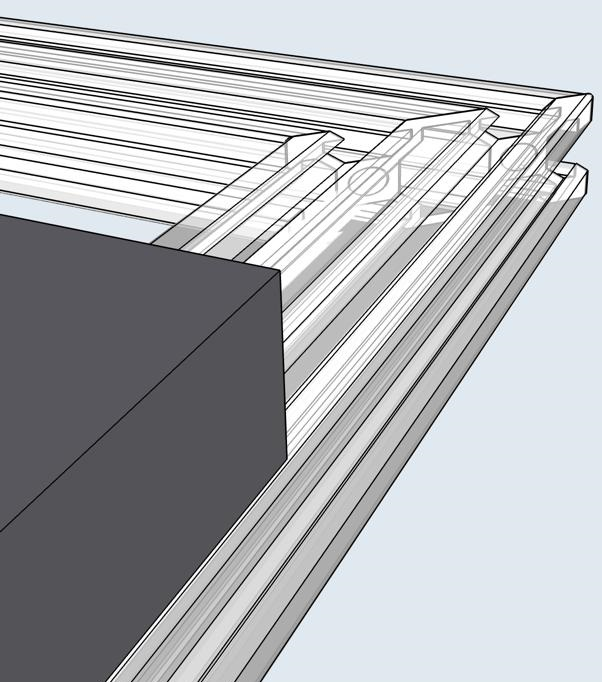
figuras/detalhe45.jpeg
