abaldezjr/tcc/figuras/diagramaclasses.png

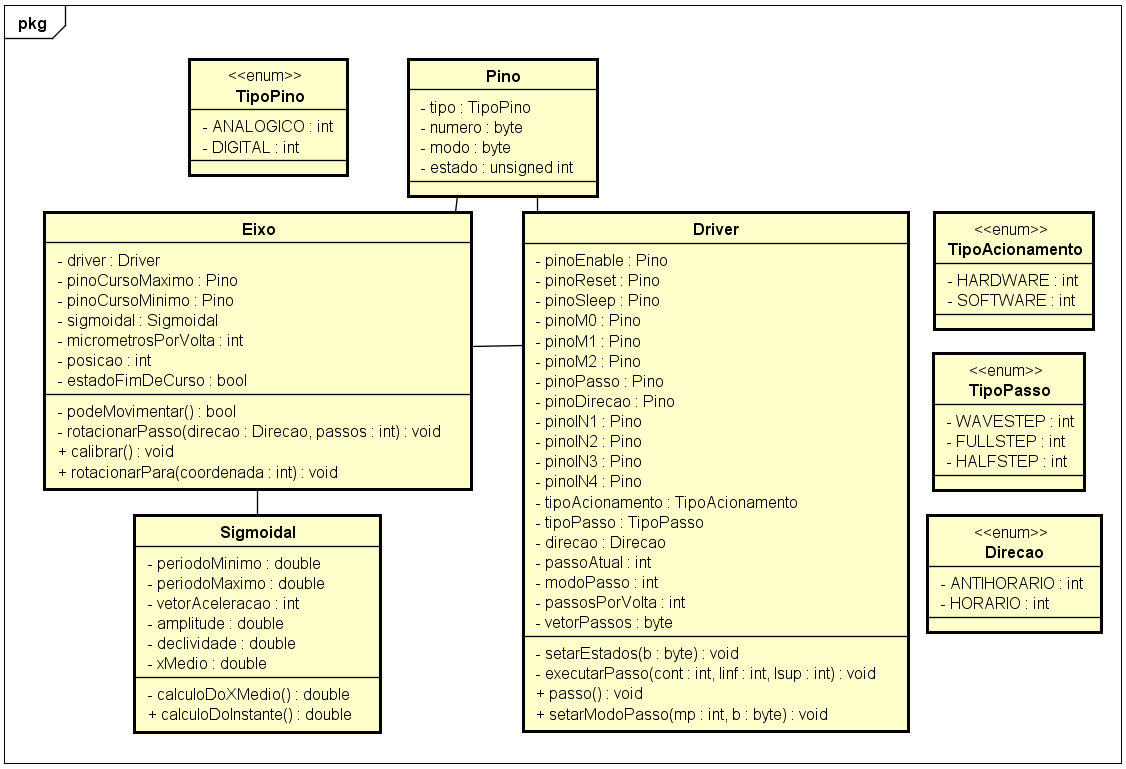
figuras/diagramaclasses.png
