abaldezjr/tcc/figuras/diagramcorpolivre.jpg

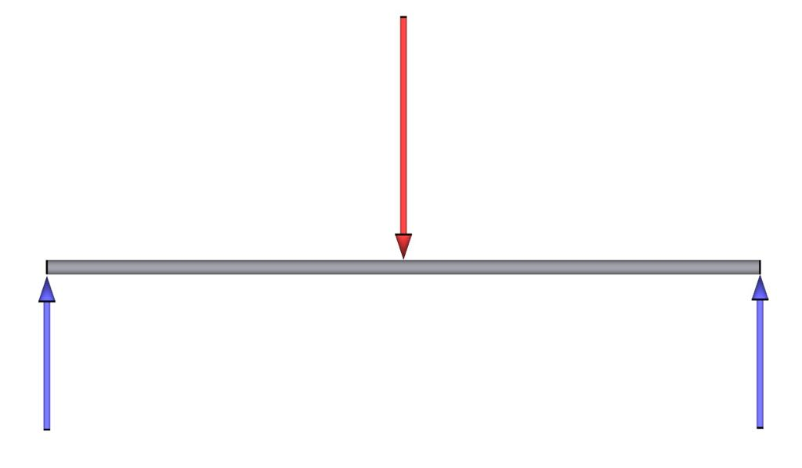
figuras/diagramcorpolivre.jpg
