abaldezjr/tcc/figuras/didaticopasso.png

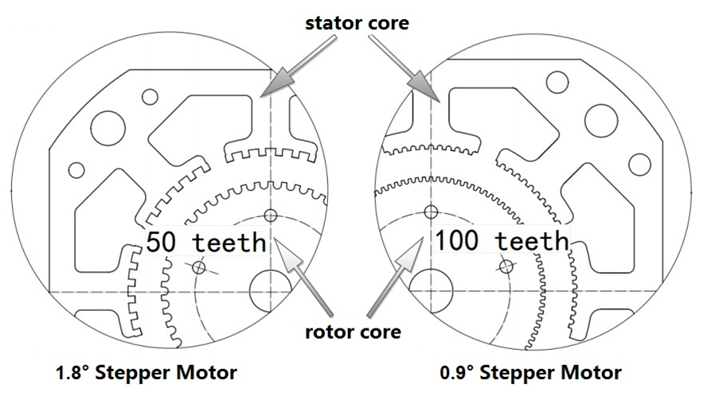
figuras/didaticopasso.png
