abaldezjr/tcc/figuras/driverportas.png

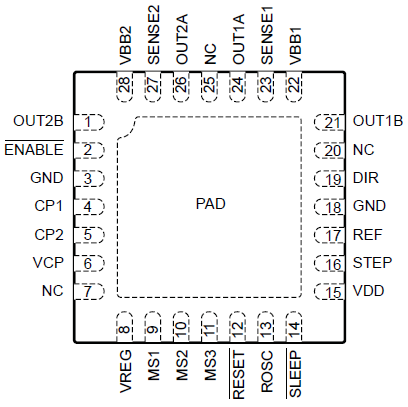
figuras/driverportas.png
