abaldezjr/tcc/figuras/esqforcafuso.jpg

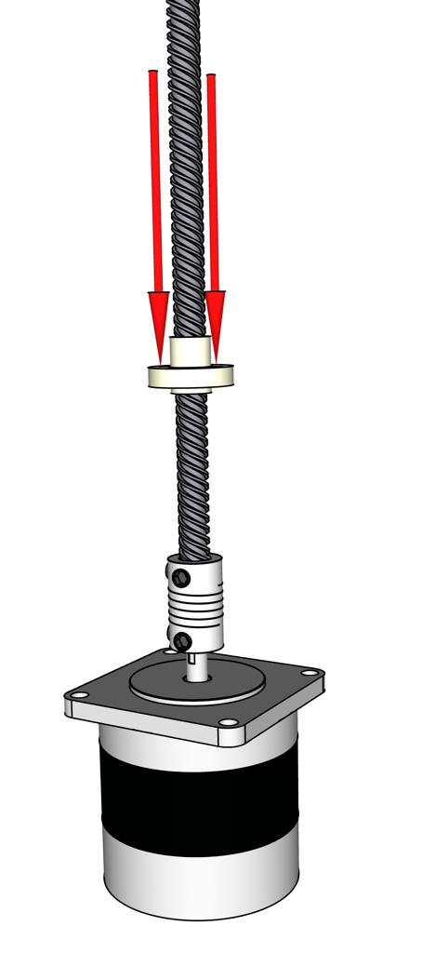
figuras/esqforcafuso.jpg
