abaldezjr/tcc/figuras/estruturamesa.jpeg

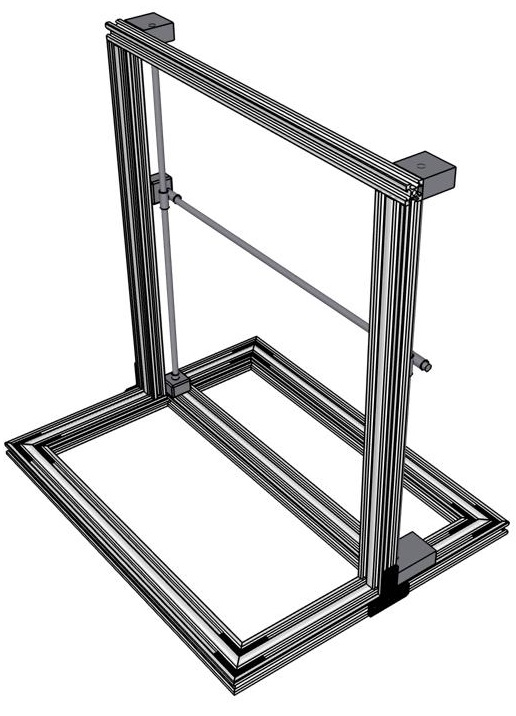
figuras/estruturamesa.jpeg
