abaldezjr/tcc/figuras/fluxogramaeletronico.jpeg

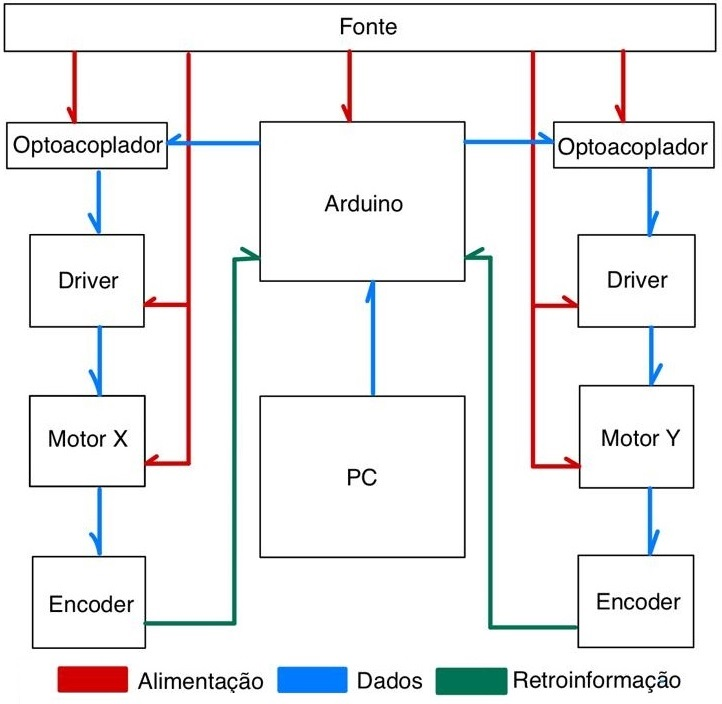
figuras/fluxogramaeletronico.jpeg
