abaldezjr/tcc/figuras/fonte.png

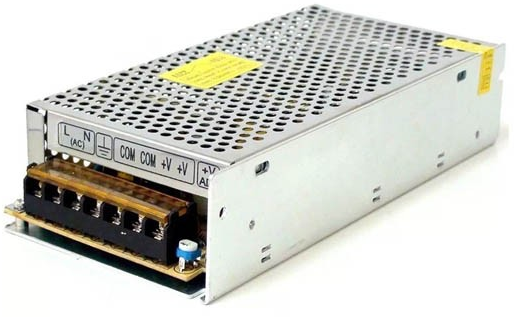
figuras/fonte.png
