abaldezjr/tcc/figuras/forcadente.jpg

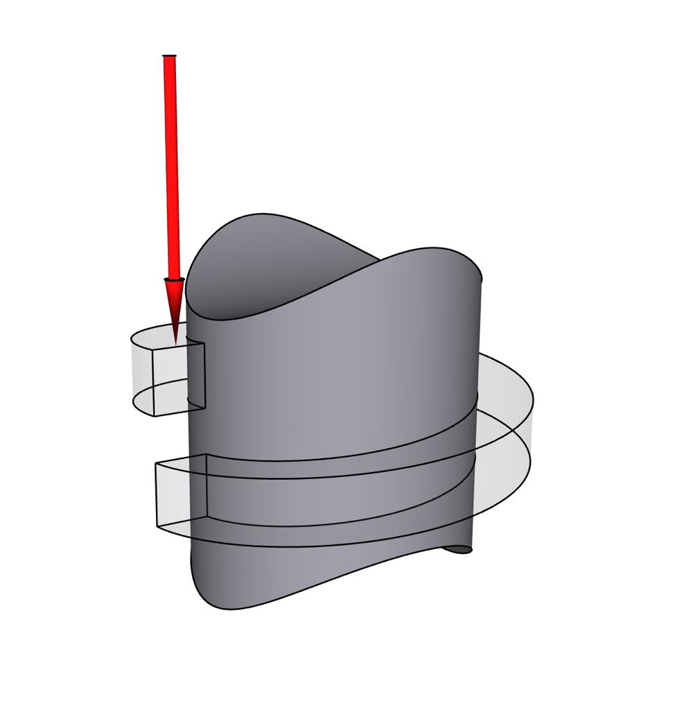
figuras/forcadente.jpg
