abaldezjr/tcc/figuras/mesacartesiana01.jpg

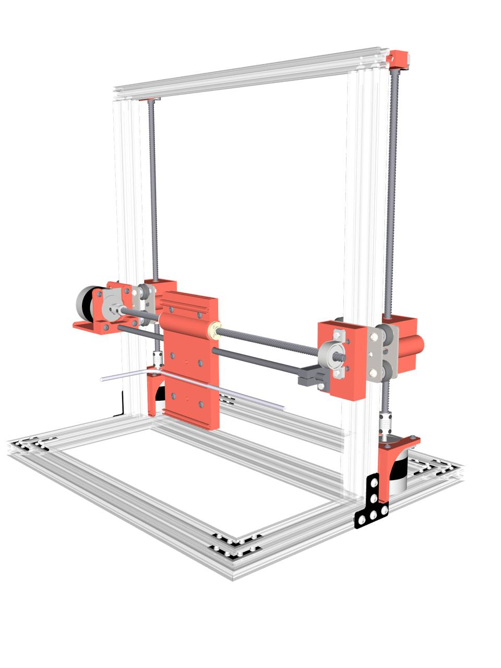
figuras/mesacartesiana01.jpg
