abaldezjr/tcc/figuras/mesacartesiana02.jpg

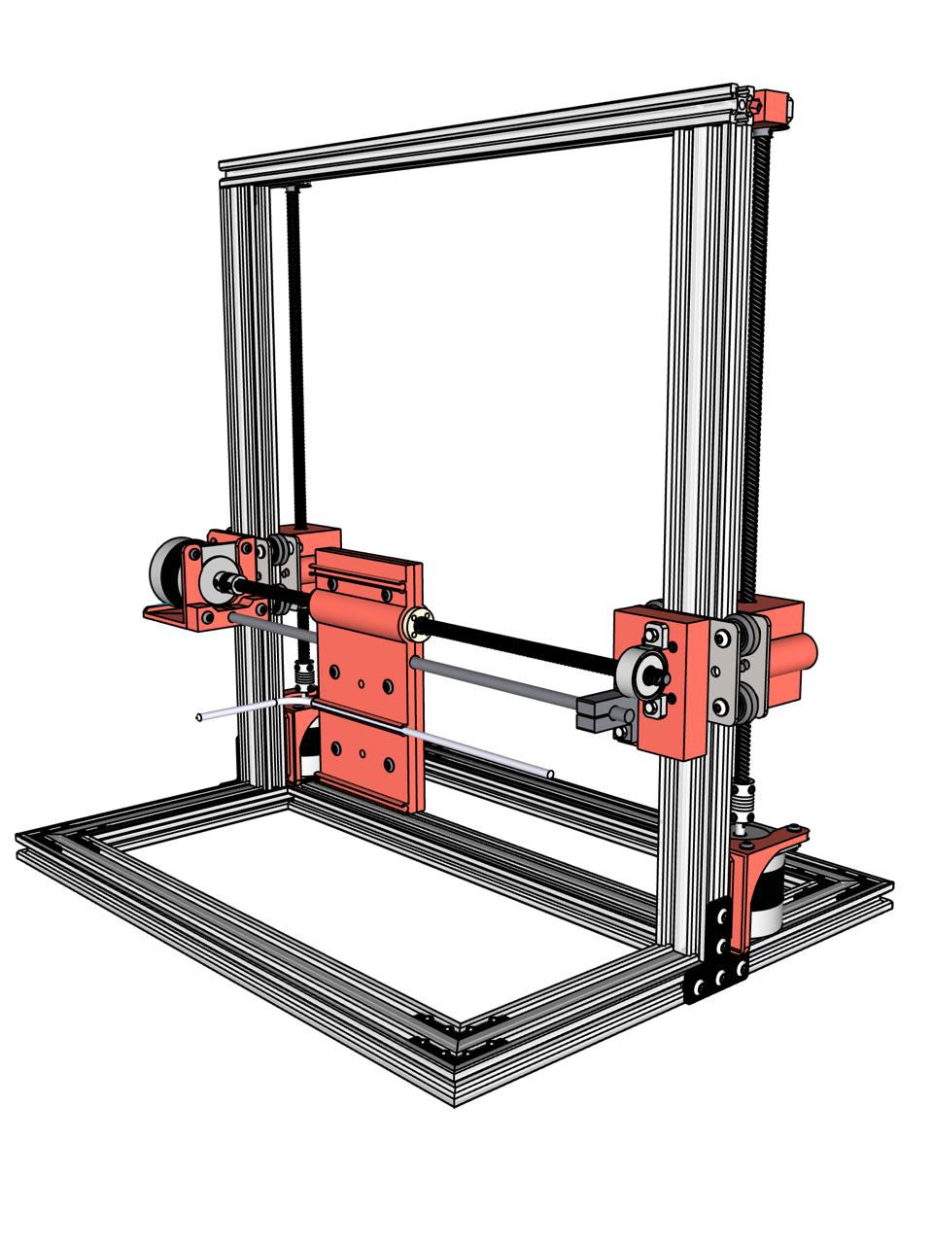
figuras/mesacartesiana02.jpg
