abaldezjr/tcc/figuras/mesacartesiana03.jpg

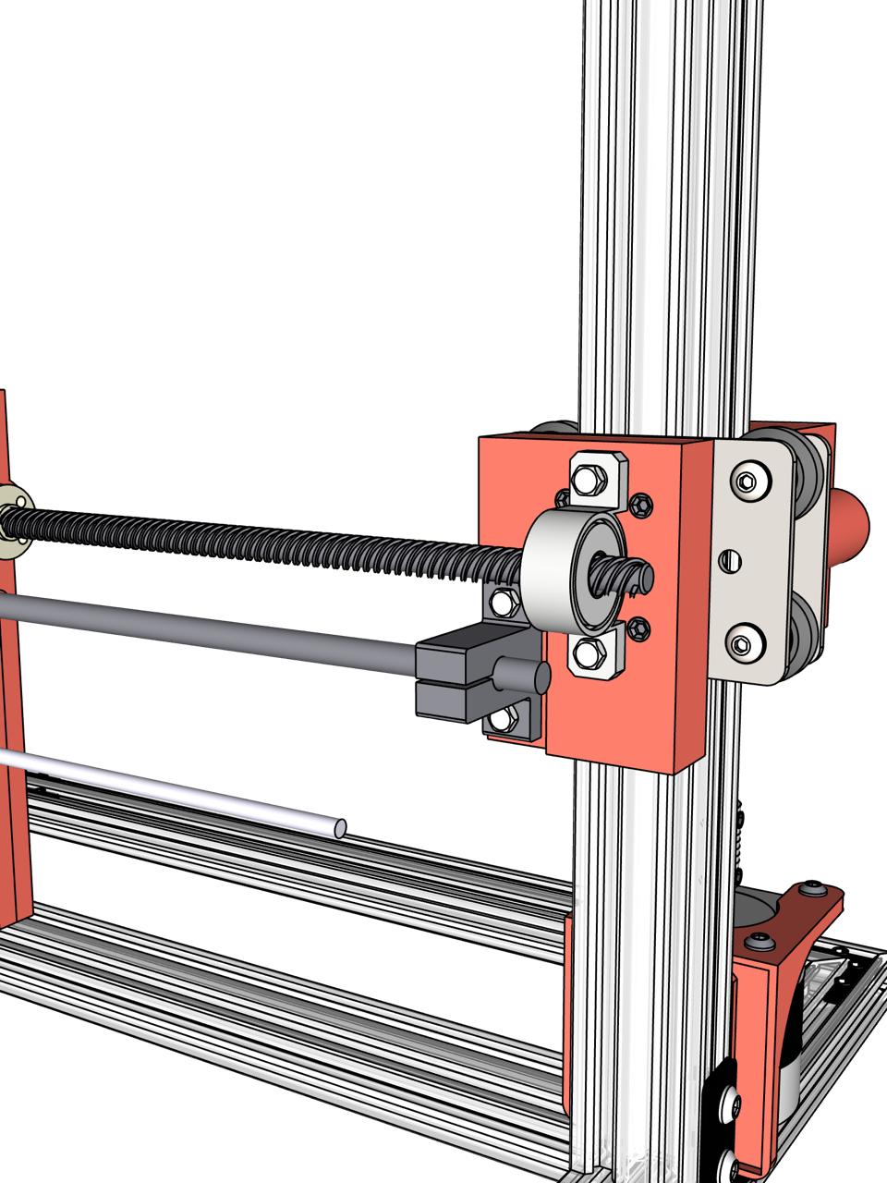
figuras/mesacartesiana03.jpg
