abaldezjr/tcc/figuras/mesacartesiana04.jpg

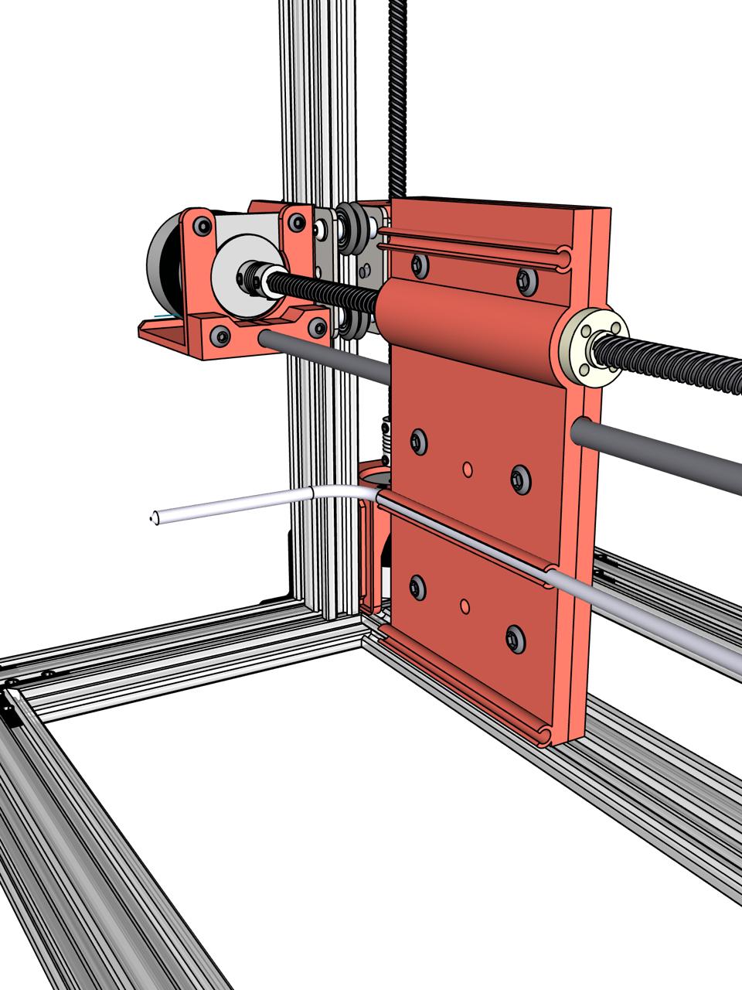
figuras/mesacartesiana04.jpg
