abaldezjr/tcc/figuras/mesacartesiana05.jpg

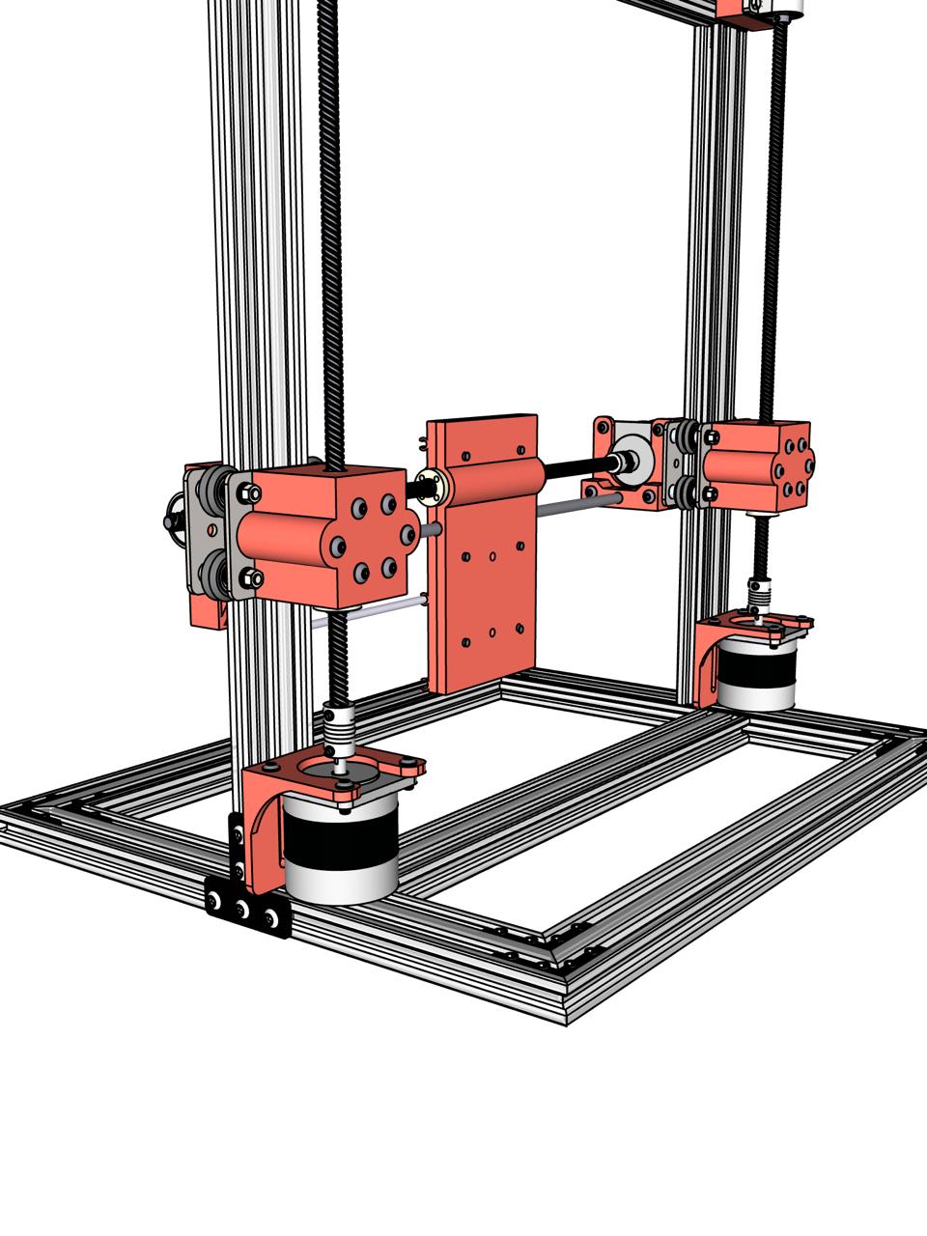
figuras/mesacartesiana05.jpg
