abaldezjr/tcc/figuras/mesacartesianaexplodida.jpg

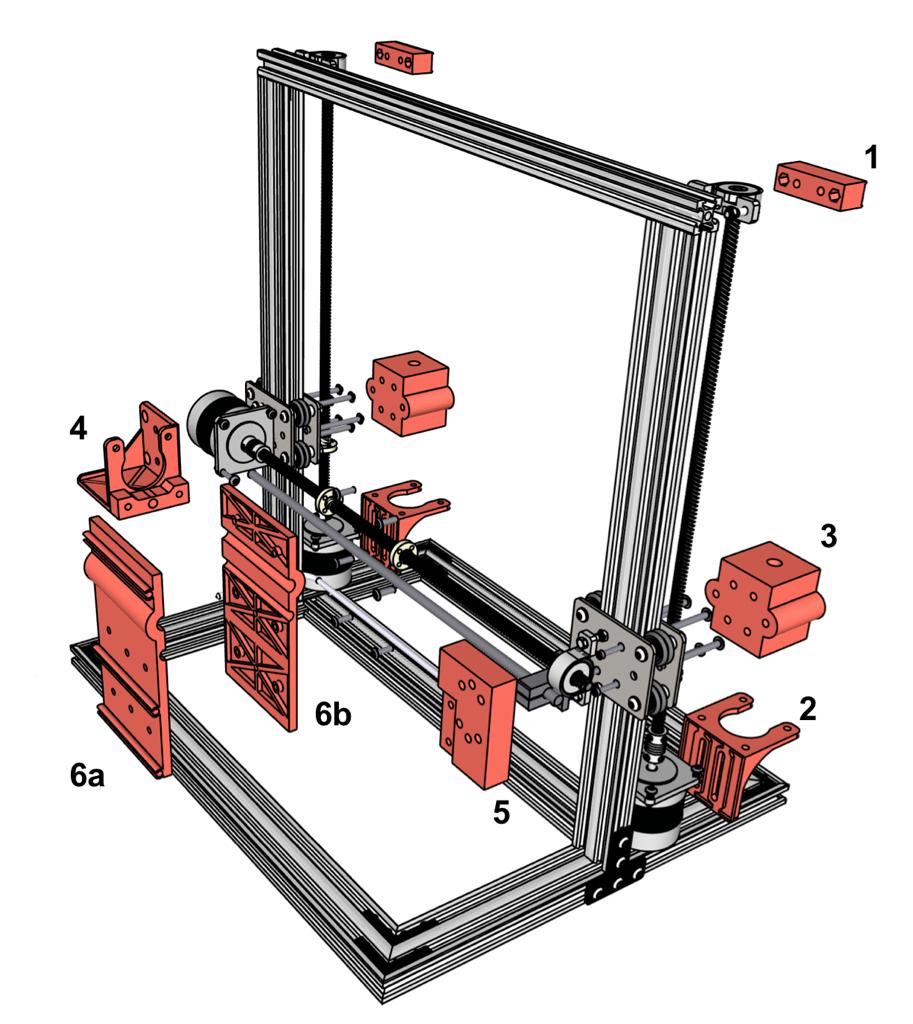
figuras/mesacartesianaexplodida.jpg
