abaldezjr/tcc/figuras/mesacartesianafrontal.jpg

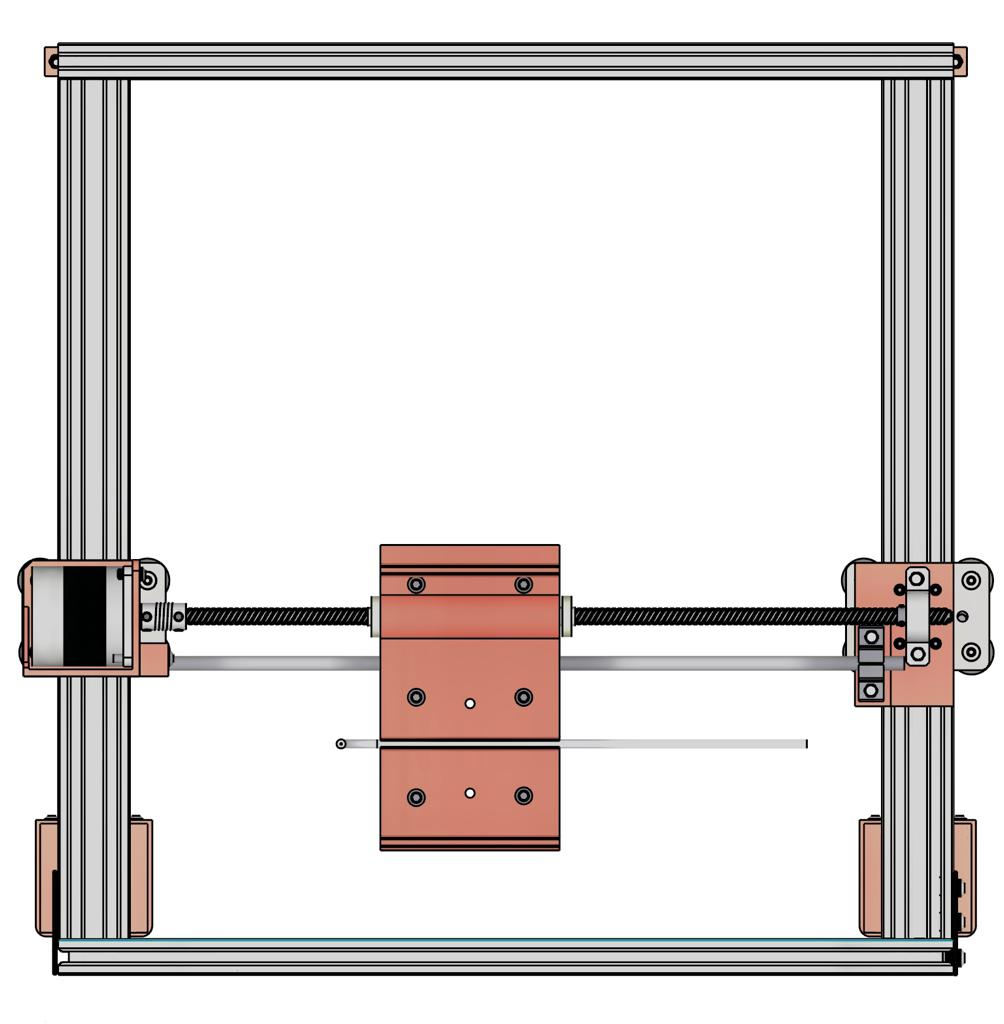
figuras/mesacartesianafrontal.jpg
