abaldezjr/tcc/figuras/mesacartesianalateral.jpg

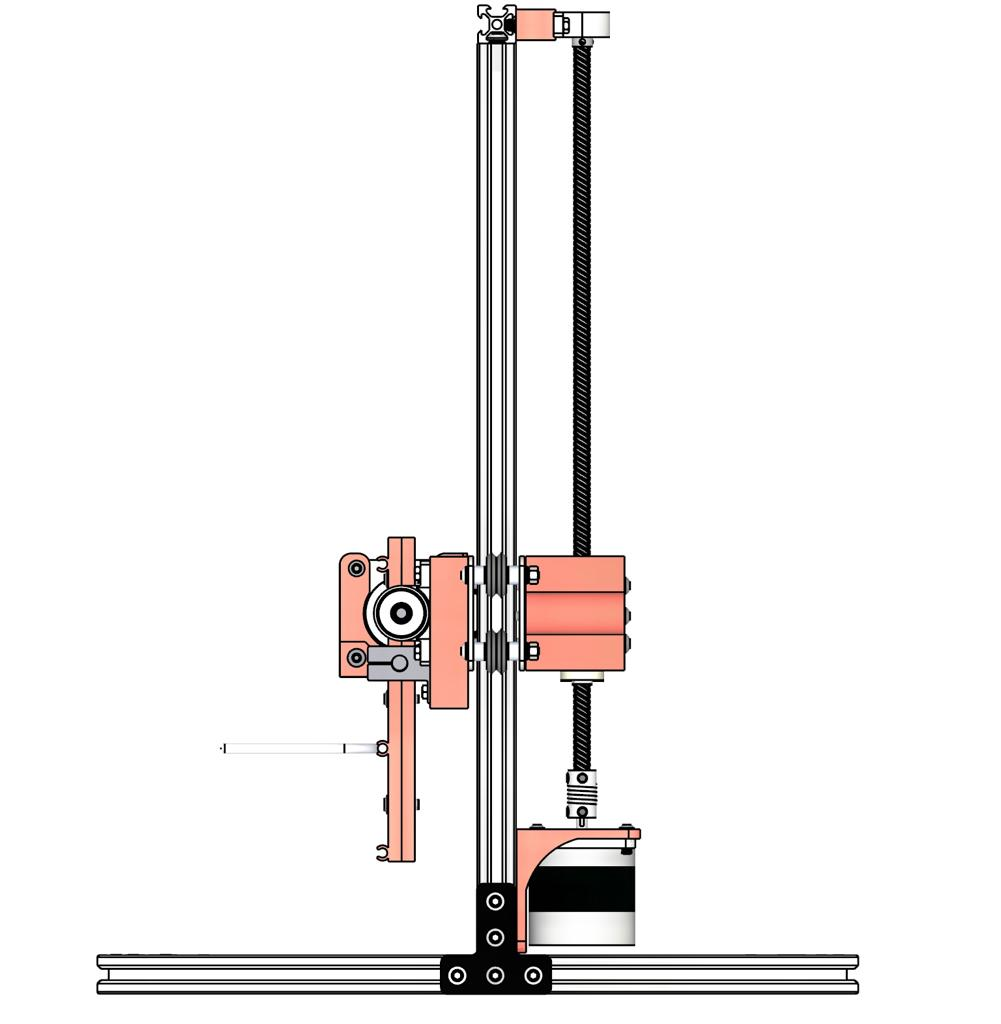
figuras/mesacartesianalateral.jpg
