abaldezjr/tcc/figuras/mesacartesianaperfil.jpg

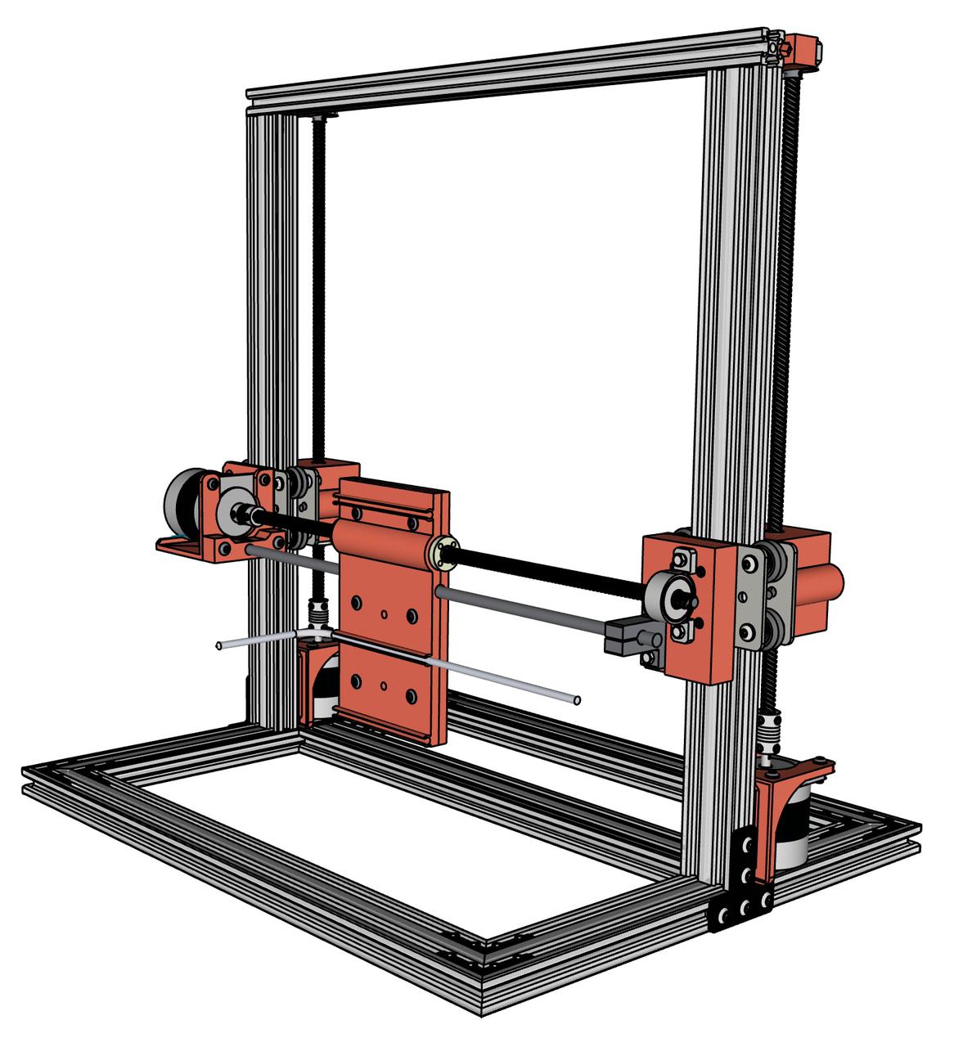
figuras/mesacartesianaperfil.jpg
