abaldezjr/tcc/figuras/mesacartesianaperfiltraseira.jpg

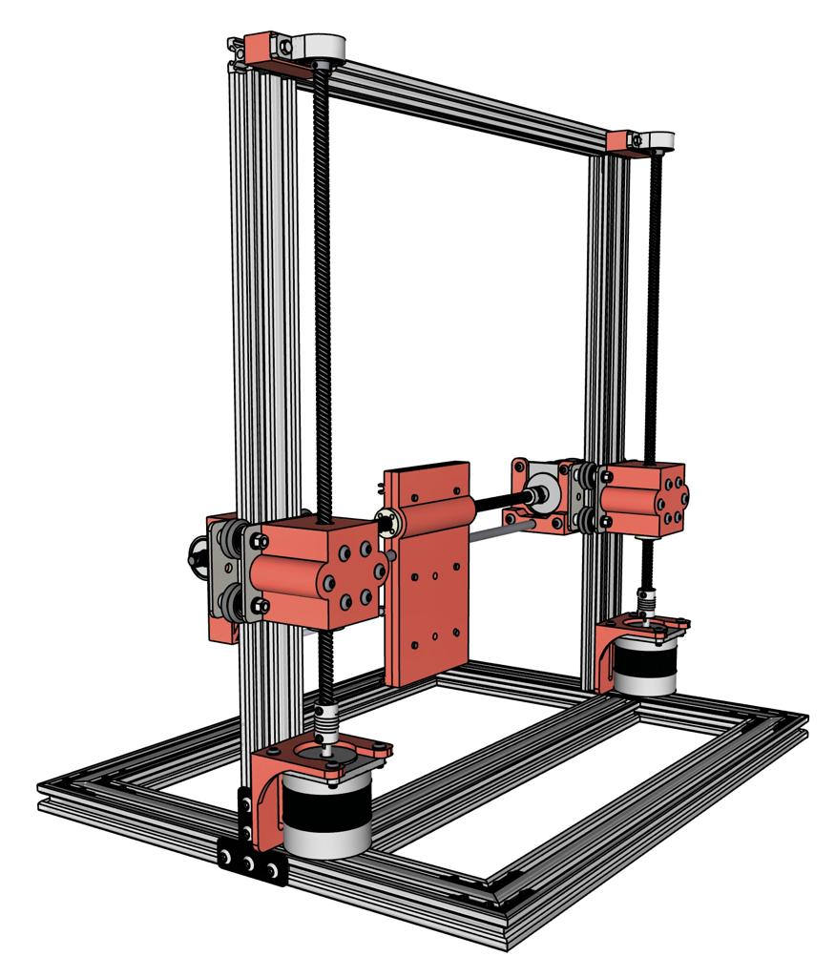
figuras/mesacartesianaperfiltraseira.jpg
