abaldezjr/tcc/figuras/mesacartesianatraseira.jpg

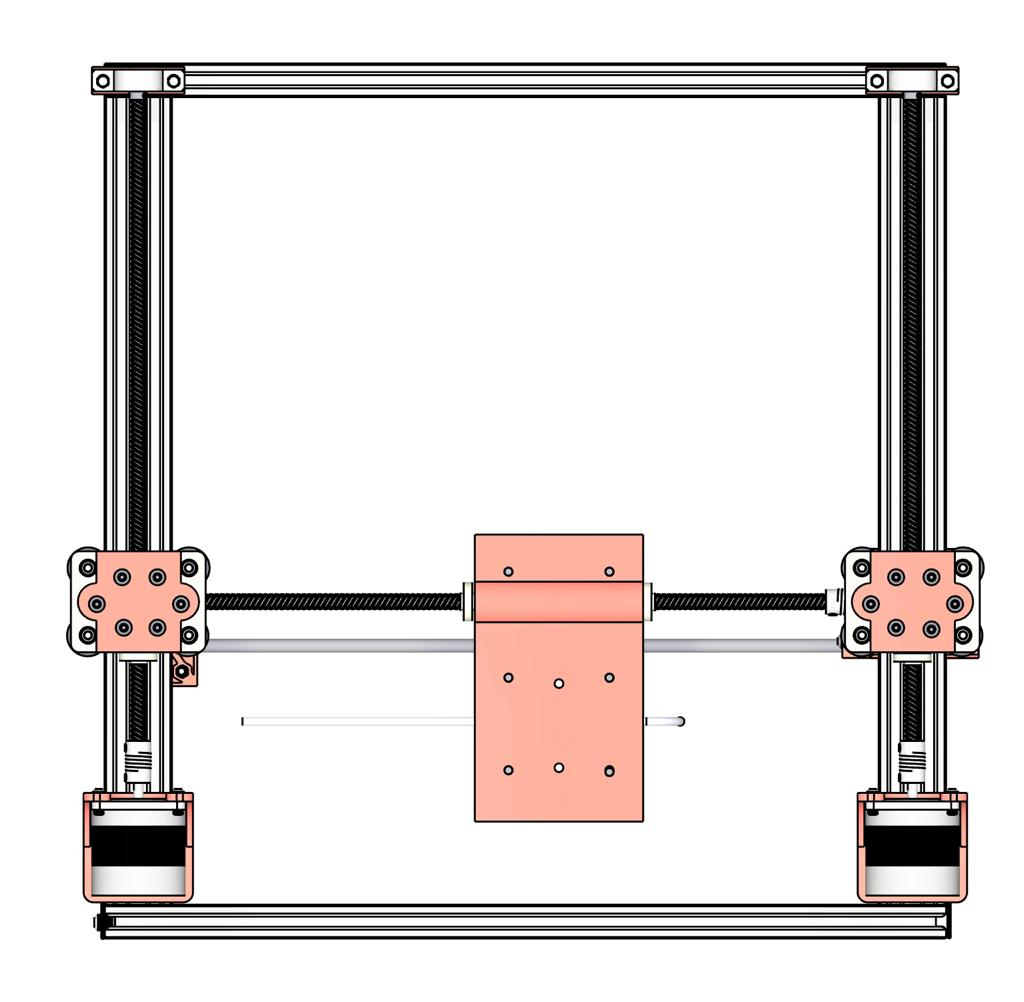
figuras/mesacartesianatraseira.jpg
