abaldezjr/tcc/figuras/mesatunel.jpg

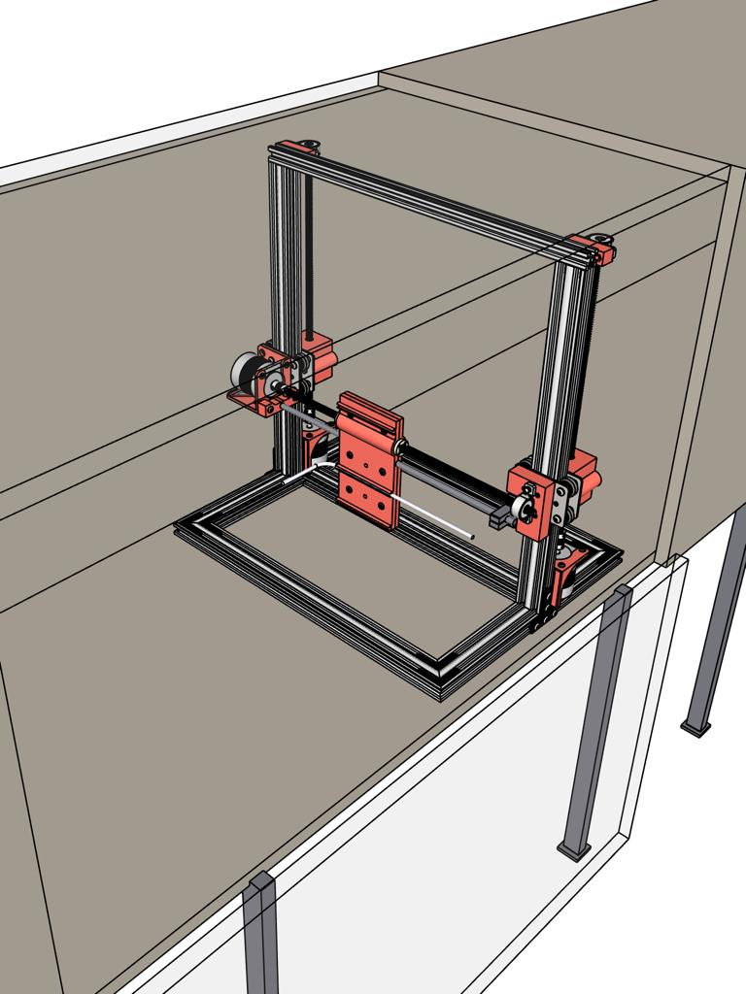
figuras/mesatunel.jpg
