abaldezjr/tcc/figuras/meumotorbipolar.png

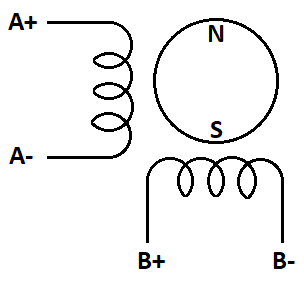
figuras/meumotorbipolar.png
