abaldezjr/tcc/figuras/mfuso.png

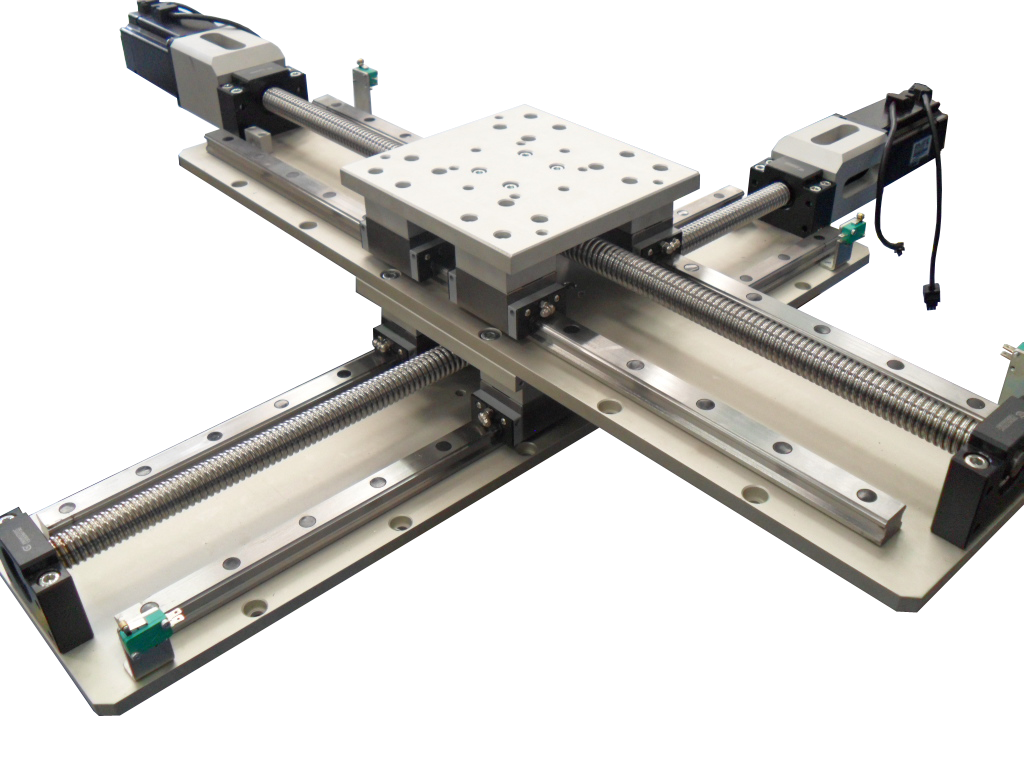
figuras/mfuso.png
