abaldezjr/tcc/figuras/nfuso2.jpeg

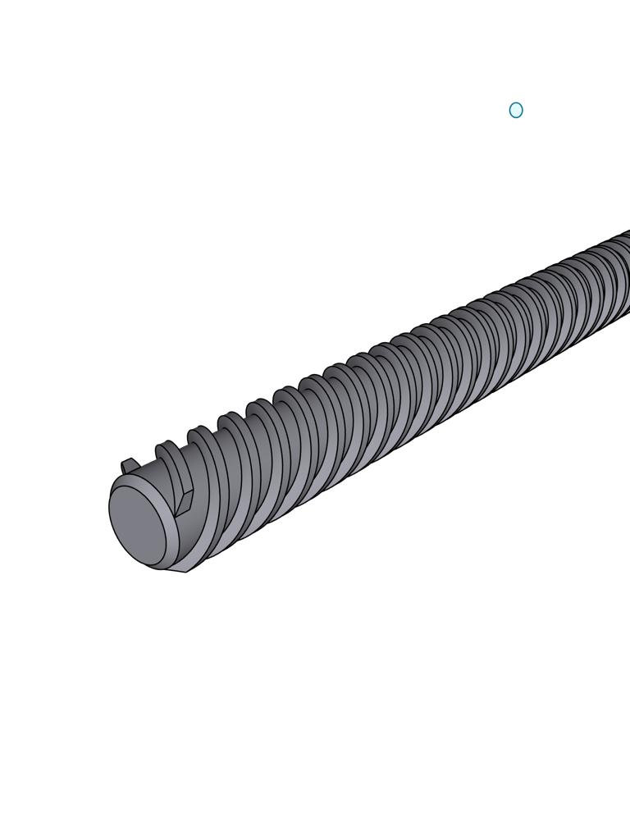
figuras/nfuso2.jpeg
