abaldezjr/tcc/figuras/nfuso.jpeg

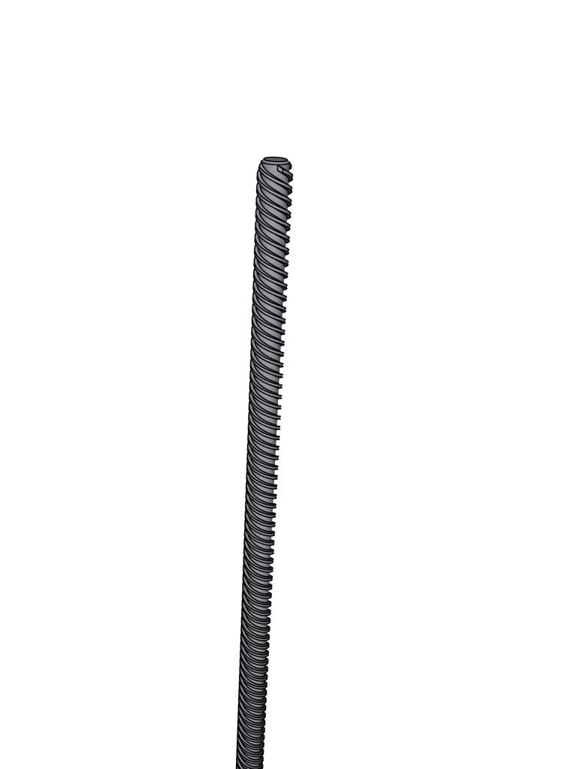
figuras/nfuso.jpeg
