abaldezjr/tcc/figuras/nmotor.jpeg

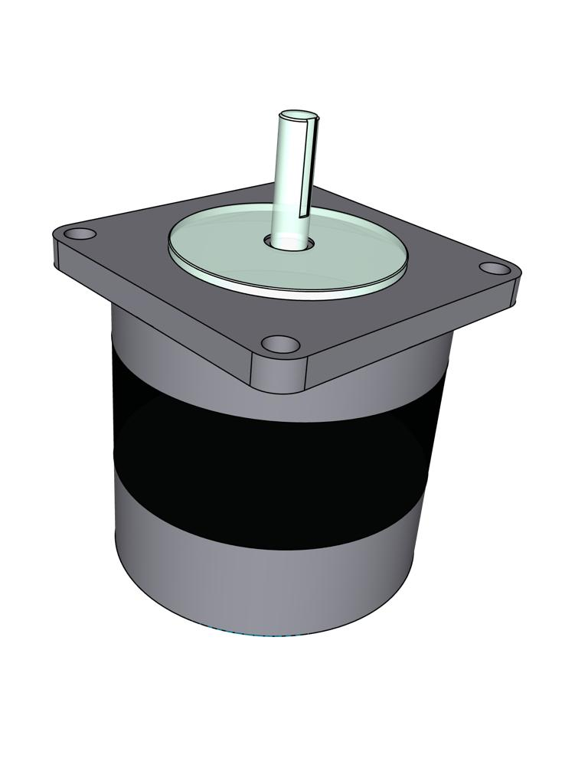
figuras/nmotor.jpeg
