abaldezjr/tcc/figuras/nsup2.jpeg

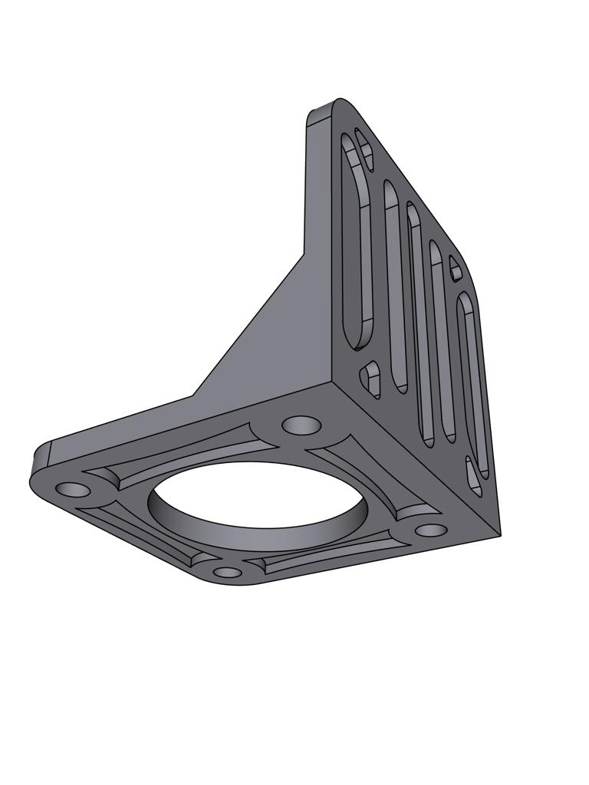
figuras/nsup2.jpeg
