abaldezjr/tcc/figuras/nsup3.jpeg

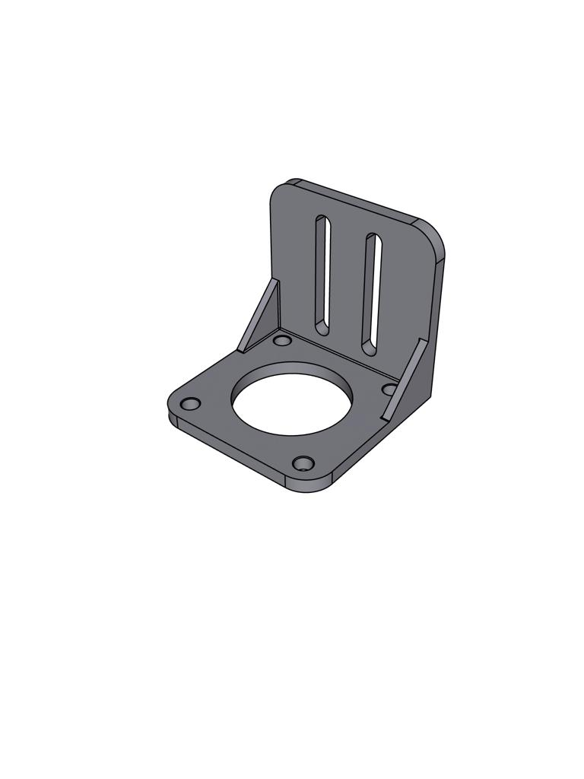
figuras/nsup3.jpeg
