abaldezjr/tcc/figuras/nsup.jpeg

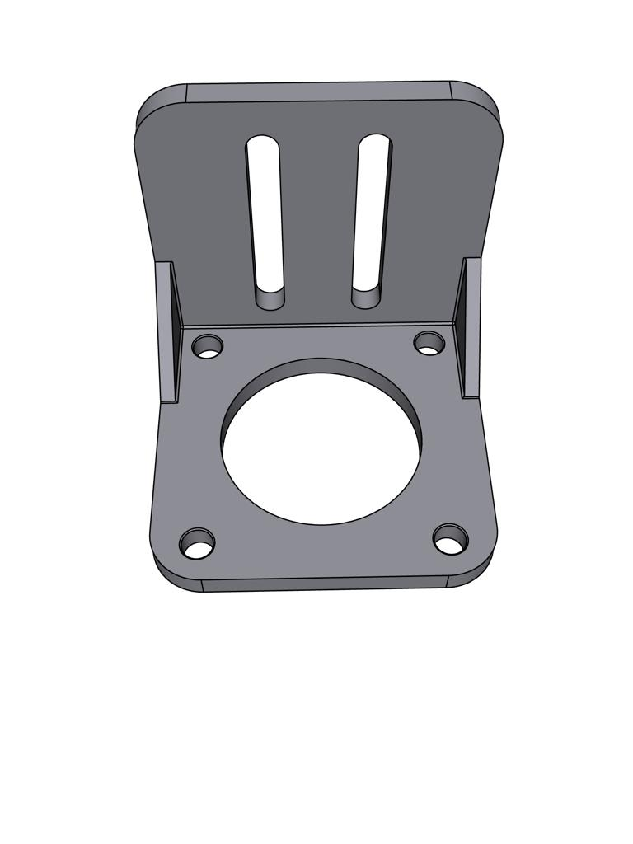
figuras/nsup.jpeg
