abaldezjr/tcc/figuras/nsupmot.jpeg

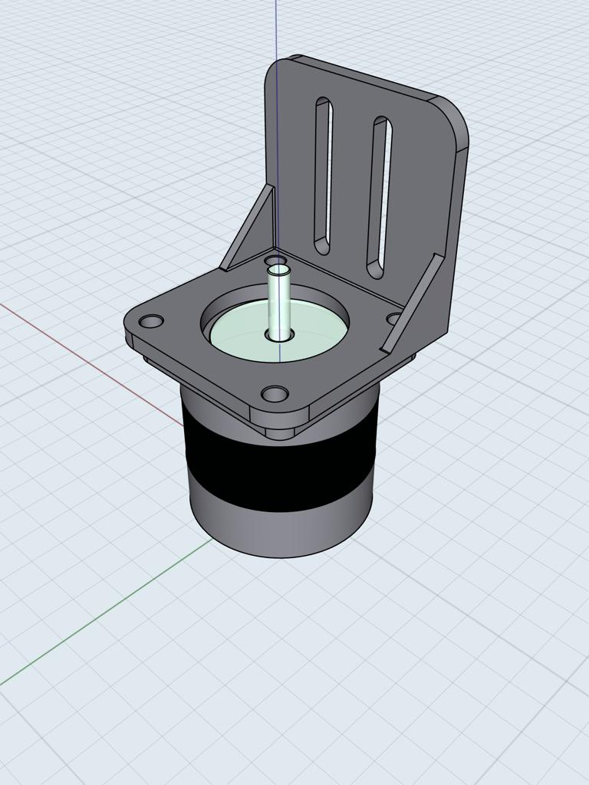
figuras/nsupmot.jpeg
