abaldezjr/tcc/figuras/orgsoftware.png

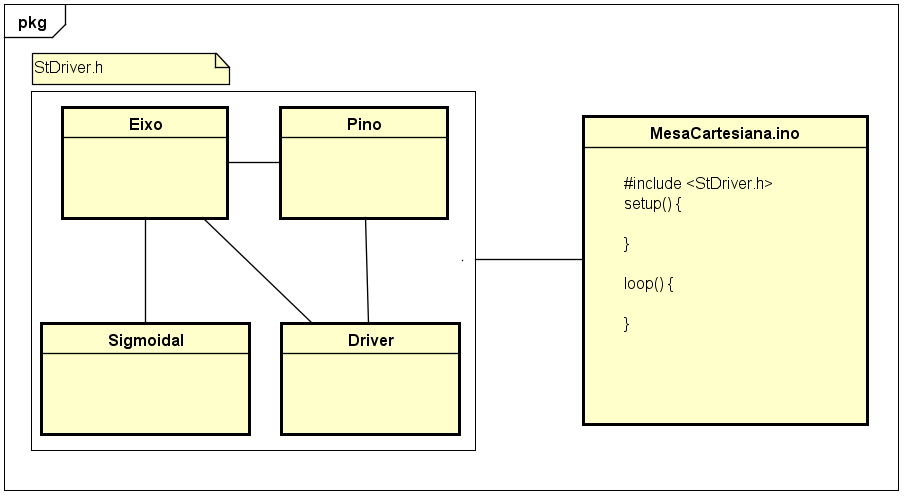
figuras/orgsoftware.png
