abaldezjr/tcc/figuras/p20x20d.jpeg

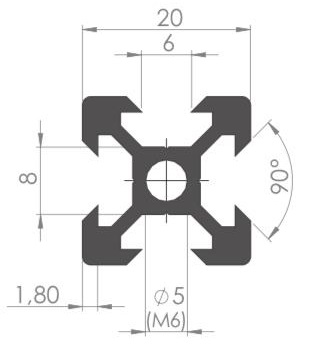
figuras/p20x20d.jpeg
