abaldezjr/tcc/figuras/pconexao90d.jpeg

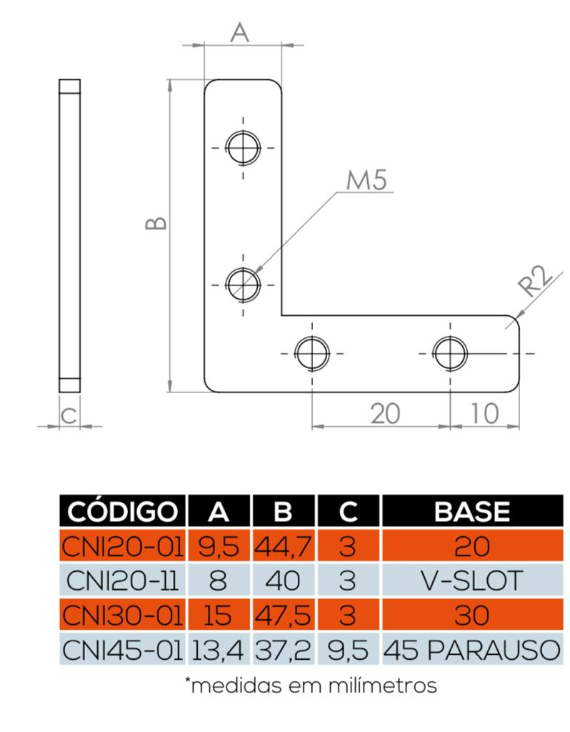
figuras/pconexao90d.jpeg
