abaldezjr/tcc/figuras/pconexao90p.jpeg

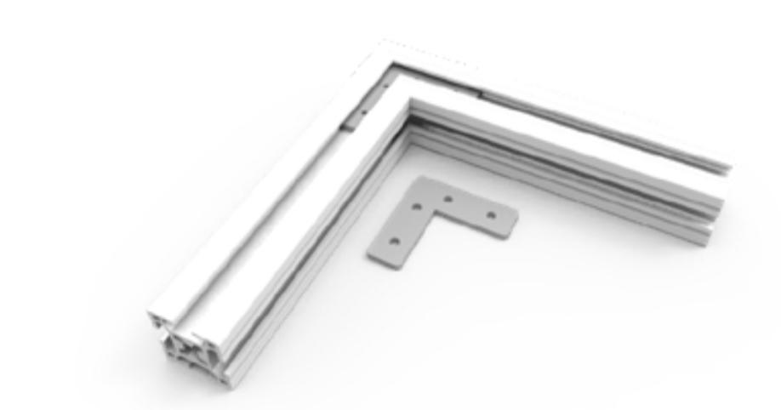
figuras/pconexao90p.jpeg
