abaldezjr/tcc/figuras/pestagnacao.png

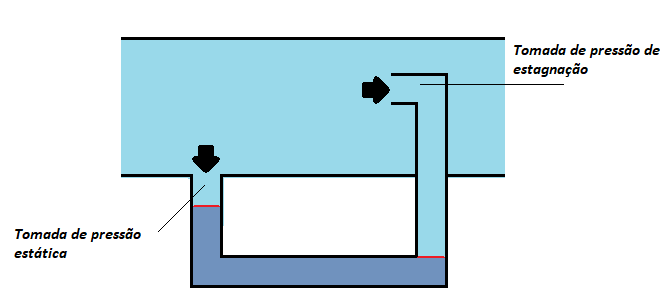
figuras/pestagnacao.png
