abaldezjr/tcc/figuras/placatd.jpeg

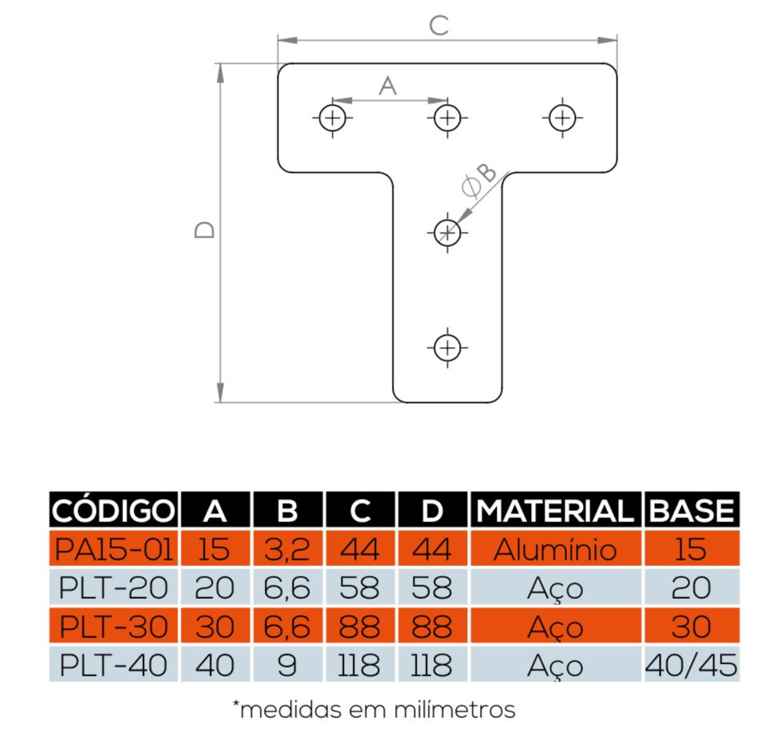
figuras/placatd.jpeg
