abaldezjr/tcc/figuras/placatp.jpeg

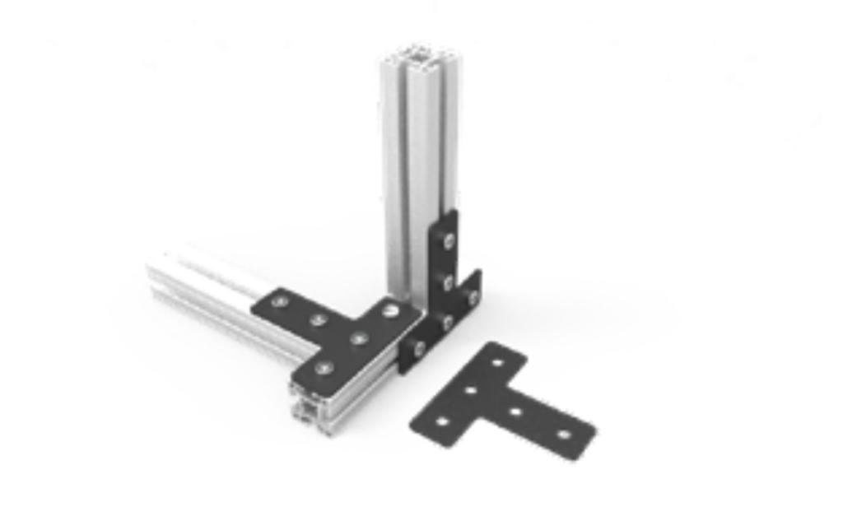
figuras/placatp.jpeg
