abaldezjr/tcc/figuras/ressuporteelevacao.jpg

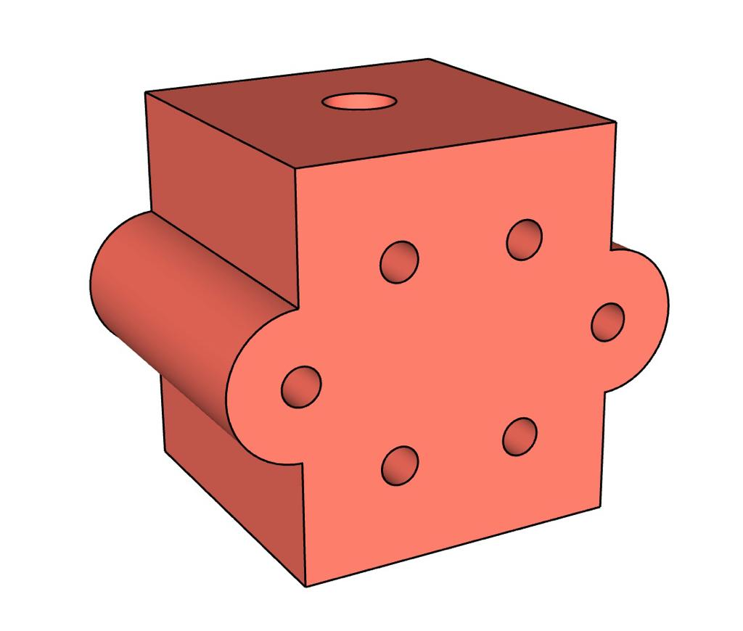
figuras/ressuporteelevacao.jpg
