abaldezjr/tcc/figuras/ressuportehastemancalf.jpg

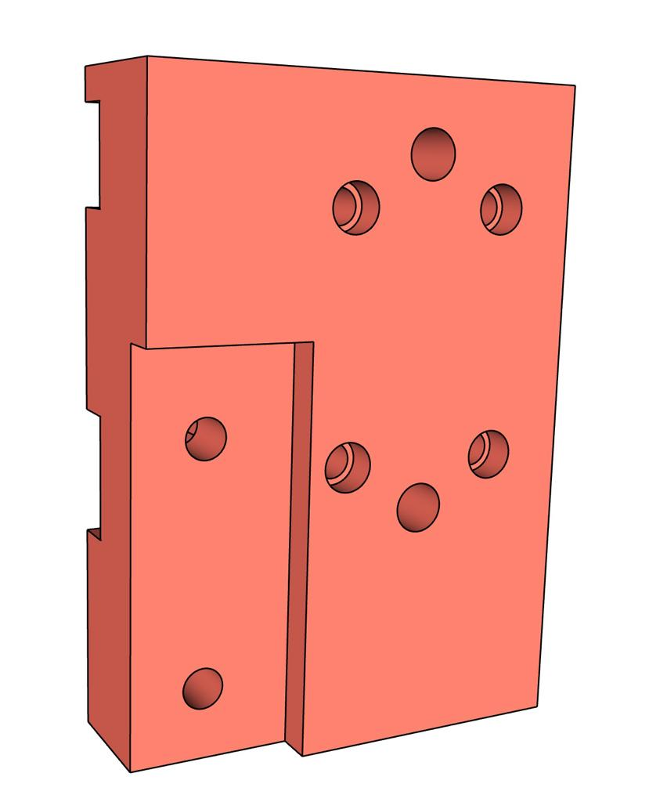
figuras/ressuportehastemancalf.jpg
