abaldezjr/tcc/figuras/ressuportehastemancalfv.jpg

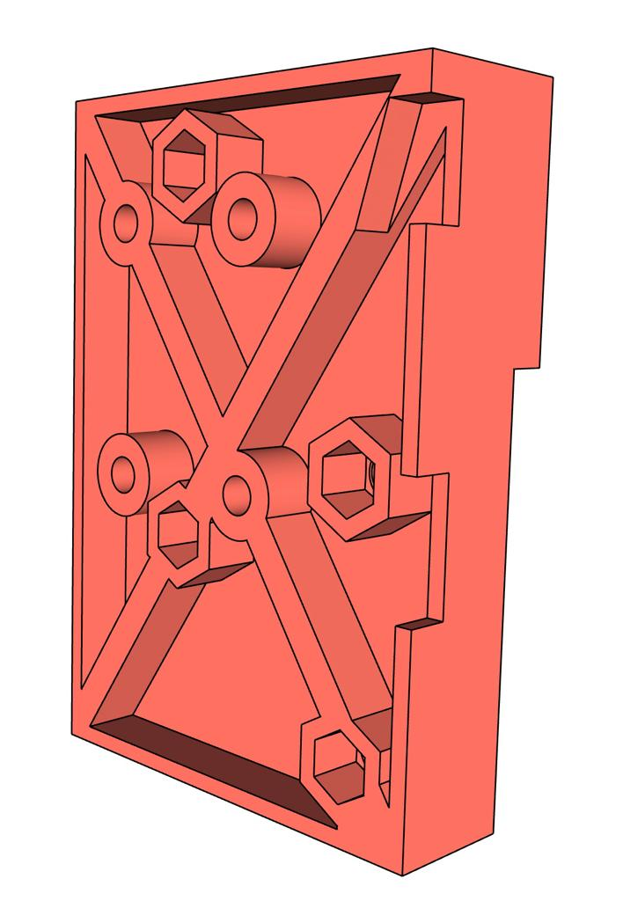
figuras/ressuportehastemancalfv.jpg
