abaldezjr/tcc/figuras/ressuportemancal.jpg

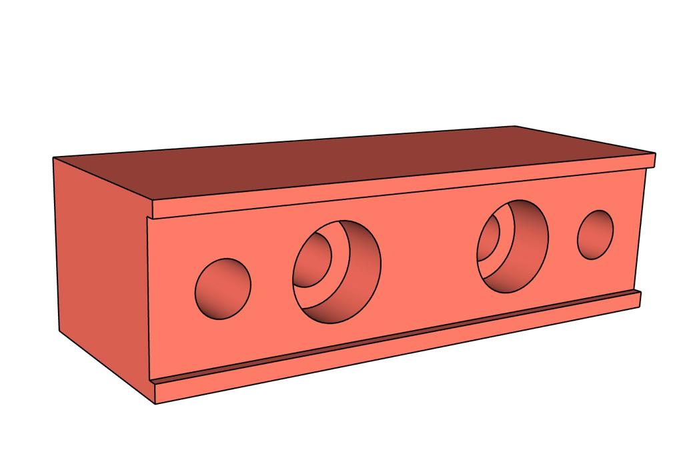
figuras/ressuportemancal.jpg
