abaldezjr/tcc/figuras/ressuportemotorhorizontalf.jpg

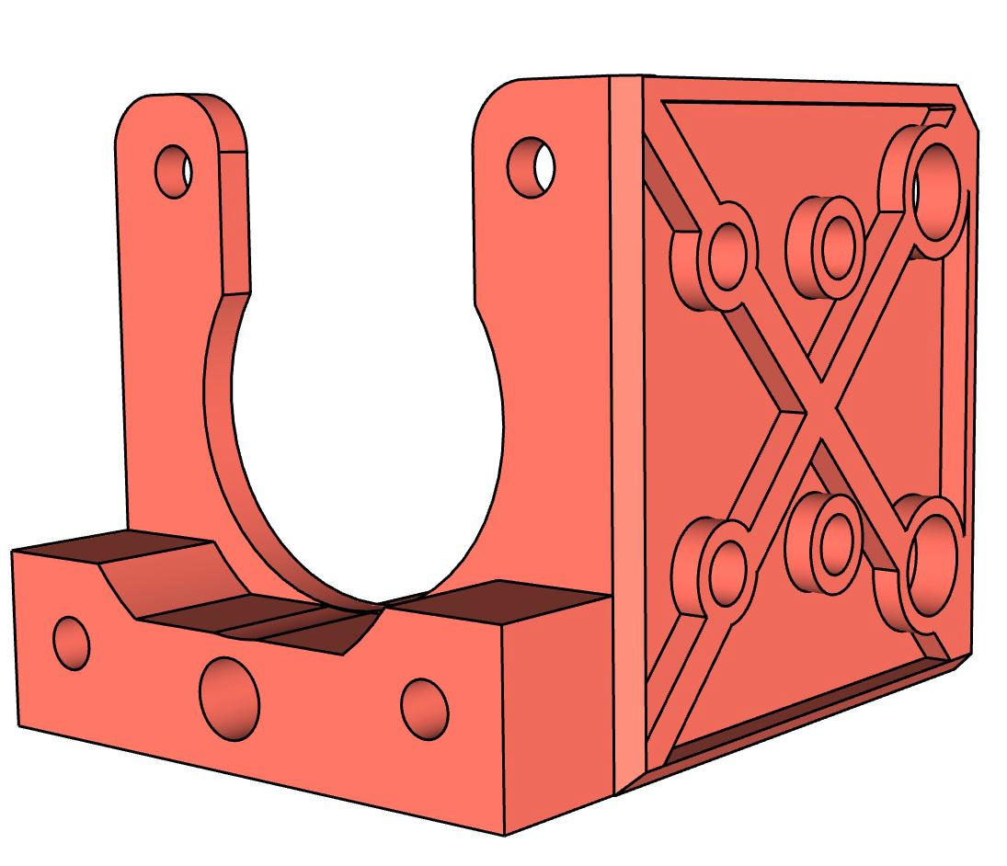
figuras/ressuportemotorhorizontalf.jpg
