abaldezjr/tcc/figuras/ressuportemotorhorizontalfv.jpg

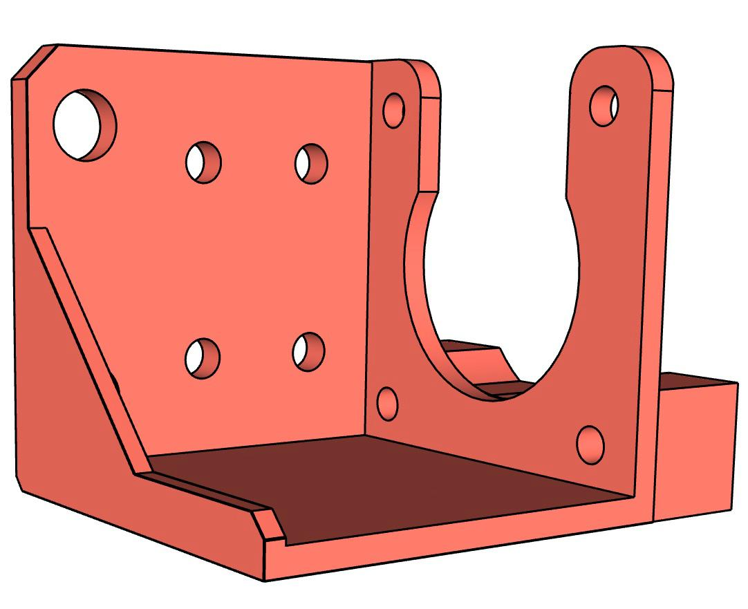
figuras/ressuportemotorhorizontalfv.jpg
