abaldezjr/tcc/figuras/ressuportemotorpasso.jpg

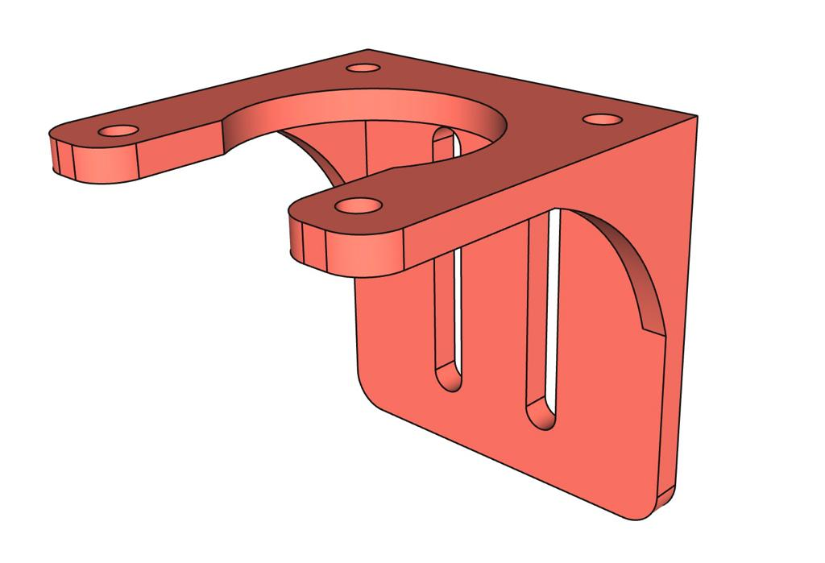
figuras/ressuportemotorpasso.jpg
