abaldezjr/tcc/figuras/ressuporteservicofrontalf.jpg

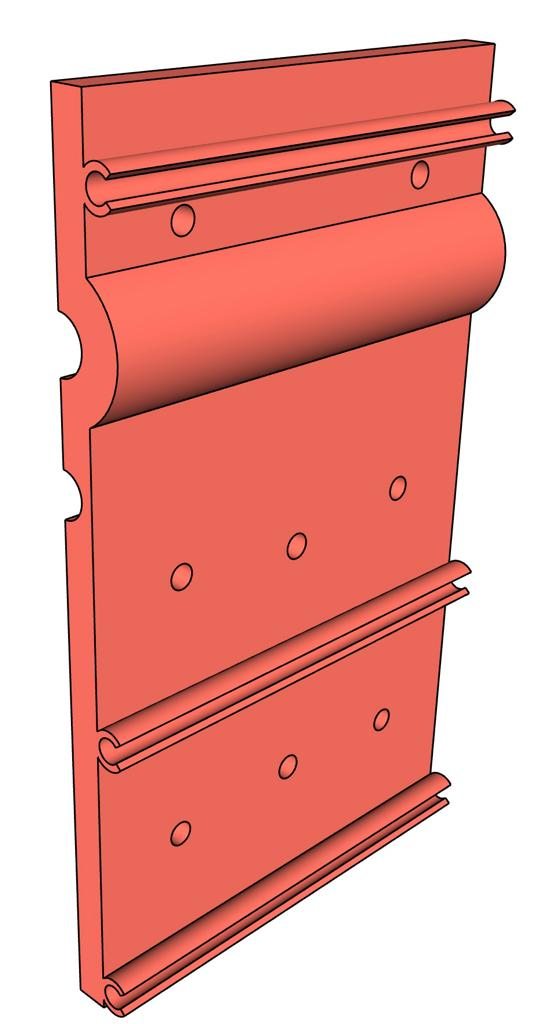
figuras/ressuporteservicofrontalf.jpg
