abaldezjr/tcc/figuras/ressuporteservicofrontalfv.jpg

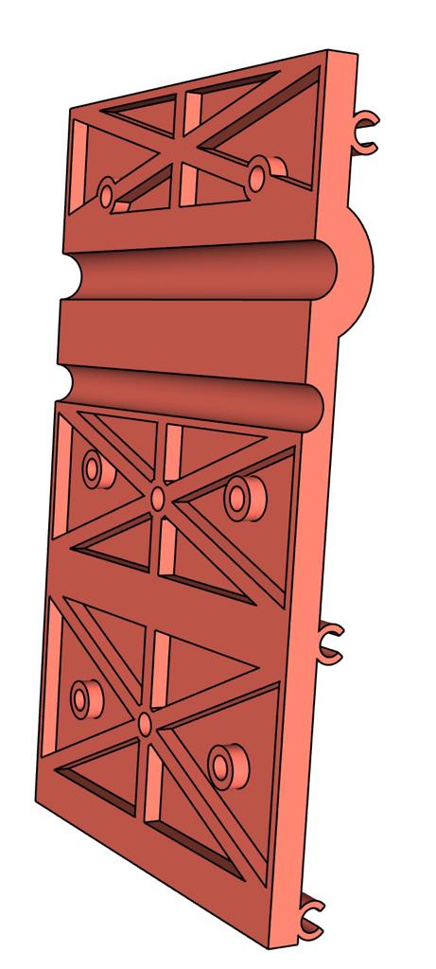
figuras/ressuporteservicofrontalfv.jpg
