abaldezjr/tcc/figuras/sisantigozoom.jpg

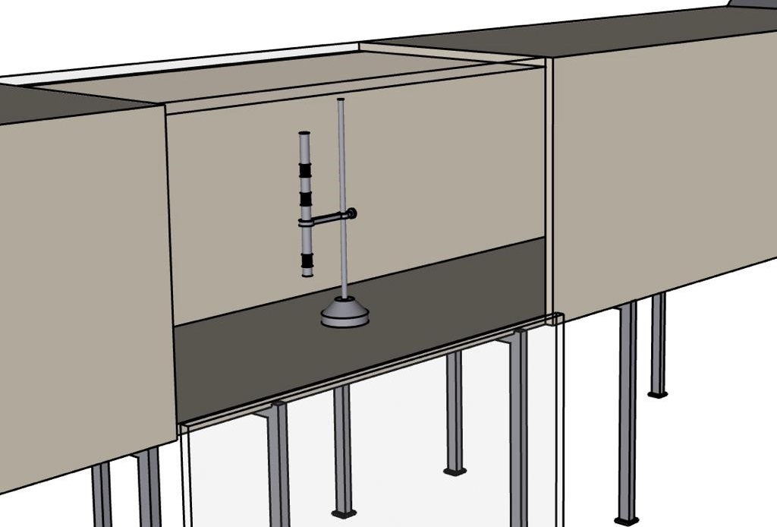
figuras/sisantigozoom.jpg
