abaldezjr/tcc/figuras/vistaexplodida.jpg

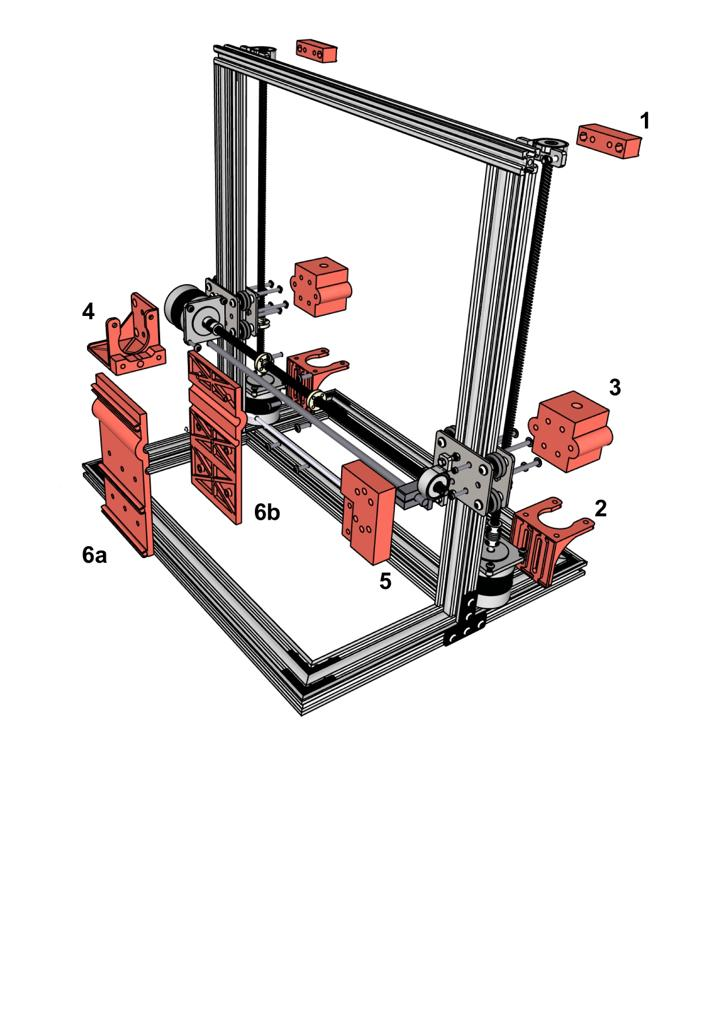
figuras/vistaexplodida.jpg
