abaldezjr/tcc/stl/suportedomancal.stl

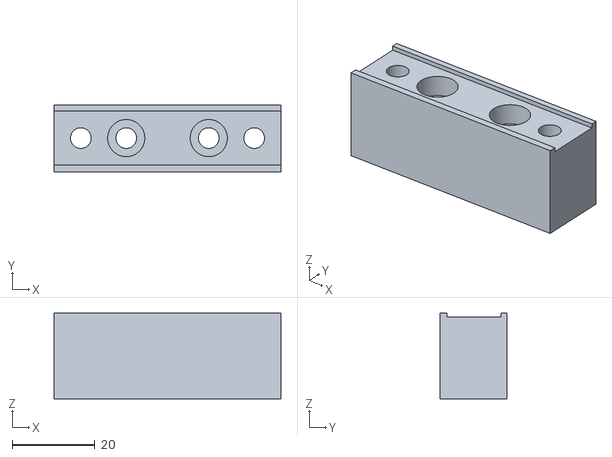
[picture p75: CAD file, 2021-05-27]
stl/suportedomancal.stl
55.0 x 16.2 x 20.8
