abaldezjr/tcc/stl/suportedeserviçofrente.stl

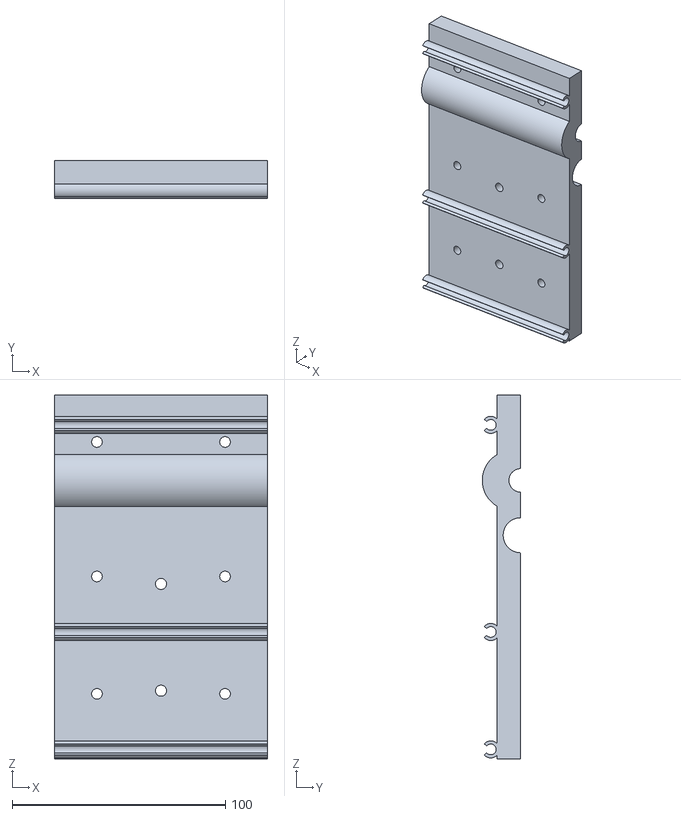
[picture p76: CAD file, 2021-05-27]
stl/suportedeserviçofrente.stl
100.0 x 18.0 x 170.5
