abaldezjr/tcc/stl/suportedeserviçoverso.stl

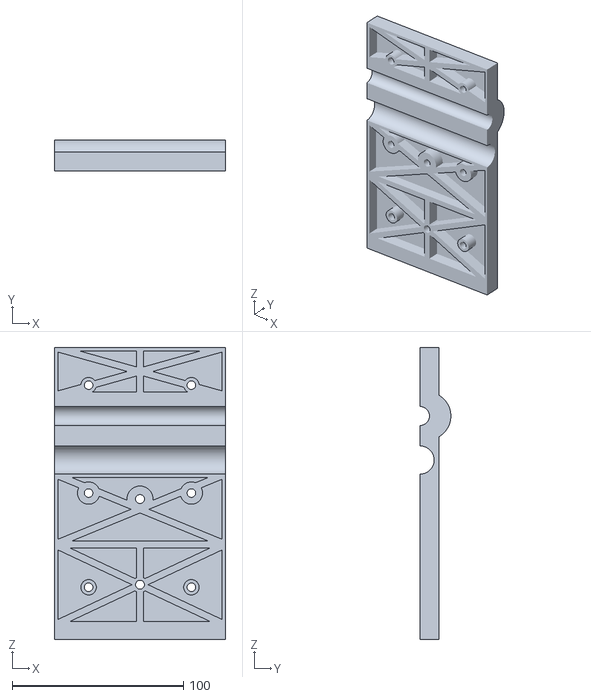
[picture p77: CAD file, 2021-05-27]
stl/suportedeserviçoverso.stl
100.0 x 18.0 x 170.5
