abaldezjr/tcc/stl/suportedomotorhorizontal.stl

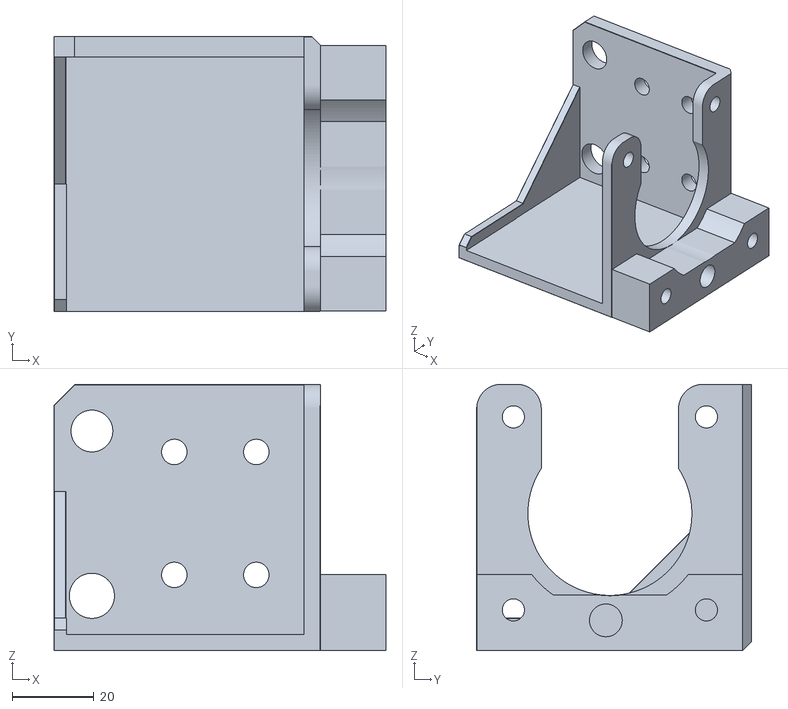
[picture p78: CAD file, 2021-05-27]
stl/suportedomotorhorizontal.stl
81.0 x 67.0 x 65.0
