abaldezjr/tcc/stl/suportedeelevação.stl

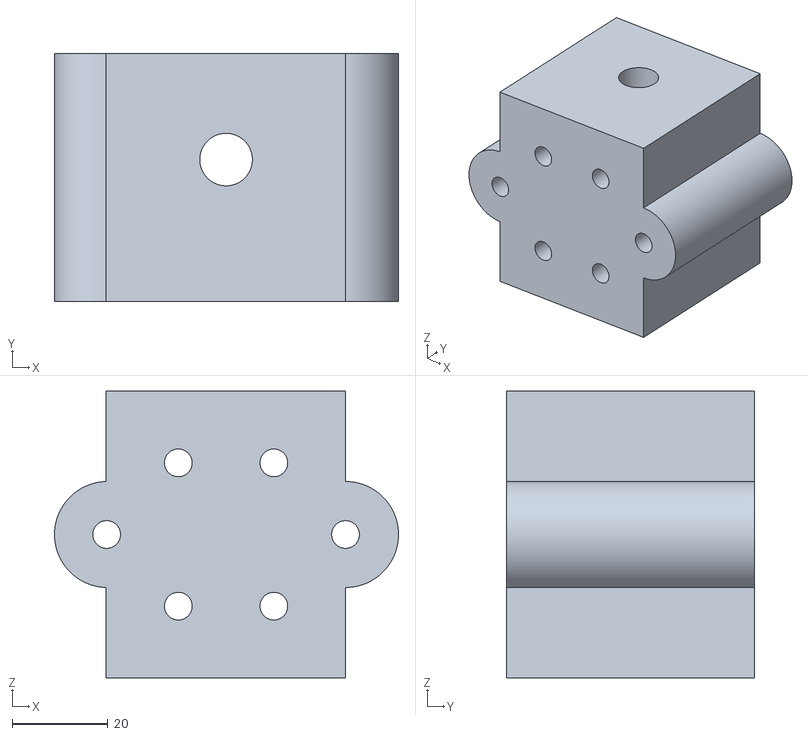
[picture p79: CAD file, 2021-05-27]
stl/suportedeelevação.stl
72.0 x 52.0 x 60.0
