abaldezjr/tcc/stl/suportedahastedomancal.stl

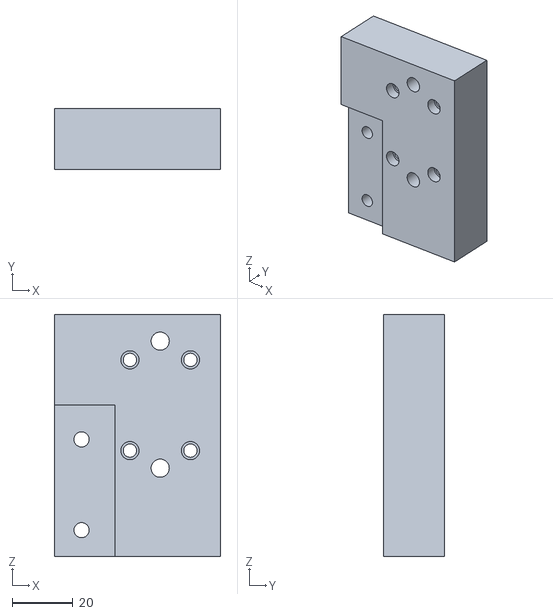
[picture p80: CAD file, 2021-05-27]
stl/suportedahastedomancal.stl
55.0 x 20.0 x 80.0
