abaldezjr/tcc/stl/suportedomotordepasso.stl

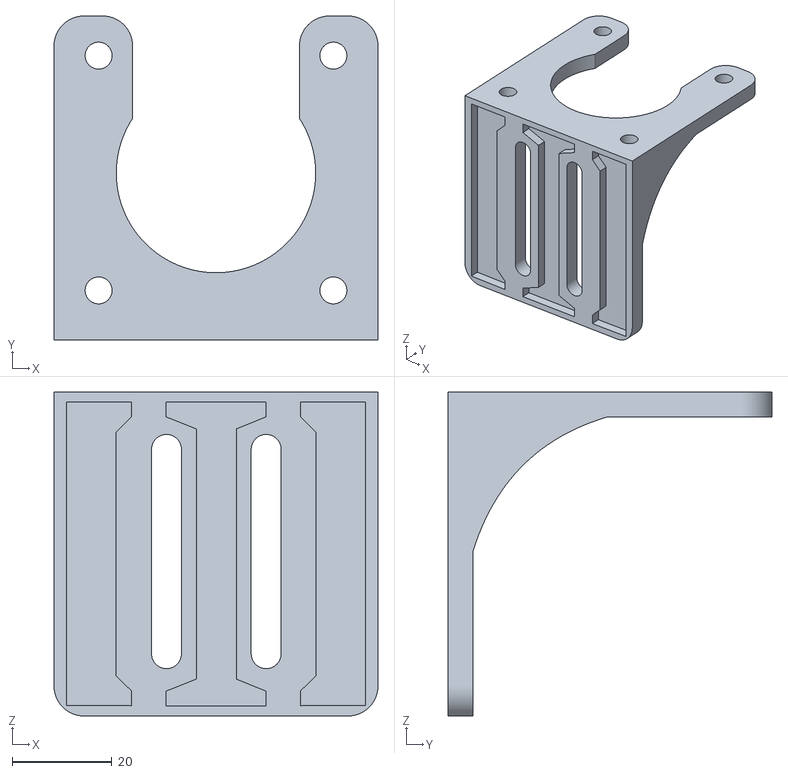
[picture p81: CAD file, 2021-05-27]
stl/suportedomotordepasso.stl
65.0 x 65.0 x 65.0
