abaldezjr/tcc/elementos-pre-textuais/errata.tex

  \noindent JUNIOR, A. M. B.;TORMA, R. D. \textbf{Sistema de coordenadas para posicionamento de instrumentos de medição em um túnel de vento}:2021. \pageref{LastPage} páginas. Monografia - Curso de Engenharia Mecânica Empresarial, Universidade Federal do Rio Grande (FURG), Rio Grande, 2021.
  
\begin{table}[h!]
	\center
	\begin{tabular}{|p{1.4cm}|p{1cm}|p{3cm}|p{3cm}|}
		\hline
		\textbf{Folha} & \textbf{Linha} & \textbf{Onde se lê} &
		\textbf{Leia-se}\\
		\hline
		1 & 10 & auto-conclavo & autoconclavo\\
		\hline
	\end{tabular}
\end{table}
