abaldezjr/tcc/(commit log)

2021-05-02 Arrumando referencias de imagens, tabelas e artigos.
2021-05-04 Ajustes em tabelas, inclusão dos códigos fonte, lista de tabelas, lista de simbolos, abstract e resumo
2021-05-06 Modificando diagrama de classes, modificando o nome do documento principal para main
2021-05-12 Modificando a função da folha de rosto
2021-05-14 Consertando bugs da folha de rosto e folha de aprovação
2021-05-18 Ultima atualização antes de entregar para o orientador
2021-05-27 Arrumando erros de ortografia
    [suportedahastedomancal.stl, suportedeelevação.stl, suportedeserviçofrente.stl, suportedeserviçoverso.stl, suportedomancal.stl, suportedomotordepasso.stl, suportedomotorhorizontal.stl]
2021-06-03 Versão Final para publicação
